eryjus/16bcfs/images/ESP32-pinout.jpg

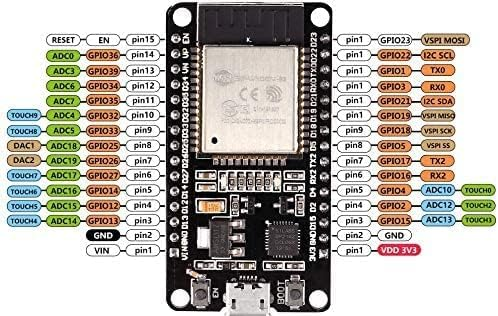
images/ESP32-pinout.jpg
