eryjus/16bcfs/kicad/README.md

# 16-Bit Computer From Scratch KiCad Library

This folder contains the KiCad files used in designing the PCBs.

---

## Videos

I am documenting my 16-Bit Computer build in video form.  You can find the entire playlist [here](https://www.youtube.com/playlist?list=PLUF7WfBe0k3g9wpTtg41QP3jl5y8T1aGV).

---

## License

See [LICENSE.md](../LICENSE.md).

---

## Fitness

Please understand that I do not represent or warranty that these schematics and PCB designs are fit for any purpose including the project for which they were intended.  I would hate for you to invest your own hard-earned money into something that may or may not work for you.  However, you are free to do what you wish with this stuff as stated in the [license](../LICENSE.md).  Just have fun with it.
