eryjus/16bcfs/documents/datasheets/README.md

# 16-Bit Computer From Scratch Documents

This folder contains publicly avilable datasheets for several components used in the build.  By the very nature of these documents being in this folder, the documents contains herein are not current.  If you have interest in any of these components, you are highly encouraged to get the datasheet for the specific manufacturer and component you are going to research.
