eryjus/16bcfs/images/high-level-design.png

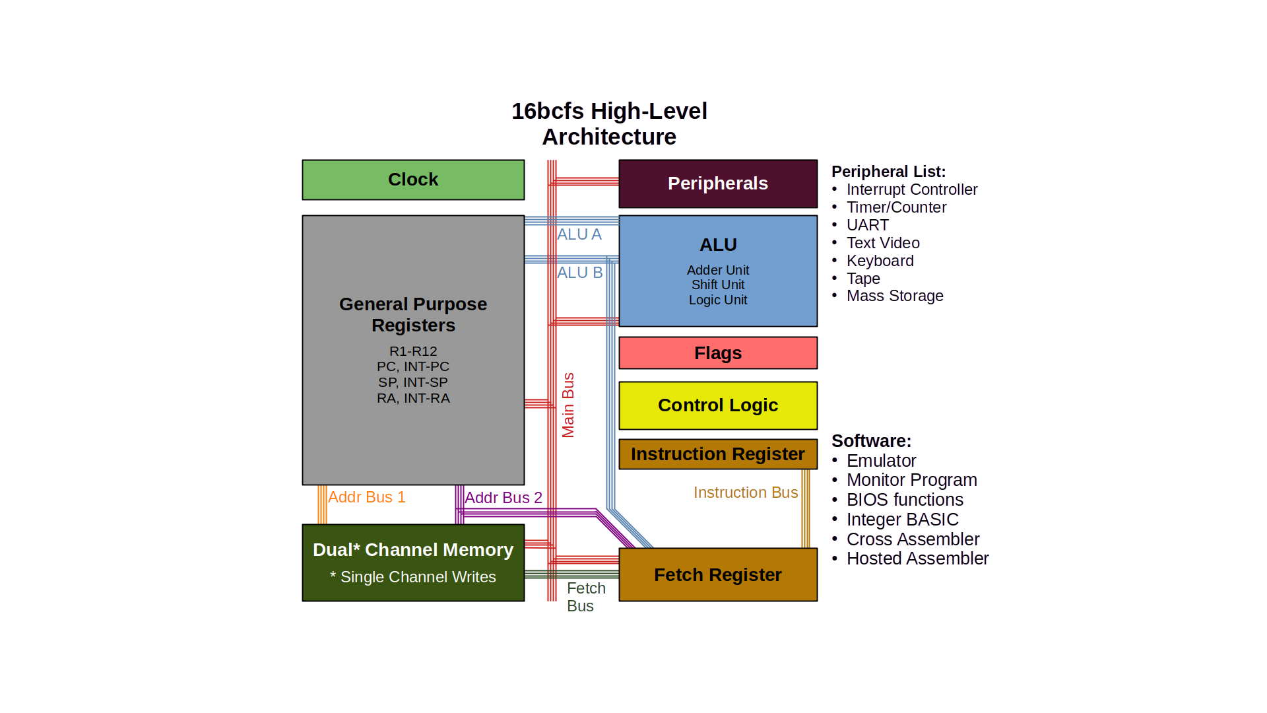
images/high-level-design.png
