eryjus/16bcfs/images/spike-clock-bad.png

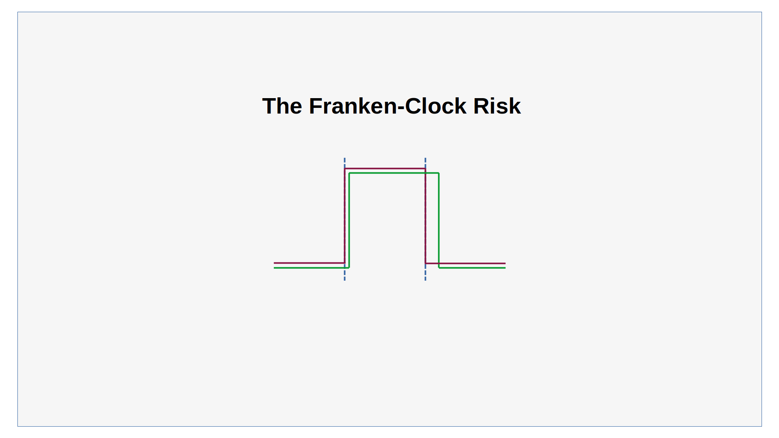
images/spike-clock-bad.png
