eryjus/16bcfs/images/spike-clock-narrow.png

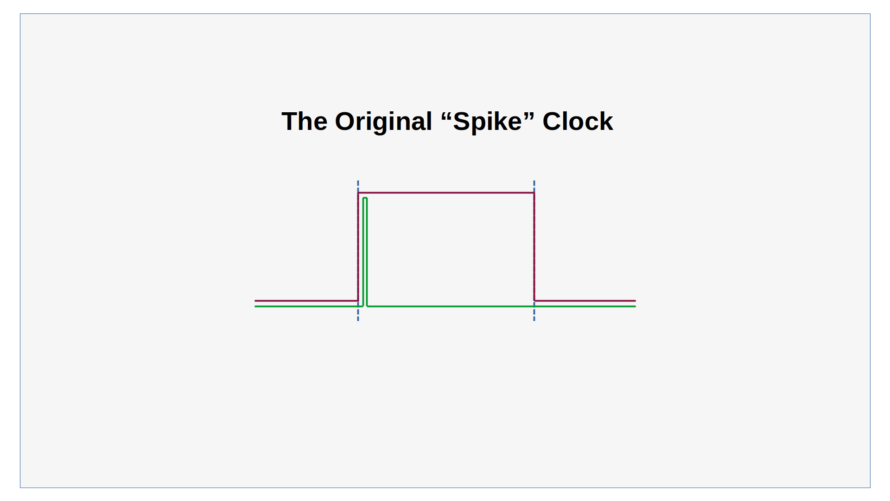
images/spike-clock-narrow.png
