eryjus/16bcfs/documents/16bcfs.ods

Sheet: OpCodes
Instruction | OpCode | None | Imm | Reg | Reg,Reg | Reg,Imm |  | 12-Bit Instruction Count | ALU OP? | Bits Req | Actual Instruction Count | Recovered Instruction Count
 |  | 1 | 1 | 25 | 225 | 25
Add | ADD |  |  |  | X | X |  | 196 | Y
Add with Carry | ADC |  |  |  | X | X |  | 196 | Y
Bitwise And | AND |  |  |  | X | X |  | 506 | Y
Arithmetic Shift Left (into Carry; 0-Fill) | ASL |  |  | X |  |  |  | 22 | Y
Arithmetic Shift Right (Into Carry; Sign-Fill) | ASR |  |  | X |  |  |  | 22 | Y
Break | BRK | X |  |  |  |  |  | 1 |  |  | 1 | 0
Branch to Subroutine | BSR |  | X | X |  |  |  | 14
Clear Carry | CLC | X |  |  |  |  |  | 1 | Y
Clear Overflow | CLV | X |  |  |  |  |  | 1 | Y
Compare using Subtract | CMP |  |  |  | X | X |  | 196 | Y
Decrement | DEC |  |  | X |  |  |  | 22 | Y
Get I/O Device Status | IN |  |  |  | X |  |  | 120
Increment | INC |  |  | X |  |  |  | 22
Software Interrupt | INT | X |  |  |  |  |  | 1
Interrupt Return | IRT | X |  |  |  |  |  | 1
Jump | JMP |  | X | X |  |  |  | 14 |  |  | 1 | 13
Load from Memory | LOD |  |  |  |  |  |  | 12
Logical Shift Left (into Carry; 0-Fill) | LSL |  |  |  |  |  | = ASL | 0 | Y
Logical Shift Right (into Carry; 0-Fill) | LSR |  |  | X |  |  |  | 22 | Y
Move (Reg/Port to Reg/Port) | MOV |  |  |  | X | X |  | 624
Swap & Move (Reg/Port) | MVS |  |  |  |  |  |  | 240
Negate (2's Complement) | NEG |  |  | X |  |  |  | 22 | Y
No Operation | NOP | X |  |  |  |  |  | 1 |  |  | 1 | 0
Bitwise Not | NOT |  |  | X |  |  |  | 22 | Y
Bitwise Or | OR |  |  |  | X | X |  | 506 | Y
Control I/O Device | OUT |  |  |  | X | X |  | 130
Return from Subroutine | RET | X |  |  |  |  |  | 1
Rotate Left (through Carry) | RCL |  |  | X |  |  |  | 22 | Y
Rotate Right (through Carry) | RCR |  |  | X |  |  |  | 22 | Y
Subtract with Borrow | SBB |  |  |  | X | X |  | 196 | Y
Set Carry | STC | X |  |  |  |  |  | 1 | Y
Store Value into Memory | STO |  |  |  |  |  |  | 12
Set Overflow | STV | X |  |  |  |  |  | 1 | Y
Subtract | SUB |  |  |  | X | X |  | 196 | Y
Swap Bytes In Reg | SWP |  |  | X |  |  | = MVS | 0
Test using Bitwise And | TST |  |  | X |  |  |  | 22 | Y
Bitwise Exclusive Or | XOR |  |  |  | X | X |  | 506 | Y
 |  |  |  |  |  |  |  | 3893 |  | 12 | 3 | 13
 |  |  |  |  |  |  | Tracking | 3880
Macros
Push to Stack | PUSH <reg> |  | DEC SP; MOV [SP],<reg>;
Pop from Stack | POP <reg> |  | MOV <reg>,SP; INC SP;
Rotate Left more than 1 bit | ROL <reg>,n |  | ROL <reg>; ROL <reg>; …
Rotate Right more than 1 bit | ROR <reg>,n |  | ROR <reg>; ROR <reg>; …
Shift Left more than 1 bit | SHL <reg>,n |  | SHL <reg>; SHL <reg>; …
Shift Right more than 1 bit | SHR <reg>,n |  | SHR <reg>; SHR <reg>; …

Sheet: Instructions
 | 0 | 1 | 2 | 3 | 4 | 5 | 6 | 7 | 8 | 9 | A | B | C | D | E | F
000 | NOP | BRK | JMP imm
010
020
030
040
050
060
070
080
090
0A0
0B0
0C0
0D0
0E0
0F0
100
110
120
130
140
150
160
170
180
190
1A0
1B0
1C0
1D0
1E0
1F0
200
210
220
230
240
250
260
270
280
290
2A0
2B0
2C0
2D0
2E0
2F0
300
310
320
330
340
350
360
370
380
390
3A0
3B0
3C0
3D0
3E0
3F0
400
410
420
430
440
450
460
470
480
490
4A0
4B0
4C0
4D0
4E0
4F0
500
510
520
530
540
550
560
570
580
590
5A0
5B0
5C0
5D0
5E0
5F0
600
610
620
630
640
650
660
670
680
690
6A0
6B0
6C0
6D0
6E0
6F0
700
710
720
730
740
750
760
770
780
790
7A0
7B0
7C0
7D0
7E0
7F0
800
810
820
830
840
850
860
870
880
890
8A0
8B0
8C0
8D0
8E0
8F0
900
910
920
930
940
950
960
970
980
990
9A0
9B0
9C0
9D0
9E0
9F0
A00
A10
A20
A30
A40
A50
A60
A70
A80
A90
AA0
AB0
AC0
AD0
AE0
AF0
B00
B10
B20
B30
B40
B50
B60
B70
B80
B90
BA0
BB0
BC0
BD0
BE0
BF0
C00
C10
C20
C30
C40
C50
C60
C70
C80
C90
CA0
CB0
CC0
CD0
CE0
CF0
D00
D10
D20
D30
D40
D50
D60
D70
D80
D90
DA0
DB0
DC0
DD0
DE0
DF0
E00
E10
E20
E30
E40
E50
E60
E70
E80
E90
EA0
EB0
EC0
ED0
EE0
EF0
F00
F10
F20
F30
F40
F50
F60
F70
F80
F90
FA0
FB0
FC0
FD0
FE0
FF0

Sheet: 16-Bit Computer From Scratch
 |  |  |  |  | MOV |  | ALU Add |  | ALU Logic |  | ALU Other | IN |  | OUT |  | LOD/STO | BRA/JMP | MVS
 |  |  |  |  | 26 | 24 | 14 | 14 | 22 | 23 | 22 | 10 | 12 | 13 | 10 | 12 | 14 | 12 | 10
Registers: | Reg (PCB) # | Name | Ctl Sel/Idx | Description | SRC | DST | A | B | A | B | A | SRC | DST | SRC | DST | A | A | SRC | DST
 |  | RZ (none) | 0x00 | Zero Register (No Register Selected); asserts 0x0000 | Y |  |  | Y
 | 1 | R1 | 0x01 | R1 General Purpose Register | Y | Y | Y | Y | Y | Y | Y |  | Y | Y |  | Y | Y | Y
 | 2 | R2 | 0x02 | R2 General Purpose Register | Y | Y | Y | Y | Y | Y | Y |  | Y | Y |  | Y | Y | Y
 | 3 | R3 | 0x03 | R3 General Purpose Register | Y | Y | Y | Y | Y | Y | Y |  | Y | Y |  | Y | Y | Y
 | 4 | R4 | 0x04 | R4 General Purpose Register | Y | Y | Y | Y | Y | Y | Y |  | Y | Y |  | Y | Y | Y
 | 5 | R5 | 0x05 | R5 General Purpose Register | Y | Y | Y | Y | Y | Y | Y |  | Y | Y |  | Y | Y | Y
 | 6 | R6 | 0x06 | R6 General Purpose Register | Y | Y | Y | Y | Y | Y | Y |  | Y | Y |  | Y | Y | Y
 | 7 | R7 | 0x07 | R7 General Purpose Register | Y | Y | Y | Y | Y | Y | Y |  | Y | Y |  | Y | Y | Y
 | 8 | R8 | 0x08 | R8 General Purpose Register | Y | Y | Y | Y | Y | Y | Y |  | Y | Y |  | Y | Y | Y
 | 9 | R9 | 0x09 | R9 General Purpose Register | Y | Y | Y | Y | Y | Y | Y |  | Y | Y |  | Y | Y | Y
 | 10 | R10 | 0x0A | R10 General Purpose Register | Y | Y | Y | Y | Y | Y | Y |  | Y | Y |  | Y | Y | Y
 | 11 | R11 | 0x0B | R11 General Purpose Register | Y | Y | Y | Y | Y | Y | Y |  | Y | Y |  | Y | Y | Y
 | 12 | R12 | 0x0C | R12 General Purpose Register | Y | Y | Y | Y | Y | Y | Y |  | Y | Y |  | Y | Y | Y
 | 13 | SP | 0x0D | User Stack Pointer | Y | Y | Y
 | 14 | RA | 0x0E | User Return Address | Y | Y | Y |  |  |  |  |  |  |  |  |  | Y
 | 15 | PC | 0x0F | User Program Counter
 | 16 | INTSP | 0x10 | Interrupt Stack Pointer
 | 17 | INTRA | 0x11 | Interrupt Return Address
 | 18 | INTPC | 0x12 | Interrupt Entry Point (& Program Counter)
 |  | Fetch | 0x13 | Fetch Register | Y |  |  | Y |  | Y |  |  |  | Y |  |  | Y
 |  | Dev1 | 0x14 | I/O Device #1 (Interrupt Controller) | Y | Y |  |  | Y | Y | Y | Y |  |  | Y |  |  |  | Y
 |  | Dev2 | 0x15 | I/O Device #2 (Timer) | Y | Y |  |  | Y | Y | Y | Y |  |  | Y |  |  |  | Y
 |  | Dev3 | 0x16 | I/O Device #3 (Text Video) | Y | Y |  |  | Y | Y | Y | Y |  |  | Y |  |  |  | Y
 |  | Dev4 | 0x17 | I/O Device #4 (Keyboard) | Y | Y |  |  | Y | Y | Y | Y |  |  | Y |  |  |  | Y
 |  | Dev5 | 0x18 | I/O Device #5 (UART) | Y | Y |  |  | Y | Y | Y | Y |  |  | Y |  |  |  | Y
 |  | Dev6 | 0x19 | I/O Device #6 (Tape?) | Y | Y |  |  | Y | Y | Y | Y |  |  | Y |  |  |  | Y
 |  | Dev7 | 0x1A | I/O Device #7 (Floppy?) | Y | Y |  |  | Y | Y | Y | Y |  |  | Y |  |  |  | Y
 |  | Dev8 | 0x1B | I/O Device #8 | Y | Y |  |  | Y | Y | Y | Y |  |  | Y |  |  |  | Y
 |  | Dev9 | 0x1C | I/O Device #9 | Y | Y |  |  | Y | Y | Y | Y |  |  | Y |  |  |  | Y
 |  | Dev10 | 0x1D | I/O Device #10 | Y | Y |  |  | Y | Y | Y | Y |  |  | Y |  |  |  | Y
 |  | Memory | 0x1E | Memory I/O
 |  | N/A | 0x1F
 |  | ALU | 0x20 | ALU Adder Result
 |  | ALU | 0x21 | ALU Logic Unit Result
 |  | ALU | 0x22 | ALU Shifter Result
 |  | N/A | 0x23
 |  | Ctl1 | 0x24 | Control I/O Device #1 (Interrupt Controller)
 |  | Ctl2 | 0x25 | Control I/O Device #2 (Timer)
 |  | Ctl3 | 0x26 | Control I/O Device #3 (Keyboard)
 |  | Ctl4 | 0x27 | Control I/O Device #4 (Video)
 |  | Ctl5 | 0x28 | Control I/O Device #5 (UART)
 |  | Ctl6 | 0x29 | Control I/O Device #6 (Tape?)
 |  | Ctl7 | 0x2A | Control I/O Device #7 (Floppy?)
 |  | Ctl8 | 0x2B | Control I/O Device #8
 |  | Ctl9 | 0x2C | Control I/O Device #9
 |  | Ctl10 | 0x2D | Control I/O Device #10
 |  | N/A | 0x2E
 |  | N/A | 0x2F
 |  | N/A | 0x30
 |  | N/A | 0x31
 |  | N/A | 0x32
 |  | N/A | 0x33
 |  | N/A | 0x34
 |  | N/A | 0x35
 |  | N/A | 0x36
 |  | N/A | 0x37
 |  | N/A | 0x38
 |  | N/A | 0x39
 |  | N/A | 0x3A
 |  | N/A | 0x3B
 |  | N/A | 0x3C
 |  | N/A | 0x3D
 |  | N/A | 0x3E
 |  | N/A | 0x3F
Addressing Modes: | Number | Name | Example | Description
 | 0 | None |  | No addressing mode included in instruction (HLT)
 | 1 | Imm | $1234 | This instruction contains a single argument which is a constant in the instruction stream(JMP $0xe000)
 | 2 | Imm_Ind | [1234] | This is an address Location which contains that value to use (JMP [0xe000])
 | 3 | Reg | R1 | Instuction contains a single register as its target (INC R1)
 | 4 | Reg_Ind | [R1] | R1 contains the value of an address of a memory location on which to operate (INC [R1])
 | 5 | Reg,Reg | R1,R2 | Instruction contains 2 arguments, each are registers (ADD R1,R2)
 | 6 | Reg,Imm | R1,$1234 | Instrution contains 1 target register, and 1 constant in the instruction stream (ADD R1,$255)
 | 7 | Imm_Ind,Reg | [1234],R1 | Instruction contains a memory location and a register (STO [1234],R1)
 | 8 | Reg,Imm_Ind | R1,[1234] | Instruction contains a register memory location (LOD R1,[1234])
 | 9 | Reg_Ind,Reg | [R2],R1 | Instruction contains a Register with the memory Location and a register (STO [R2],R1)
 | 10 | Reg,Reg_Ind | R1,[R2] | Instruction contains a register memory location (LOD R1,[1234])
Register Select Uses | Registers | Use | Ctl Select
Standard Registers | RZ - PC | (Typical) | 0b00
Extended Data | INTSP - Mem | (Data) | 0b01
IO Control | Ctl1 - Ctl10 | (Control) | 0b10
Instruction Suffix | N/A | (Instructions) | 0b11 | Not currently planned; maybe for future expansion
Conditional Execution | Mnemonic | Encoding |  | Condition (Note: L = 1 when N != V)
Always | .AL or None | 0000
Never | .NV | 0001
Equal | .EQ | 0010 |  | Z = 1
Not Equal | .NE | 0011 |  | Z = 0
Carry Set | .CS | 0100 |  | C = 1
Carry Clear | .CC | 0101 |  | C = 0
Minus | .MI | 0110 |  | N = 1
Positive or Zero | .PL | 0111 |  | N = 0
Overflow Set | .VS | 1000 |  | V = 1
Overflow Clear | .VC | 1001 |  | V = 0
Unsigned Higher | .HI | 1010 |  | C = 1 and Z = 0
Lower or Same | .LS | 1011 |  | C = 0 or Z = 1
Signed Greater or Equal | .GE | 1100 |  | L = 0
Signed Less Than | .LT | 1101 |  | L = 1
Signed Greater Than | .GT | 1110 |  | Z = 0 and L = 0
Signed Less Than or Equal | .LE | 1111 |  | Z = 1 or L = 1

Sheet: Build Sequence
Video | Description | OpCodes | Instr Enc | Total Enc
113 | Fetch/Instruction Register Breadboards | NOP | 1 | 1
114 | Program Counter Breadboard & Program ROM | BRK JMP imm | 2 | 3
115 | Fetch/Instruction PCBs |  |  | 3
116 | Clock PCB |  |  | 3
117 | Reset PCB |  |  | 3
118 | C/R/I/F Mid-Plane |  |  | 3
119 | R1, R2 GPRs (Fetch Suppress Cleanup) | MOV reg,imm MOV reg,reg MVS reg,reg JMP reg INC reg DEC reg SWP reg | 18 | 21
120 | GP Register PCB |  |  | 21
121 | Register Mid-Plane PCB (R1-R12, PC) |  | 1038 | 1059
122 | RA GPR | BSR imm BSR reg RET | 6 | 1065
123 | ALU Adder | ADD reg,imm ADD reg,reg | 255 | 1320
124 | Carry Select | ADC reg,imm ADC reg,reg | 255 | 1575
125 | ALU Flags (Pgm) | CLC STC CLV STV | 4 | 1579
126 | Conditional Execution |  |  | 1579
127 | Invert ALUb | CMP reg,imm CMP reg,reg SUB reg,imm SUB reg,reg SBB reg,imm SBB reg,reg NEG reg | 777 | 2356
128 | ALU Logic Unit | AND reg,imm AND reg,reg OR reg,imm OR reg,reg TST reg,imm TST reg,reg XOR reg,imm XOR reg,reg | 672 | 3028
129 | ALU Shift Unit | ASL reg ASR reg LSL reg LSR reg ROL reg ROR reg ASL reg,x ASR reg,x LSL reg,x LSR reg,x ROL reg,x ROR reg,x | 60 | 3088
130 | ALU Adder Unit PCB |  |  | 3088
131 | ALU Logical Unit PCB |  |  | 3088
132 | ALU Shift Unit PCB |  |  | 3088
133 | ALU Flags PCB |  |  | 3088
134 | ALU Mid-Plane (2 Flags Regs) |  |  | 3088
135 | RAM | LOD reg,[imm] LOD reg,[reg] STO [imm],reg STO [reg],reg PUSH reg POP reg | 344 | 3432
136 |  |  |  | 3432
137 |  |  |  | 3432
138 |  |  |  | 3432
 |  |  |  | 3432
