eryjus/16bcfs/16bcfs-tests/README.md

# 16-Bit Computer From Scratch -- Test Code

This is the source code that supports my *16-Bit Computer From Scratch* project.  This project in particular contains all the source code I use to test parts of the computer as it is being built.

---

## Videos

I am documenting my 16-Bit Computer build in video form.  You can find the entire playlist [here](https://www.youtube.com/playlist?list=PLUF7WfBe0k3g9wpTtg41QP3jl5y8T1aGV).

---

## License

See [LICENSE.md](LICENSE.md).

---

## EEPROM Programmer

I do not have a commercial EEPROM programmer.  I use the TommyPROM programmer.  You can find all the relevant information on TommyPROM [here](https://tomnisbet.github.io/TommyPROM/).  In Linux, I use `minicom` as the interface.  Hint: use `sudo minicom -s` to set up the defaults.
