eryjus/16bcfs/(threads)

Thread 2 (2023-11-19):

Combine the UI and Hardware emulator into a single class

eryjus, 2023-11-19:
The current design is a mistake, causing extra work to be completed with each change.

Combining the 2 classes will allow all the `connect`ions to be handled in one place, making the resulting KiCad schematics easier to manage.

Closed 2023-11-19.

Thread 3 (2023-11-19):

Create a new Clock Module schematic

eryjus, 2023-11-19:
This new clock module will properly separate the clock from the reset circuitry.  Reset will now be handled separately.

This new Clock Module schematic will be built based on the hardware components (like the 555 for single step) and based on the emulator for the digital circuits.

eryjus, 2023-11-23:
This is created in Video 82, Part 7 and presented as a complete work in Part 8

Closed 2023-11-25.

Thread 5 (2023-11-19):

Create a proper Clock Module for the emulator, properly defining its interface points

eryjus, 2023-11-19:
The Clock Module is currently just a mess of components spread across several sources.  This really should be consolidated into a single module, which would correspond to the proper kicad schematic and PCB.

eryjus, 2023-11-23:
This is presented in Video 82, Part 6

Closed 2023-11-25.

Thread 8 (2023-11-20):

Add a Control Signal which will place the clock in single step mode

eryjus, 2023-11-20:
This control signal will be used as a `BRK` opcode in the final computer, placing the computer into step mode.  Ultimately, this circuit will be implemented as a Leading Edge Detector (inverted) from the AND8408 document from OnSemi.

It will contain an RC circuit which will not be directly emulated.  The results can be emulated.

eryjus, 2023-11-22:
This coding is now complete and is presented in Video 82, Part 5.

Closed 2023-11-25.

Thread 9 (2023-11-20):

Create a Reset Control Signal for the clock

eryjus, 2023-11-20:
This signal should be an active-low signal to conform to the voltage supervisor.  This signal will place the clock into run mode, overriding any existing mode on the clock.

This reset would be triggered on power-on and by manual input.  Note that a separate signal will be used elsewhere (not by the clock) to hold the cpu in reset until all modules were ready.  This would be an open-drain type circuit with a pull-up resistor.

eryjus, 2023-11-22:
This coding is now complete and is presented in Video 82, Part 5.

Closed 2023-11-25.

Thread 10 (2023-11-23):

Need to separate the Load signal from Inc/Dec on the GP Register

eryjus, 2023-11-23:
The current design of the GP-Register is killing the build.  The fatal flaw is the Load signal was combined with the Inc and Dec signals.  This needs to be corrected.

To accomplish this, the counter will be pulled in parallel with the the outputs on each bus, and bus output will be replaced with 74HC574 Latches instead of 74HC541 Line Drivers.

To get this right, a small internal GP-Register bus local to the one register will be needed, which will be able to take input from the main bus externally, or the counter output internally.

Closed 2023-12-04.

Thread 11 (2023-11-23):

Create a Schematic for the new GP-Register

eryjus, 2023-11-23:
Once the GP-Register is emulating properly, create a KiCad schematic for this.  This will be after the module appears to be working properly but before the in-depth testing is completed.

eryjus, 2023-12-11:
This is the main purpose of Video 84 and is complete.

Closed 2023-12-20.

Thread 19 (2023-11-24):

Create a Reset Hold (#RHLD) signal where a module can hold the cpu in reset if desired

eryjus, 2023-11-24:
This would be implemented as a single-bit bus.

eryjus, 2024-04-04:
This has been done for the Control ROM Control Module.  It was tested with an ESP32.  This is close to being completed at least in principle.

Closed 2024-11-15.

Thread 25 (2023-12-11):

Reset is dependent on the latch in the Register Module

eryjus, 2023-12-11:
This may or may  not be a problem.  Monitor this and determine if a fix is required.

eryjus, 2024-12-02:
This is going to be a non-issue.  The Reset signal for the GP-Register (R̅H̅L̅D̅) will hold the Up/Down counters in clear.  The clock will latch that value.

Closed 2024-12-02.

Thread 31 (2023-12-11):

Create a Reset Module, which will hold the CPU in Reset as long as needed to complete all initialization

eryjus, 2023-12-11:
The emulator needs to be able to be reset.  This will happen on power-on, manually triggering a reset, or when the voltage gets too low (on real hardware only).

Closed 2024-11-15.

Thread 34 (2023-12-12):

Add labels to the assembler

eryjus, 2023-12-12:
The assembler needs to support labels.  Add this ability to the assembler.  Both backward and forward references need to be supported.

Also, intermediate jump points (`.1`) need to be supported as well.

Since I believe that this worked at some point prior, I am calling this a bug and will sort this out as such.

Closed 2024-05-09.

Thread 35 (2023-12-12):

Add the ability to create an opcode header file without intruducing a fake source

eryjus, 2023-12-12:
The current workaround is to have a dummy source which is assembled and then the object file removed.  This is clunky and a better option would be to have command line options to generate this file on demand and without a source.

Closed 2024-06-07.

Thread 49 (2023-12-31):

Commit the EEPROM SPI Programmer to solderful breadboard

eryjus, 2023-12-31:
Rather than keeping the new SPI programmer on breadboard, this really should be committed to a solderful breadboard.  This will make it a little more robust while testing prior to committing it to proper PCB.

Closed 2024-01-31.

Thread 65 (2024-01-14):

the first `asm` directive must start in column 1

eryjus, 2024-01-14:
This is not what is wanted and is preventing some testing from taking place.

To clarify: this is what is designed into the scanner, and should be able to differentiate between architecture directives and assembler directives.  The key difference is that there needs to be something that better differentiates between them.  Once thought is to replace the leading period in the architecture directives with a colon so that they can be easily identified.

So, rather than `.little-endian`, the directive would be `:little-endian` and would remain at the start of the line, whereas the other assembler directives could appear anywhere (`.org`).

eryjus, 2024-01-14:
No longer a blocking issue

eryjus, 2024-05-05:
Currently, `.arch`, `.path` and `.include` all need to appear at the start of a line.  All the architecture definition directives need to be be at the start of a line, but are all preceded with a `'.'` character.

The only other 2 assembler directives are currently `.org` and `.db` and both can appear anywhere.

So, here is what I propose:
1. All architecture directives are replaced with a `':'` character.
2. `.arch`, `.path` and `.include` are replaced with a `'%'` character as they all deal fundamentally with files.
3. `.org` and `.db` remain unchanged.

This change will also trigger updates to the test code and the test automation.

eryjus, 2024-05-05:
These changes have been made and all tests updated.

Closed 2024-05-09.

Thread 77 (2024-01-23):

Create a Control ROM Controller

eryjus, 2024-01-23:
This controller will handle holding the circuit in reset until the copy is complete.  It will handle multiplexing the Control ROM copy address and the Instruction which will be needed while running.  It will handle the serial shift into the SPI EEPROM as all Control ROMs will need the same signals.  It will contain its own clock for the sake of speed (selectable?), but after reset the clock will be handled by the normal system clock.  These are likely to be separate clock signals.

Closed 2024-01-30.

Thread 90 (2024-01-31):

Determine if Power-On Reset needs to be separated from soft reset

eryjus, 2024-01-31:
Power-On Reset would copy the Control ROMs to SRAM.  Soft Reset would not.

However, need to figure out about the monitor program/boot loader ROM.  No need to ignore the Control ROMs if the Program ROMs need to be copied.

Closed 2024-11-15.

Thread 96 (2024-02-05):

Video-0092: Control ROM Modules

eryjus, 2024-02-05:
The goal of this video is to:
* Emulate the control ROMs properly
* Create a schematic for the control ROM
* Build the Control ROM onto breadboard
* Build the Control ROM Control onto breadboard

Therefore, the issues included in this video are:
- [ ] #87
- [x] #78
- [x] #32
- [x] #93
- [ ] #94
- [ ] #95
---
- [ ] #97
- [ ] #99
- [x] #81
- [x] #100

Closed 2024-02-17.

Thread 97 (2024-02-16):

Emulator is not resetting properly

eryjus, 2024-02-16:
Reset is happening as each object is created.  However, there is the creation & wire-up phase which all needs to happen at once and then there will need to be a reset event once everything is connected properly.

The emulator does not do this.

This needs to be corrected immediately.

eryjus, 2024-02-16:
This is partially updated, but not nearly properly taken care of.

Thread 103 (2024-02-17):

Video-0093

eryjus, 2024-02-17:
This is a continuation from Video-0092.  The remaining goals from that video are:

* Create a schematic for the control ROM
* Build the Control ROM onto breadboard
* Build the Control ROM Control onto breadboard

---

The issues included in this video are:
- [x] #104
- [x] #105
- [x] #99
- [x] #87
- [ ] #94
- [ ] #95

Closed 2024-02-27.

Thread 104 (2024-02-17):

74HC03 is really a NAND gate

eryjus, 2024-02-17:
This is configured in the emulator as an AND gate.  This all needs to be corrected.

It currently is only used in the `CtrlRomCtrlModule_t` class in one place, so the cleanup should be easy.

It is also wrong in KiCad, having copied an AND gate rather than a NAND gate.  The symbol library needs to be cleaned up as well.

Closed 2024-02-27.

Thread 109 (2024-02-27):

Clean up the temporary breadboard "bodge" wires

eryjus, 2024-02-27:

Closed 2024-03-12.

Thread 118 (2024-03-12):

Complete Automated Testing for Control ROM Circuits

eryjus, 2024-03-12:
The Control ROM and its circuits need to have a complete test executed.  This test is best automated.

Therefore, create an Arduino (ESP32) sketch to execute the tests on the control circuits and confirm that it is working perfectly.

Closed 2024-03-31.

Thread 134 (2024-04-27):

Video-0098 Plan

eryjus, 2024-04-27:
Video 0098 will focus on multiplexing several bus signals at the control logic.  This multiplexing will be used to prevent multiple items from asserting onto a bus at the same time.

This video is intended to handle the full story of the build:

Concept:
- [x] Bus identification
- [x] Publishers for each bus (instruction review)
- [x] Flavors of multiplexing (3 types?)

Control Logic Build:
- [x] #136

Emulator:
- [x] #135
- [x] #98
- [x] #137
- [x] #139

KiCad:
- [x] Build a 74HC238 IC and Footprint
- [x] Schematic build (3-, 4-, & 7-bit schematics)

Add-Ons:
- [x] #65
- [x] #63
- [x] #144
- [x] #143
- [x] #142
- [x] #61
- [x] #59
- [x] #56
- [x] #36
- [x] #34

There will not be a need to develop PCB designs yet.

Closed 2024-05-09.

Thread 145 (2024-05-08):

Change Assembler to be 16bcfs-specific

eryjus, 2024-05-08:
Remove the ability for the assembler to target multiple architectures.  This will simplify the assembler quite a bit.

- [ ] #35

eryjus, 2024-05-24:
I have started this assembler and it is working (I believe) up to the same point as the published assembler (except for generating the header for the control ROM logic).  It is currently hosted in GitHub as a private repo.

The next steps here will be to copy over all the test code from each episode and make sure they all assemble properly.  Labels are working properly now.  I may even try to take on some additional tasks

Closed 2024-06-07.

Thread 154 (2024-06-10):

Revisit the LED Line Driver for the Control ROM Module in the Emulator

eryjus, 2024-06-10:
There is a concern with the location of the LEDs in the emulator in the Control ROM Module.  When the location of the LEDs is in the correct location, only the quick copy works in the full emulator (as of Video 101).  On the other hand, when the LEDs are on the bus, the pedantic copy works but the quick copy does not update the data properly.

This is most likely a timing or sequencing problem.  But it works properly on breadboard and the Schematic and PCB were built from a working circuit.  It would be nice to have the emulator working 100%.

Closed 2024-08-25.

Thread 162 (2024-06-23):

Emulator Clock tick is too linear

eryjus, 2024-06-23:
Currently in the emulator a clock tick is handled completely linearly from end to end in a single function (slot) call.  As a result, the sequence in which items are constructed and "wired up" matters.  More than it should.

One solution I think needs to be implemented is to split the clock cycle into 2 parts, each with the following tasks to complete.

* Phase 1 would capture the inputs as they currently stand.  No outputs would change with this phase.  These new values would be stored internally to the component.  So signals would be sent.
* Phase 2 would then extend the new values to the outputs.  At this point, the signals would be offered to any subscribing slots, allowing the changes to finally be propagated to downstream inputs.

This would require a change to the Clock Module to issue both signals in turn.

Now, this may create additional issues as a clock signal might be inverted and since an inverter is not going to handle the second clock signal, the significance would be lost.

~So, in Qt6, is it possible to list or iterate of all subscribers?~

Maybe it is not relevant to propagate down each signal and slot relationship....  Could it be good enough that each object contains an optional slot to be called by the Clock Module signal once the clock tick is complete?

---

Normal connections exist; add a new connection of Latch to Clock subscribing to `Complete Clock Transition`.

D -> Latch Input
Clock -> Inv -> Latch Clk

* D is updated, presented on Latch Input.
* Clock is updated HIGH; Inv Updates input and ouput; Latch is presented its new clock State LOW; no changes.
* Clock sends out its `Complete Clock Transition` signal; Latch checks current Clock input & does nothing.
* Clock is updated LOW; Inv Updates input and ouput; Latch is presented its new clock State HIGH; captures new state.
* Clock sends out its `Complete Clock Transition` signal; Latch checks current Clock input & presents new outputs.

Closed 2024-08-30.

Thread 170 (2024-08-25):

Video-0104

eryjus, 2024-08-25:
This video will focus on assembling the Control ROM Control Module PCB and 16 of the Control ROM Modules.  The objective in this video will be to get these modules 100% ready for placement into the Control Logic Mid-Plane -- which is intended to be assembled in the next video.

In alignment with getting these modules ready, the Control ROM Control Module has some changes which need to be updated in the schematic and PCB design.  These will be updated as well.

- [ ]

Closed 2024-09-09.

Thread 171 (2024-08-30):

Control ROM Control Module LED removal

eryjus, 2024-08-30:
The Control ROM Control Module does not need LEDs since the information displayed would be incongruent with the values latched.  So, remove the LEDs (driver and resistors as well) from the schematic and PCB design.  No need to materially change the footprint.

Change the capacitance values from 0.1uF to 100nF.

Closed 2024-12-25.

Thread 172 (2024-08-30):

Control ROM Module silkscreen

eryjus, 2024-08-30:
The Control ROM Module does not have a proper module label on it.  In addition, the reference markings are not close to pin1 and should be corrected.

Closed 2024-12-25.

Thread 173 (2024-09-07):

Control ROM Mid-Plane has a silkscreen error

eryjus, 2024-09-07:
CtrlF is missing.  It was mis-labeled as a second CtrlE.

Can the silkscreen be scraped away as a workaround?

Closed 2024-12-25.

Thread 174 (2024-09-07):

Power Capacitors are too close on the Control Logic Mid-Plane

eryjus, 2024-09-07:
These should be rotated 90 degrees to make the soldering simpler.

Closed 2024-12-25.

Thread 176 (2024-09-09):

Video-0108

eryjus, 2024-09-09:
This video is intended to focus on developing a proper reset circuit.  This circuit will perform the following functions:

* Place the entire circuit into reset (on power up and on demand)
* Hold reset-stepping of the CPU until the all components report in that they are ready for execution
* Hold the registers in clear and suppressing output of the Program ROM/RAM until the reset-stepping is complete to clear the Fetch and the Instruction Registers
* Finally, release the Reset Hold signal so that normal operation can resume

These issues will be completed as part of this design:

- [x] #90
- [x] #31
- [x] #19

Closed 2024-11-15.

Thread 177 (2024-09-14):

Pin alignment for the Control ROM Control Module

eryjus, 2024-09-14:
The pins for the 16-pin wide ROM interconnect appear to be off by 0.05" or 0.1".  This creates an alignment problem when trying to insert the PCB into the mid-plane.

Correct this issue.

Closed 2024-12-25.

Thread 179 (2024-11-03):

Control Logic Control: Rename R̅H̅L̅D̅ to C̅P̅Y̅H̅L̅D̅

eryjus, 2024-11-03:
This signal will now be dedicated to communication with the reset circuit.  The reset circuit will then in turn manage R̅H̅L̅D̅.

At the same time, can the 74HC03 be eliminated in favor of some other unused gate?

While you are at it, the name needs to be cleaned up on the mid-plane as well.

Closed 2024-12-25.

Thread 180 (2024-11-03):

Clean up the bodged signal on the PCB

eryjus, 2024-11-03:
One signal was bodged into a new pin.  This needs to be cleaned up.

Closed 2024-12-25.

Thread 181 (2024-11-03):

The DONE D-Latch might have the signals named backwards

eryjus, 2024-11-03:
I believe this works on PCB, but the names appear to be reversed.  Need to investigate this and clean up the naming if it is wrong.

Closed 2024-12-25.

Thread 182 (2024-11-03):

Video-0109

eryjus, 2024-11-03:
These are the things to do in Video-0109:

- [ ] Update the connections of the 74HC123 in the schematic to use reset
- [ ] Write the 74HC123 into the emulator, using a scheduled trigger (50ms delay)
- [ ] Complete the rename of ~{RHLD} to ~{CPYHLD}
- [ ] Get the emulator working properly with this new reset circuit

Time permitting:
- [ ] #175

Thread 183 (2024-11-03):

Update the connections of the 74HC123 in the schematic to use reset

eryjus, 2024-11-03:

eryjus, 2024-11-15:
This is not needed and will be closed.

Closed 2024-11-15.

Thread 186 (2024-11-03):

Get the emulator working properly with this new reset circuit

eryjus, 2024-11-03:

Closed 2024-11-15.

Thread 187 (2024-11-03):

U7B (74HC74) needs reset/set tied high, not low

eryjus, 2024-11-03:

eryjus, 2024-11-19:
I checked this, and the output is a defined state as it currently is.  No changes required.

Closed 2024-11-19.

Thread 189 (2024-11-04):

Separate out the reset functions to slots

eryjus, 2024-11-04:
Arrange them so that a reset can be performed by signaling a reset, such as pressing the reset button.  This single step should be responsible for putting the emulator into a known good state.

Currently, there are some uninitialized items, like Buses.

Thread 190 (2024-11-05):

The Emulator needs proper circuit reset routines

eryjus, 2024-11-05:
Reset is fubar.  Make it not sucky.

Closed 2024-12-02.

Thread 192 (2024-11-15):

Rewrite the emulator into a V2

eryjus, 2024-11-15:
The emulator needs to be rewritten into a v2 with the following objectives:

- Eliminate code duplication
- Make the code more consistent
- Handle signals/slots better
- Better handle the issue with signal sender identification, which is a problem with the buses

This work is happening in the background and will not see any video time until it is complete.

Here are the issues which are being included herein:

- [ ] #189
- [ ] #190
- [ ] #101

Thread 193 (2024-11-16):

Rename `RESET_CLK` to to `CLK` on the Reset Circuit

eryjus, 2024-11-16:

Closed 2024-12-25.

Thread 196 (2024-12-02):

Reset on Breadboard is not 100% reliable

eryjus, 2024-12-02:
Need to figure out why it is not working properly and address it.

This is a problem, so it needs to be solved prior to ordering PCBs.

Closed 2025-01-24.

Thread 200 (2024-12-24):

Remove the counter circuit from the Clock Module

eryjus, 2024-12-24:
This is handled in the reset circuit and actually causes issues with the Control ROM Midplane.

Closed 2025-01-22.

Thread 215 (2025-02-15):

Video-0114 TODOs

eryjus, 2025-02-15:
The purpose of Video 114 will be to get the Program Counter re-integrated and to get the Program ROM re-integrated.  Both should be relatively easy to accomplish, which is why I am bundling them together.

For this, I have the following items to complete:

### General (off camera)
- [x] _**Deal with power distribution**_
- [x] _**Clean up the Reset & Clock power connections between modules**_
- [x] _**Replace long signal wires with prepared ribbon cable**_

### Break Signal
- [x] Update the Assembler
- [x] Update the Control Logic & Burn new Ctrl Logic EEPROM
- [x] Write a test program for BRK & JMP
- [x] Update the Emulator and Test
- [x] Connect the Break Signal to the Clock Interface
- [x] Unit test manual instruction
- [x] Update Control Logic and Program

### Program Counter
- [x] _**Change the LED resistors to 10K (off Camera)**_
- [x] _**Clean up the issues with the breadboard (check all the signals; off camera)**_
- [x] Unit Test the PCB/Breadboard
- [x] Extend the signals to the breadboard & integrate (16: GND, CLK, GND, VCC, #RHLD, Inc, Dec, Load, GND, 6 X Asserts, GND)
- [x] Integrated Test (should see the PC counting)

### Program ROM
- [x] Change #CE to be hooked up to #RHLD
- [x] Extend #OE to be a control signal hooked up to Fetch Suppress
- [x] Connect Program ROM output to Fetch Register Input
- [x] Unit Test the Program ROM
- [x] Connect Address Bus 1 to Program ROM Address Input
- [x] Burn new Program ROM for BRK & JMP
- [x] Integrated Testing (should be able to change to single step and JMP to loop)

Closed 2025-04-20.
