eryjus/16bcfs/kicad/projects/16bcfs/clock-module/clock-module.pdf

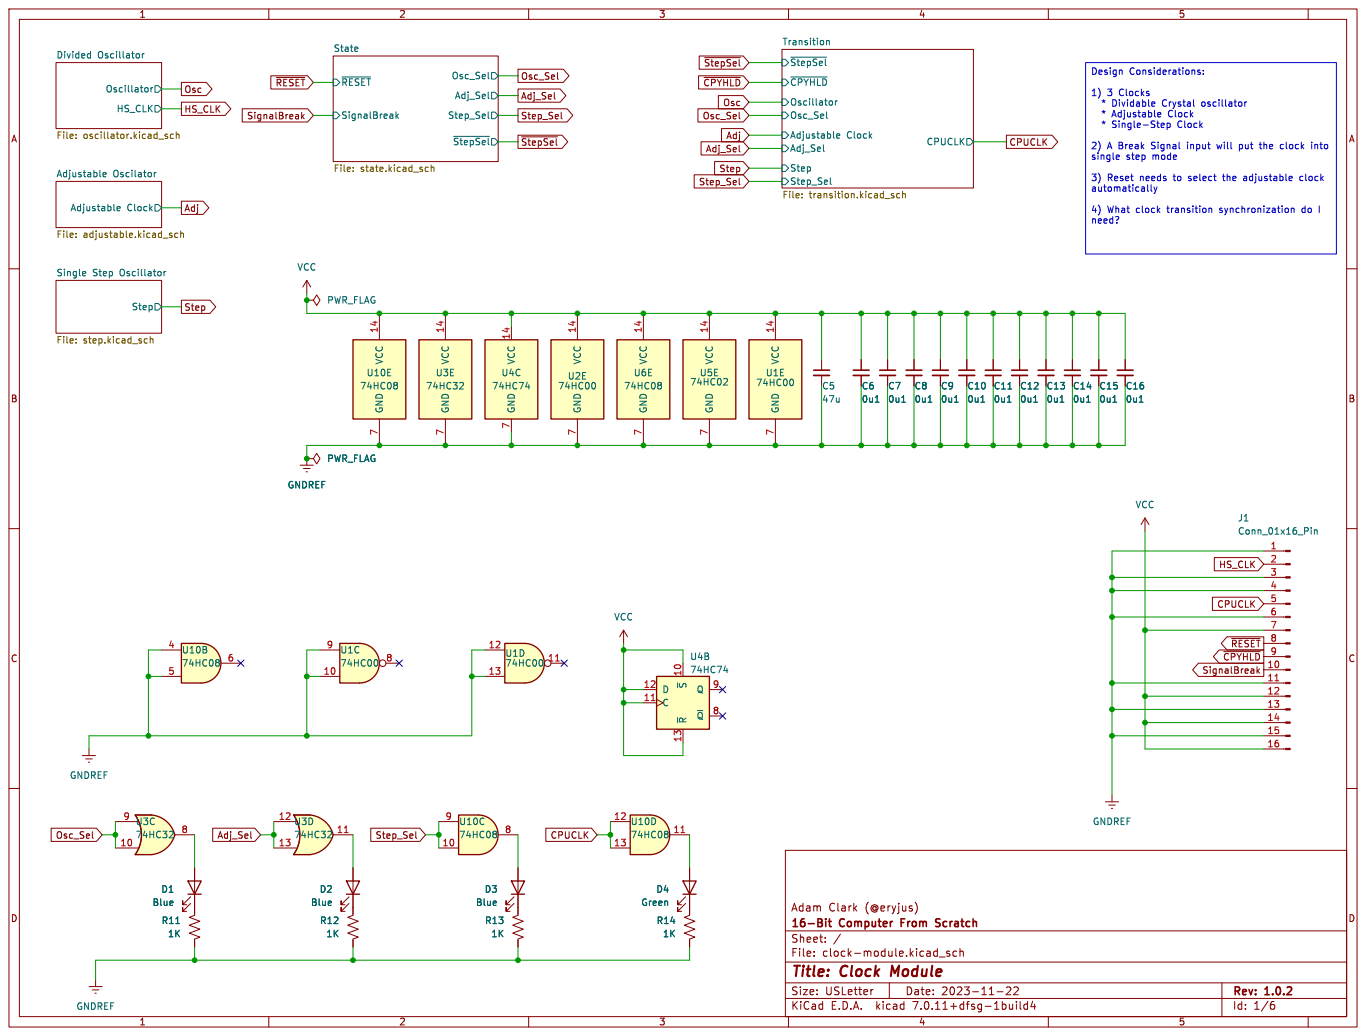
[picture p7: page 1]

~{StepSel} State File: state.kicad_sch VCC 14 GND

~{StepSel} Transition File: transition.kicad_sch Osc_Sel Adj_Sel

Single Step Oscillator File: step.kicad_sch

Id: 1/6 Title: Clock Module

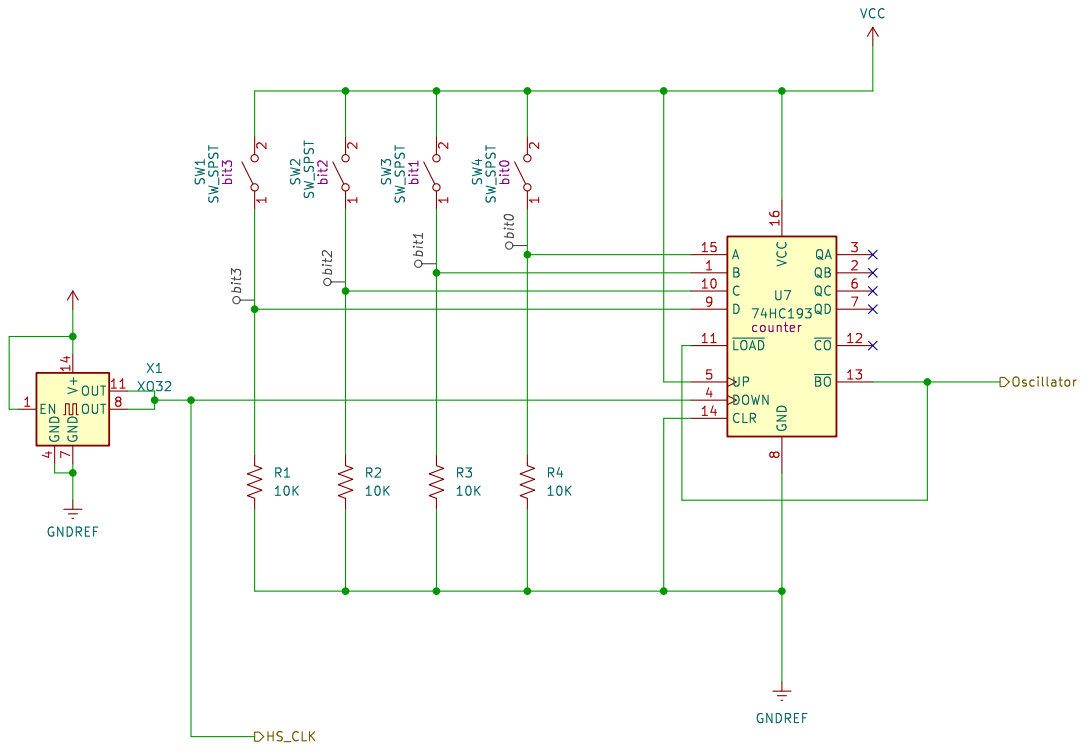
[picture p8: page 2]

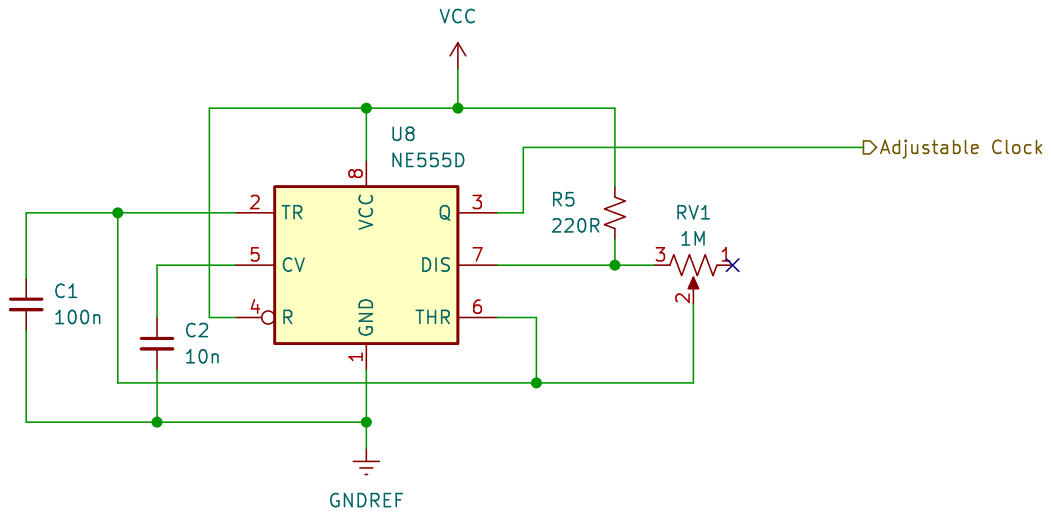
[picture p9: page 3]

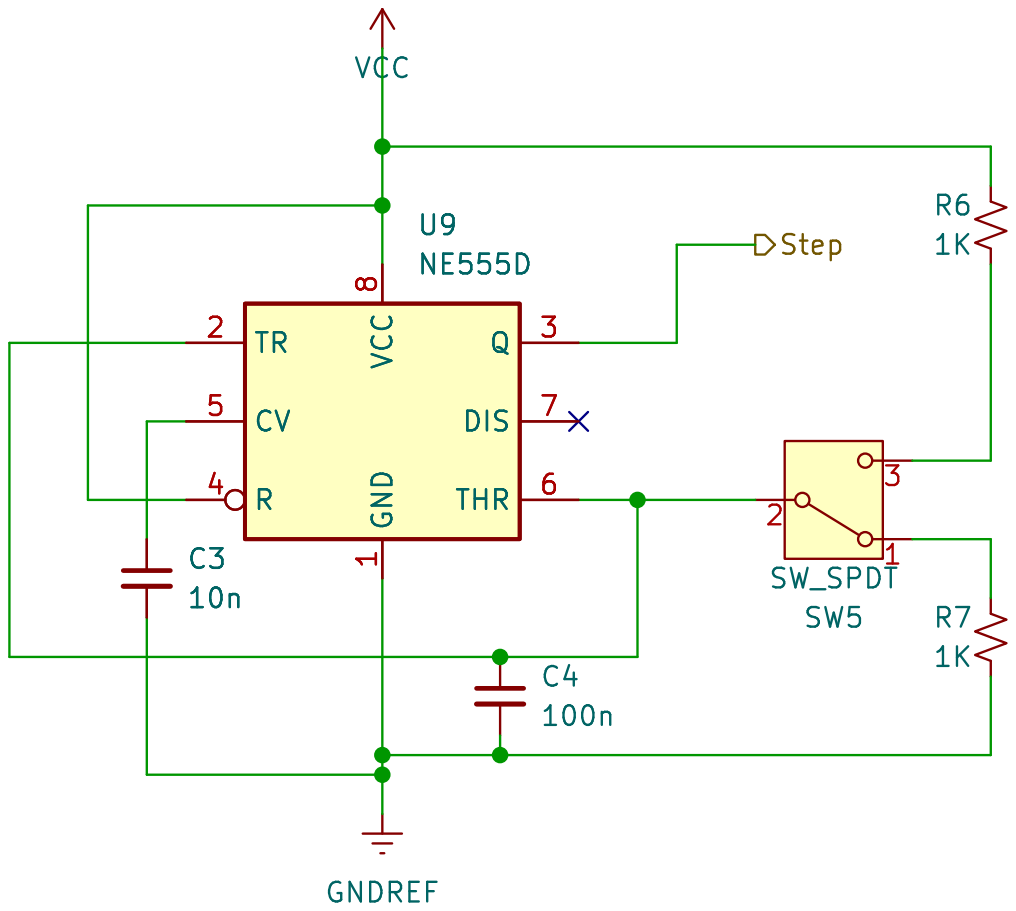
[picture p10: page 4]

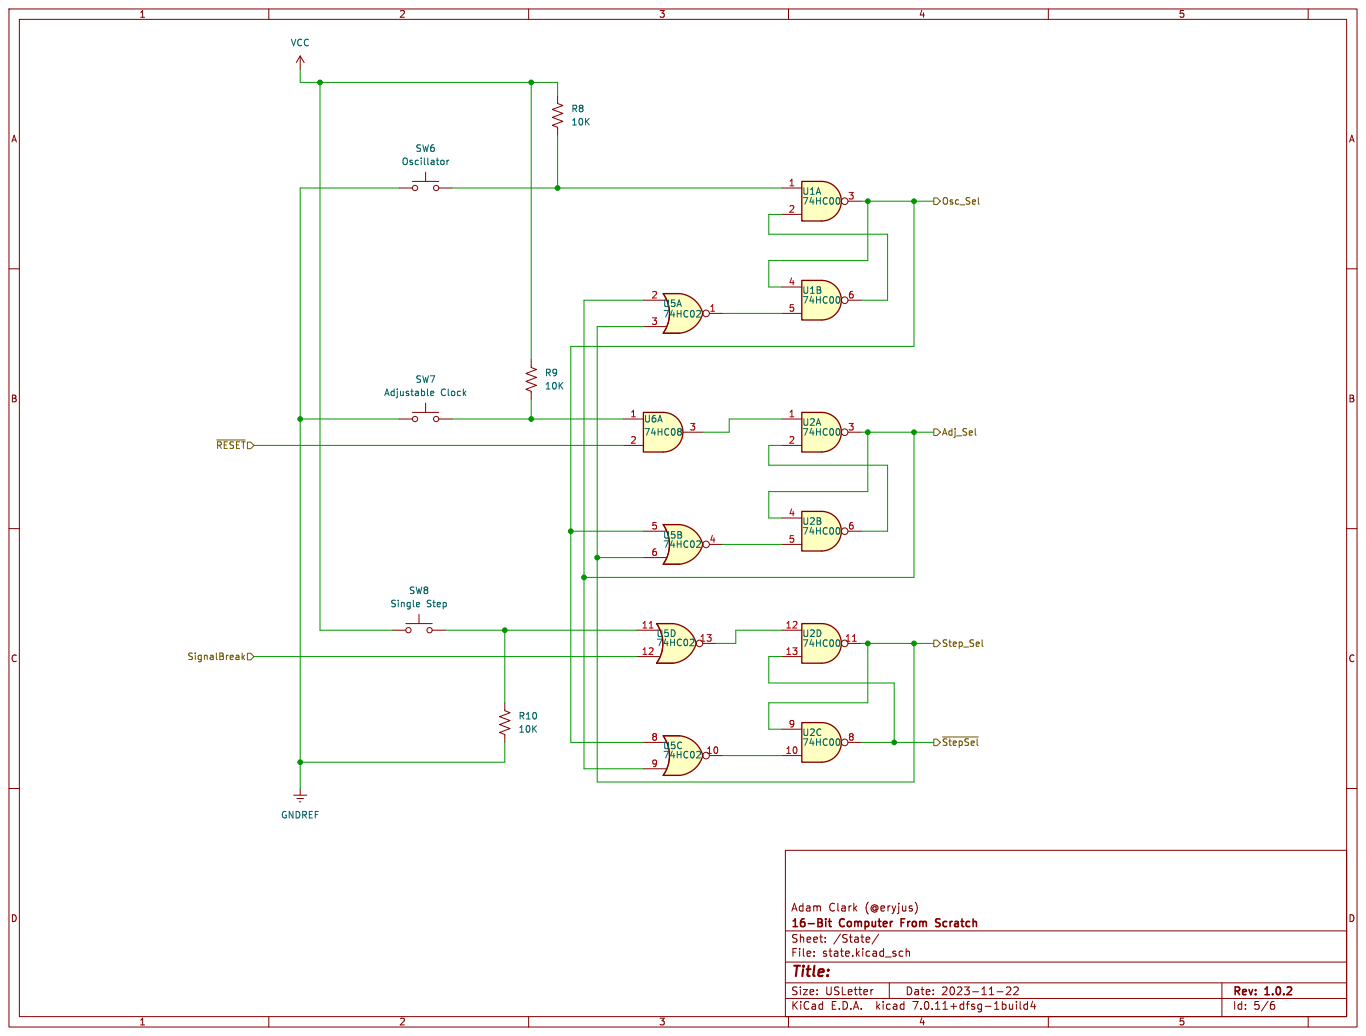
[picture p11: page 5]

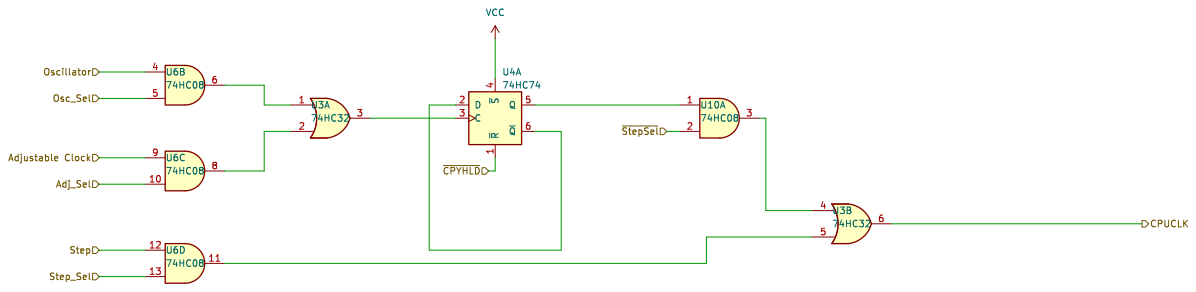
[picture p12: page 6]
