eryjus/16bcfs/kicad/projects/16bcfs/reset/reset.pdf

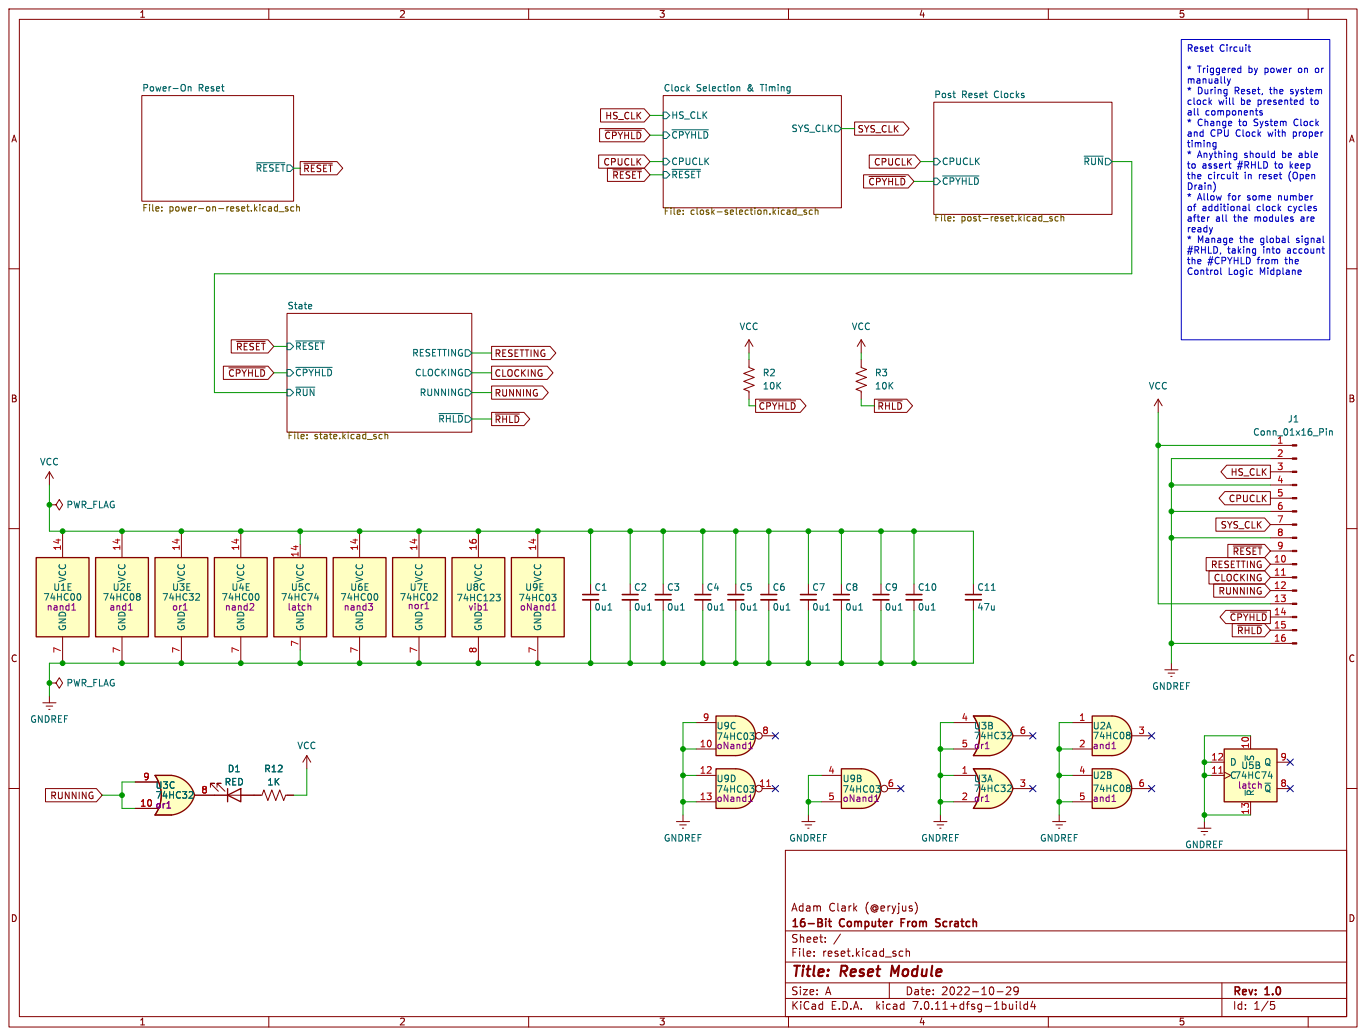
[picture p13: page 1]

Post Reset Clocks File: post-reset.kicad_sch

* During Reset, the system
all components
* Change to System Clock and CPU Clock with proper

timing
* Anything should be able
to assert #RHLD to keep

ready
* Manage the global signal #RHLD, taking into account

the #CPYHLD from the Control Logic Midplane U3C
or1 VCC
PWR_FLAG VCC 14 GND

Id: 1/5 Title: Reset Module

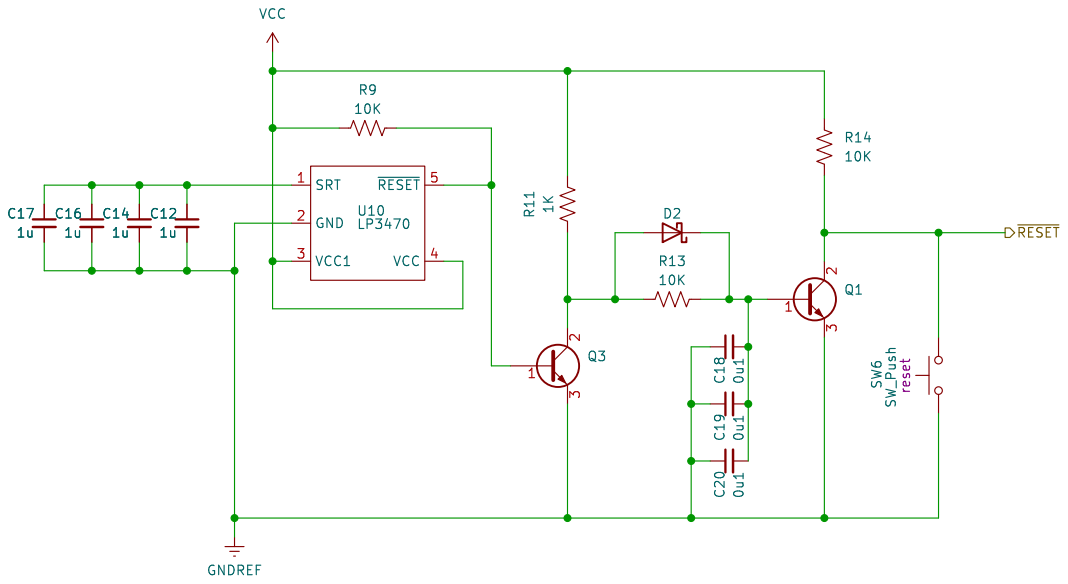
[picture p14: page 2]

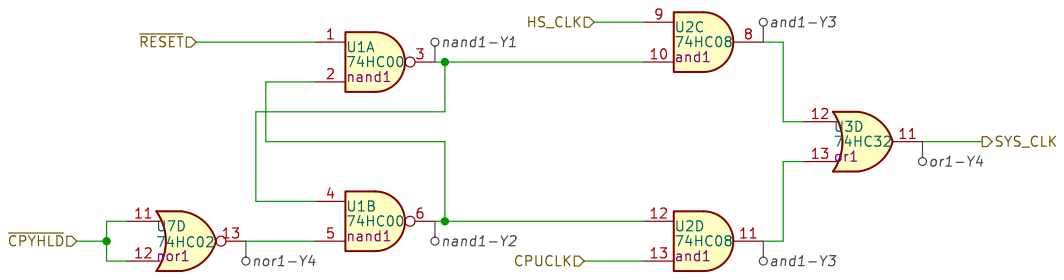
[picture p15: page 3]

Id: 4/5 Title: Reset Module - Clock Selection & Timing

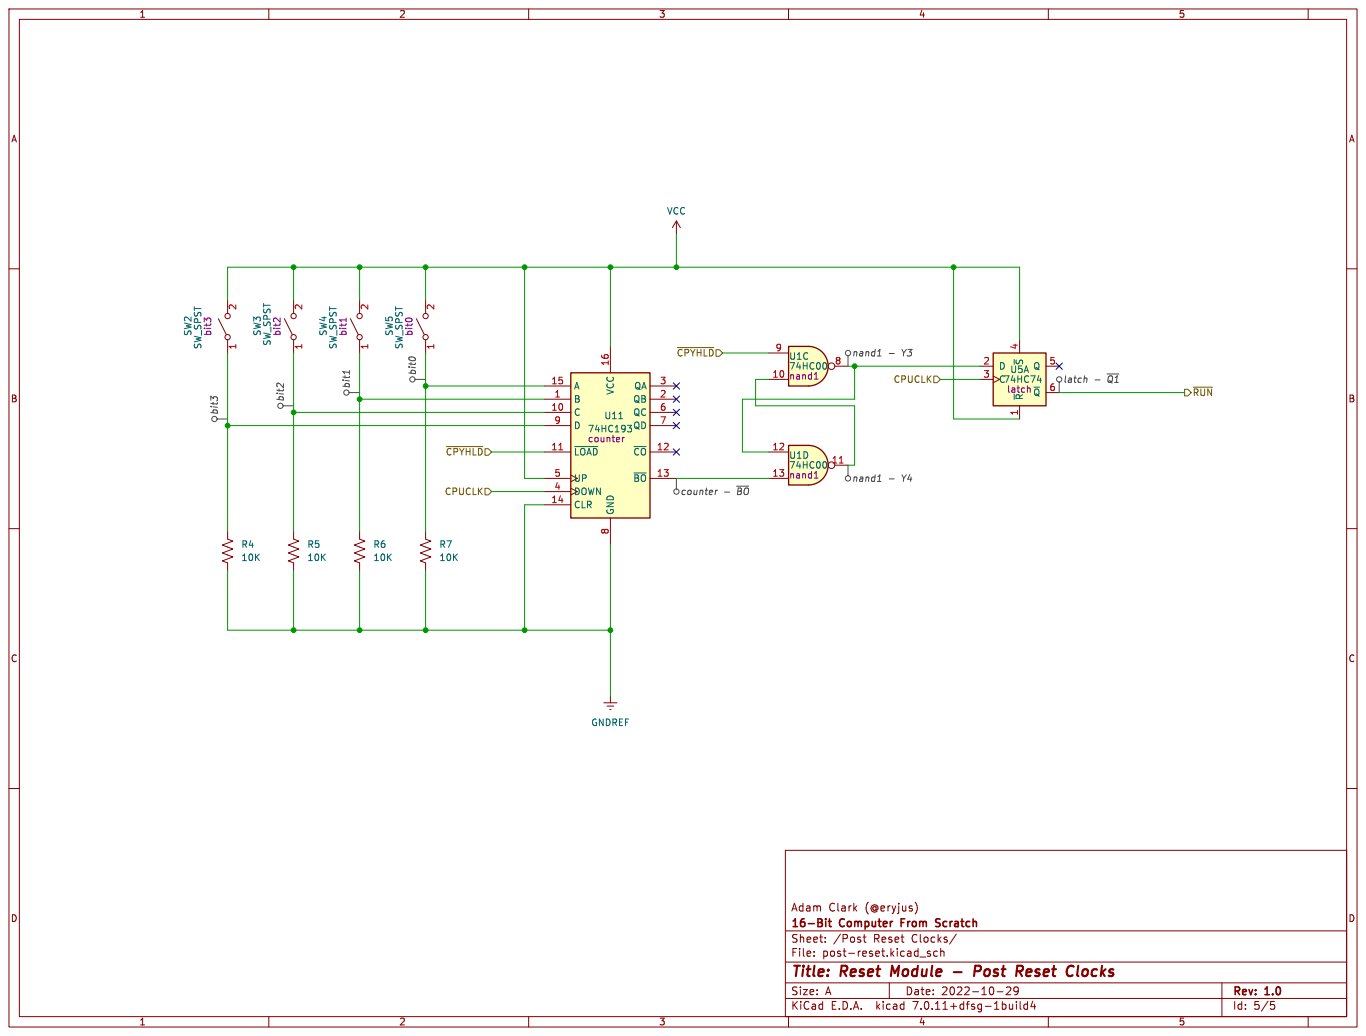
[picture p16: page 4]

Id: 5/5 Title: Reset Module - Post Reset Clocks

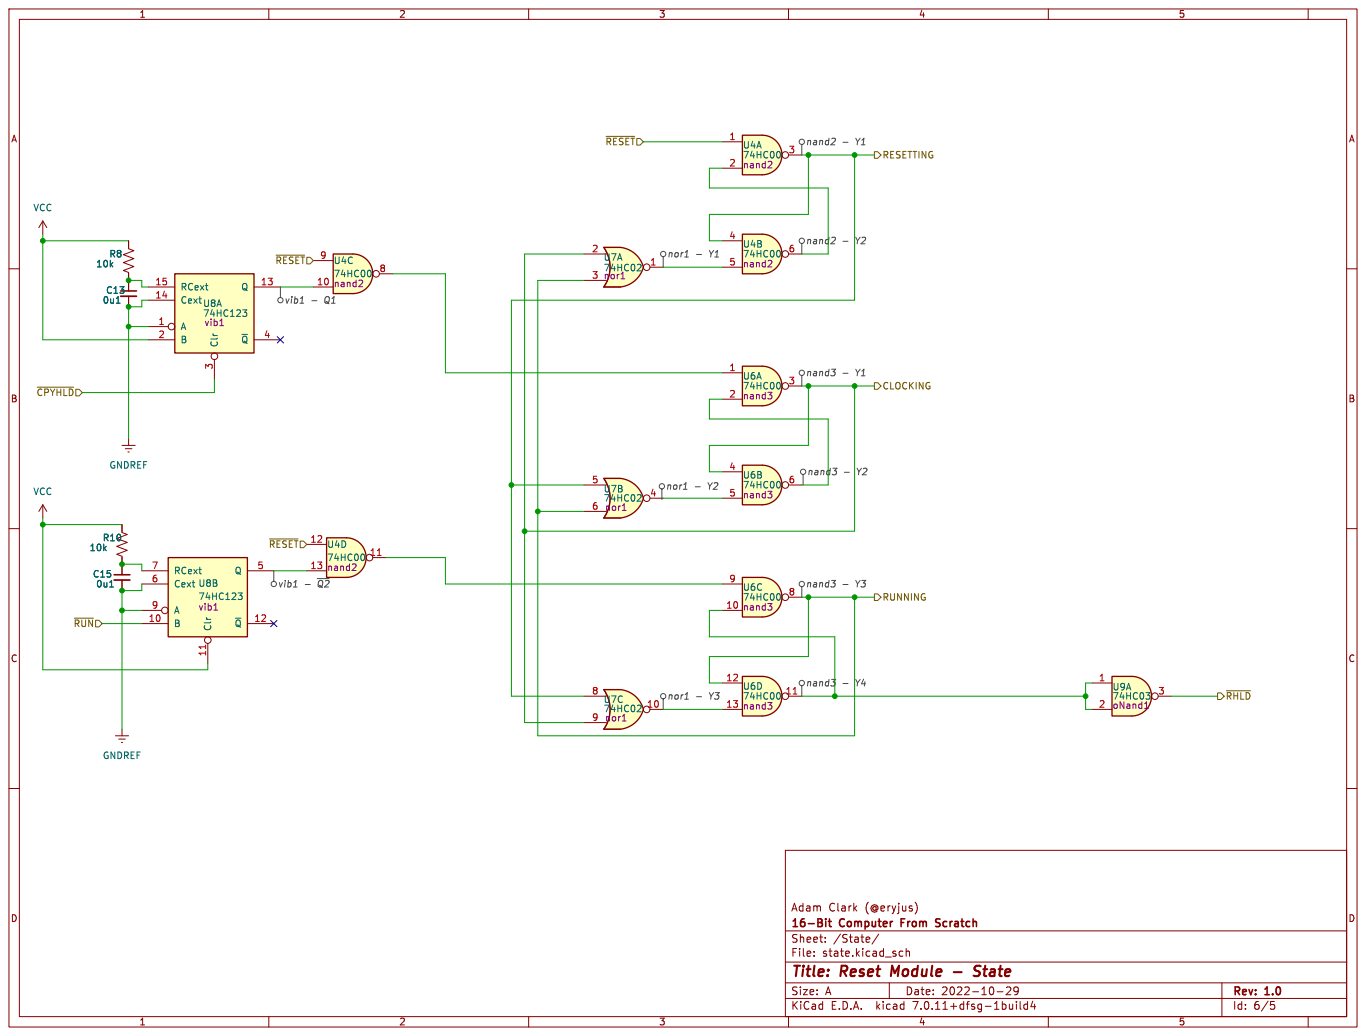
[picture p17: page 5]

Id: 6/5 Title: Reset Module - State
