eryjus/16bcfs/kicad/projects/16bcfs/clock-module/clock-module-schematic.pdf

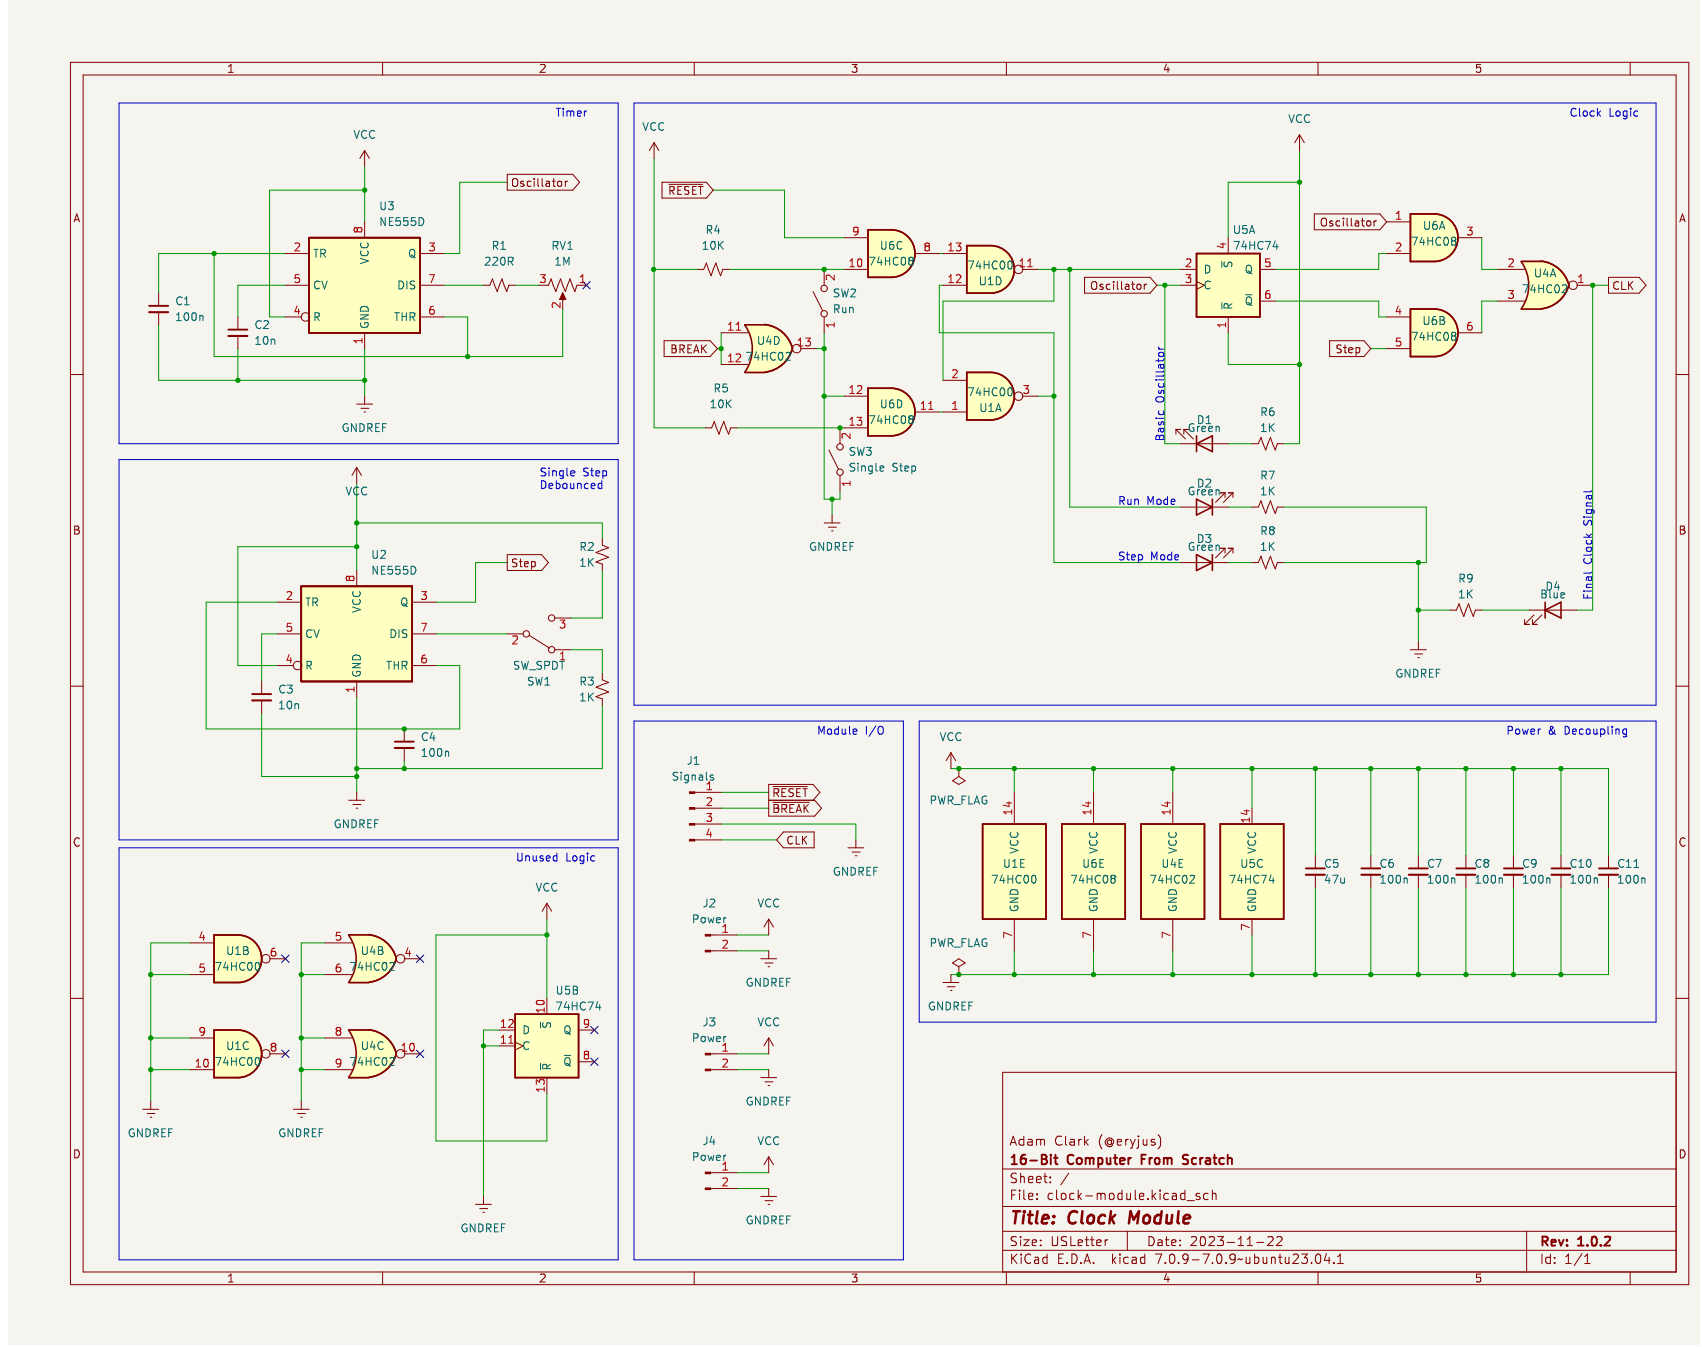
[picture p18: page 1]
