eryjus/16bcfs/kicad/projects/16bcfs/gp-register-module/gp-register-module-schematic.pdf

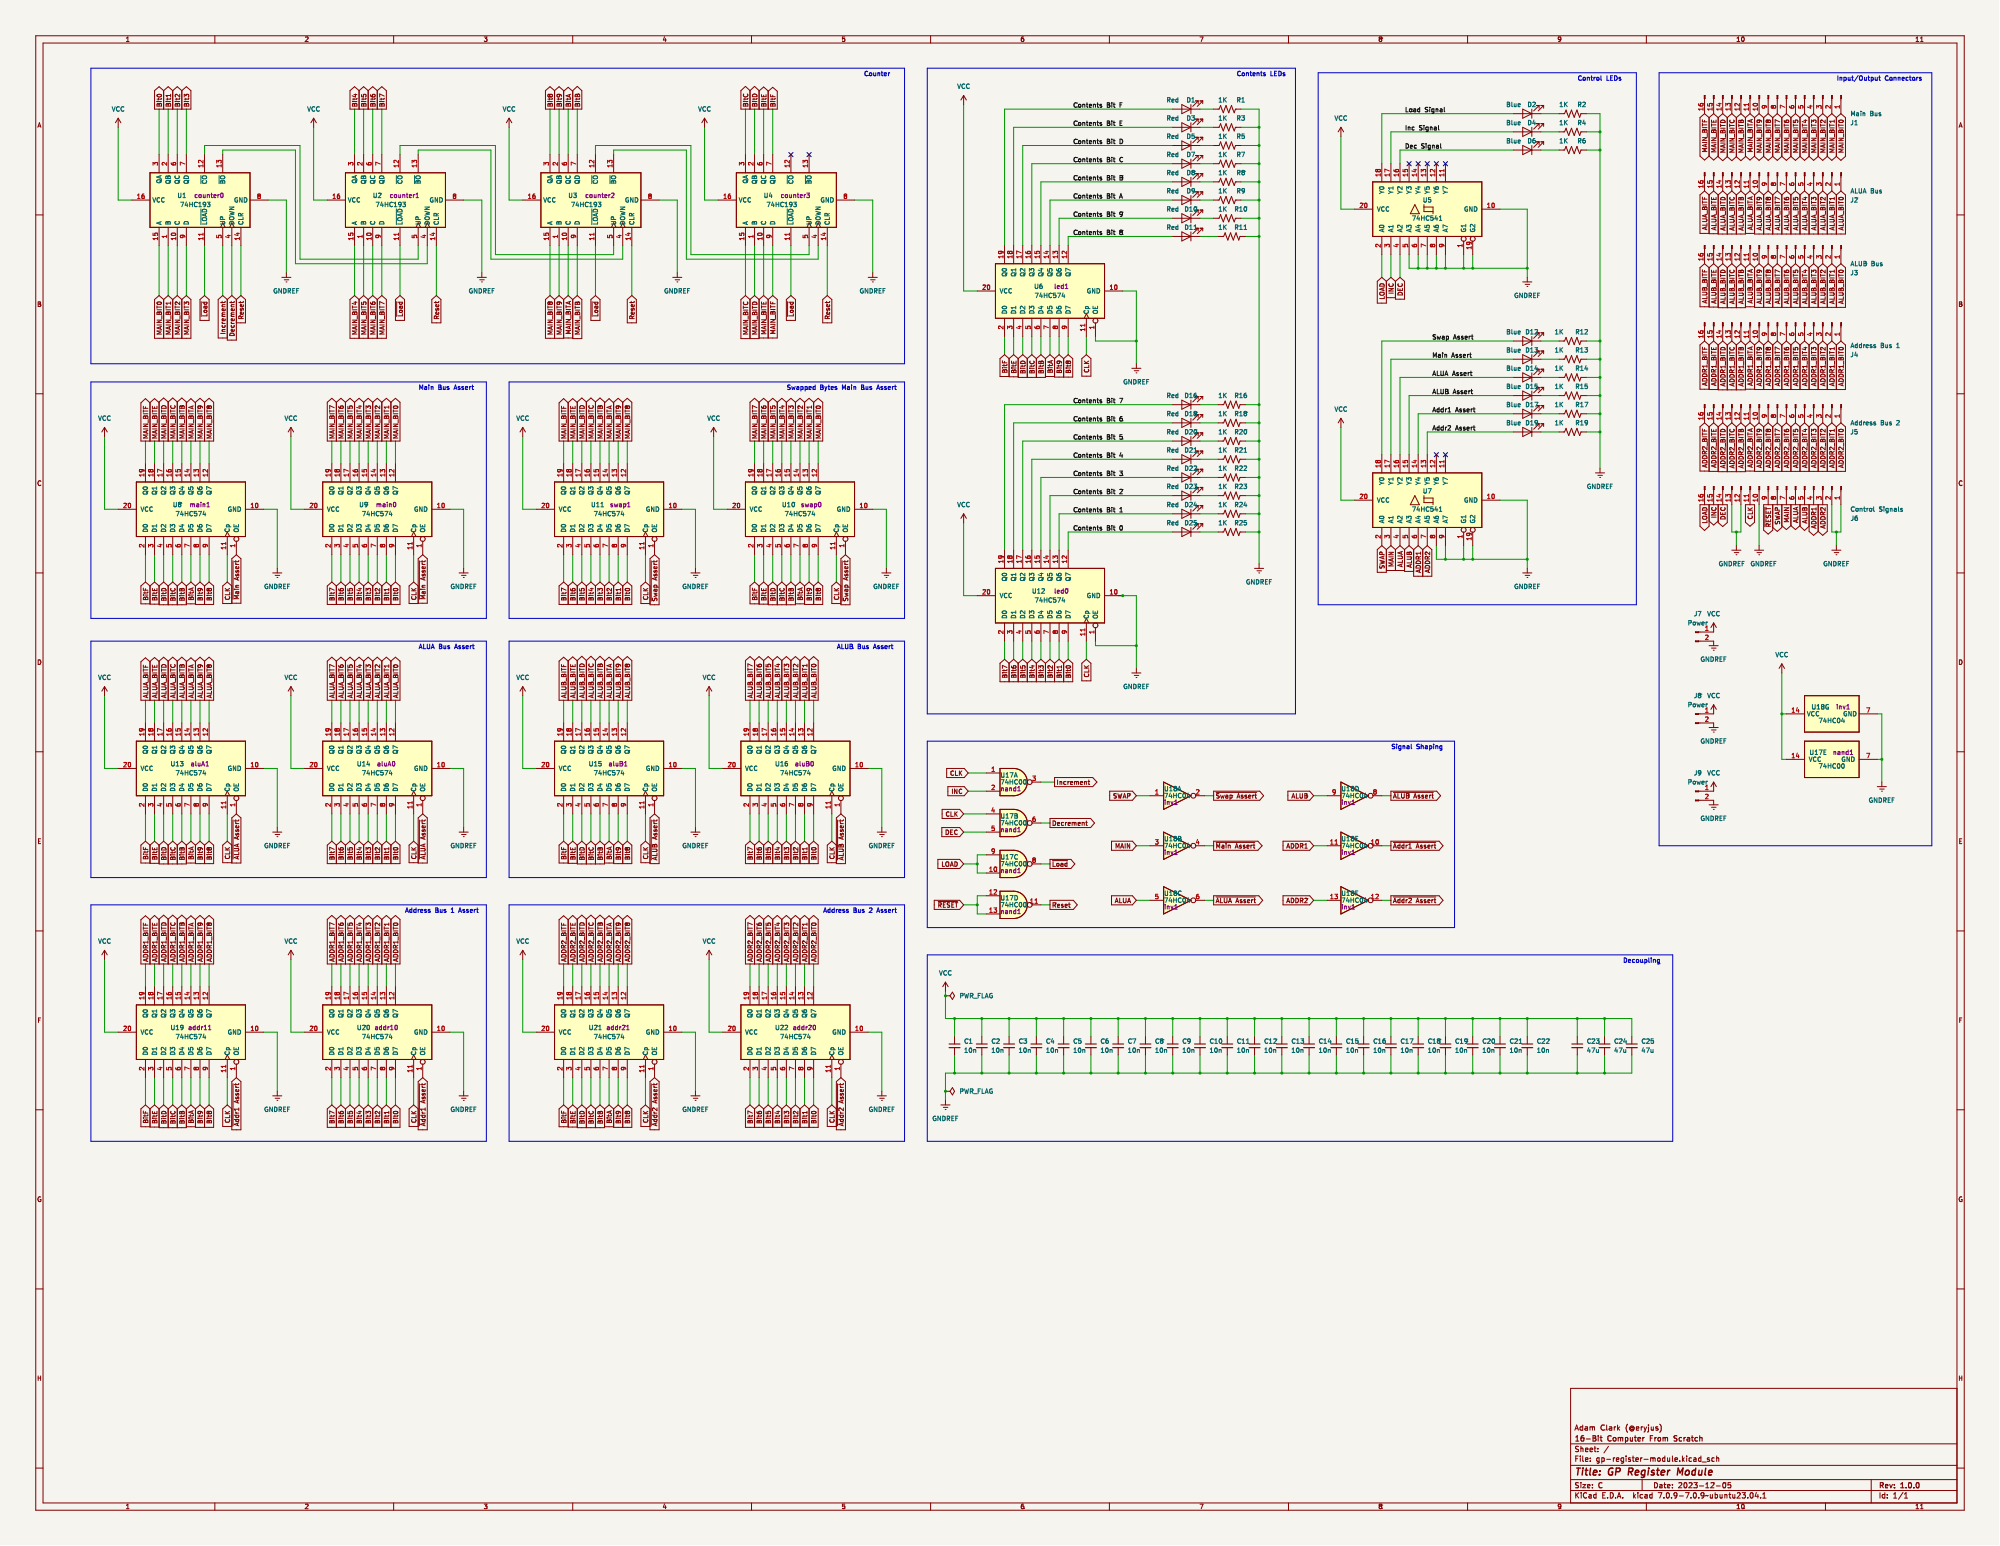
[picture p19: page 1]
