eryjus/16bcfs/kicad/projects/16bcfs/ctrl-rom-ctrl/ctrl-rom-ctrl.pdf

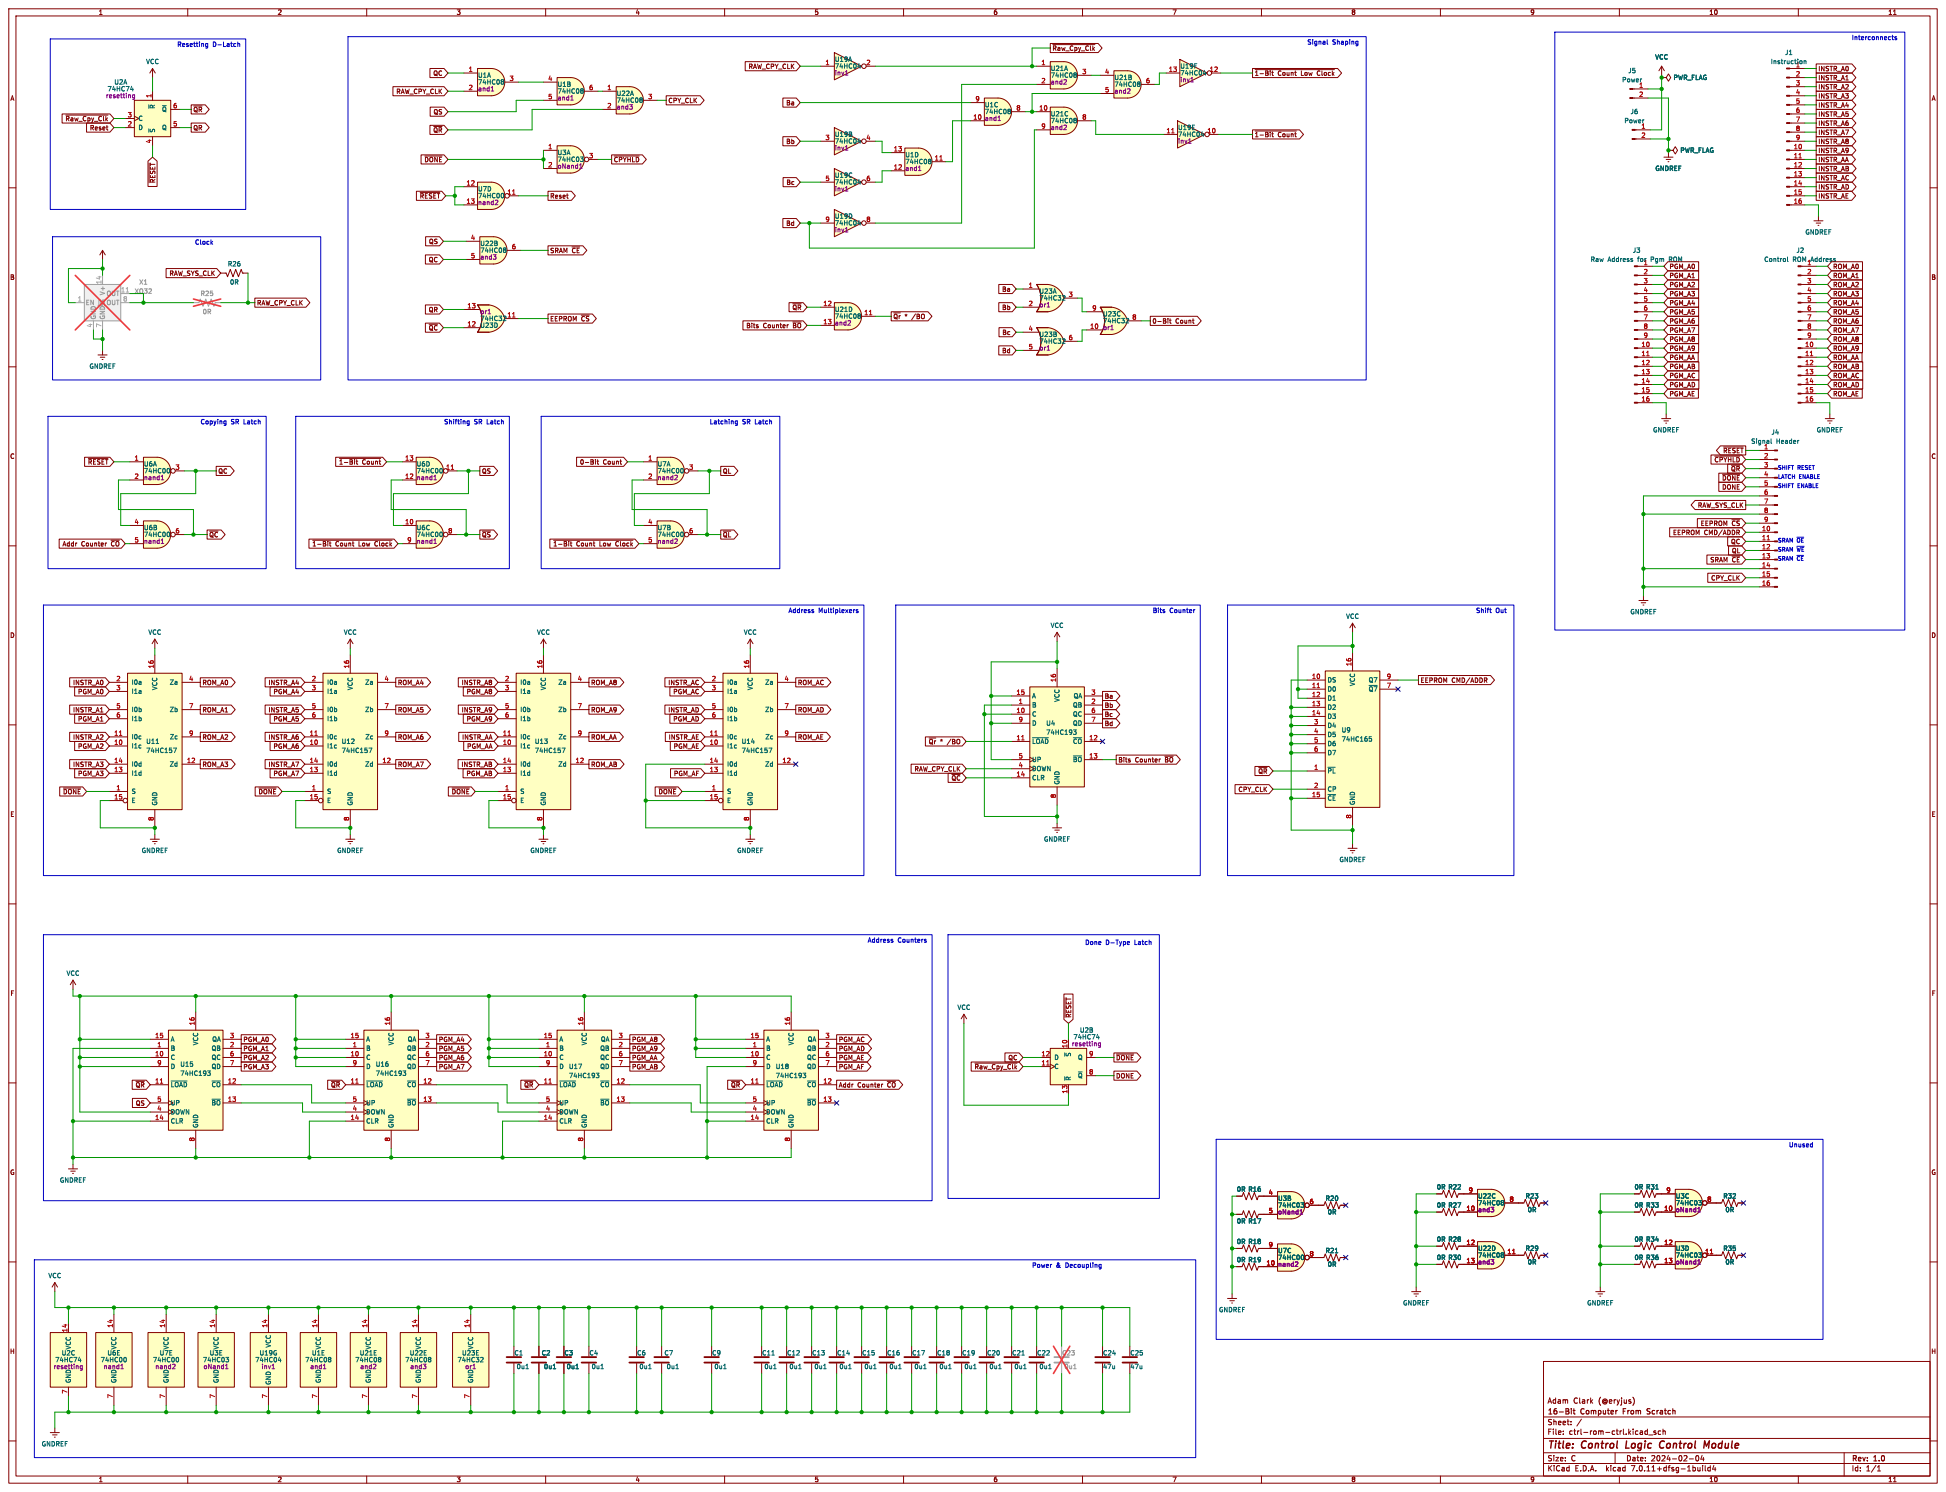
[picture p20: page 1]

Bits Counter ~{BO} QC

J3 Raw Address for Pgm ROM

Bits Counter ~{BO} BaBdBbBc

Id: 1/1 Title: Control Logic Control Module
