eryjus/16bcfs/kicad/projects/16bcfs/ctrl-rom-ctrl/ctrl-rom-ctrl-module.pdf

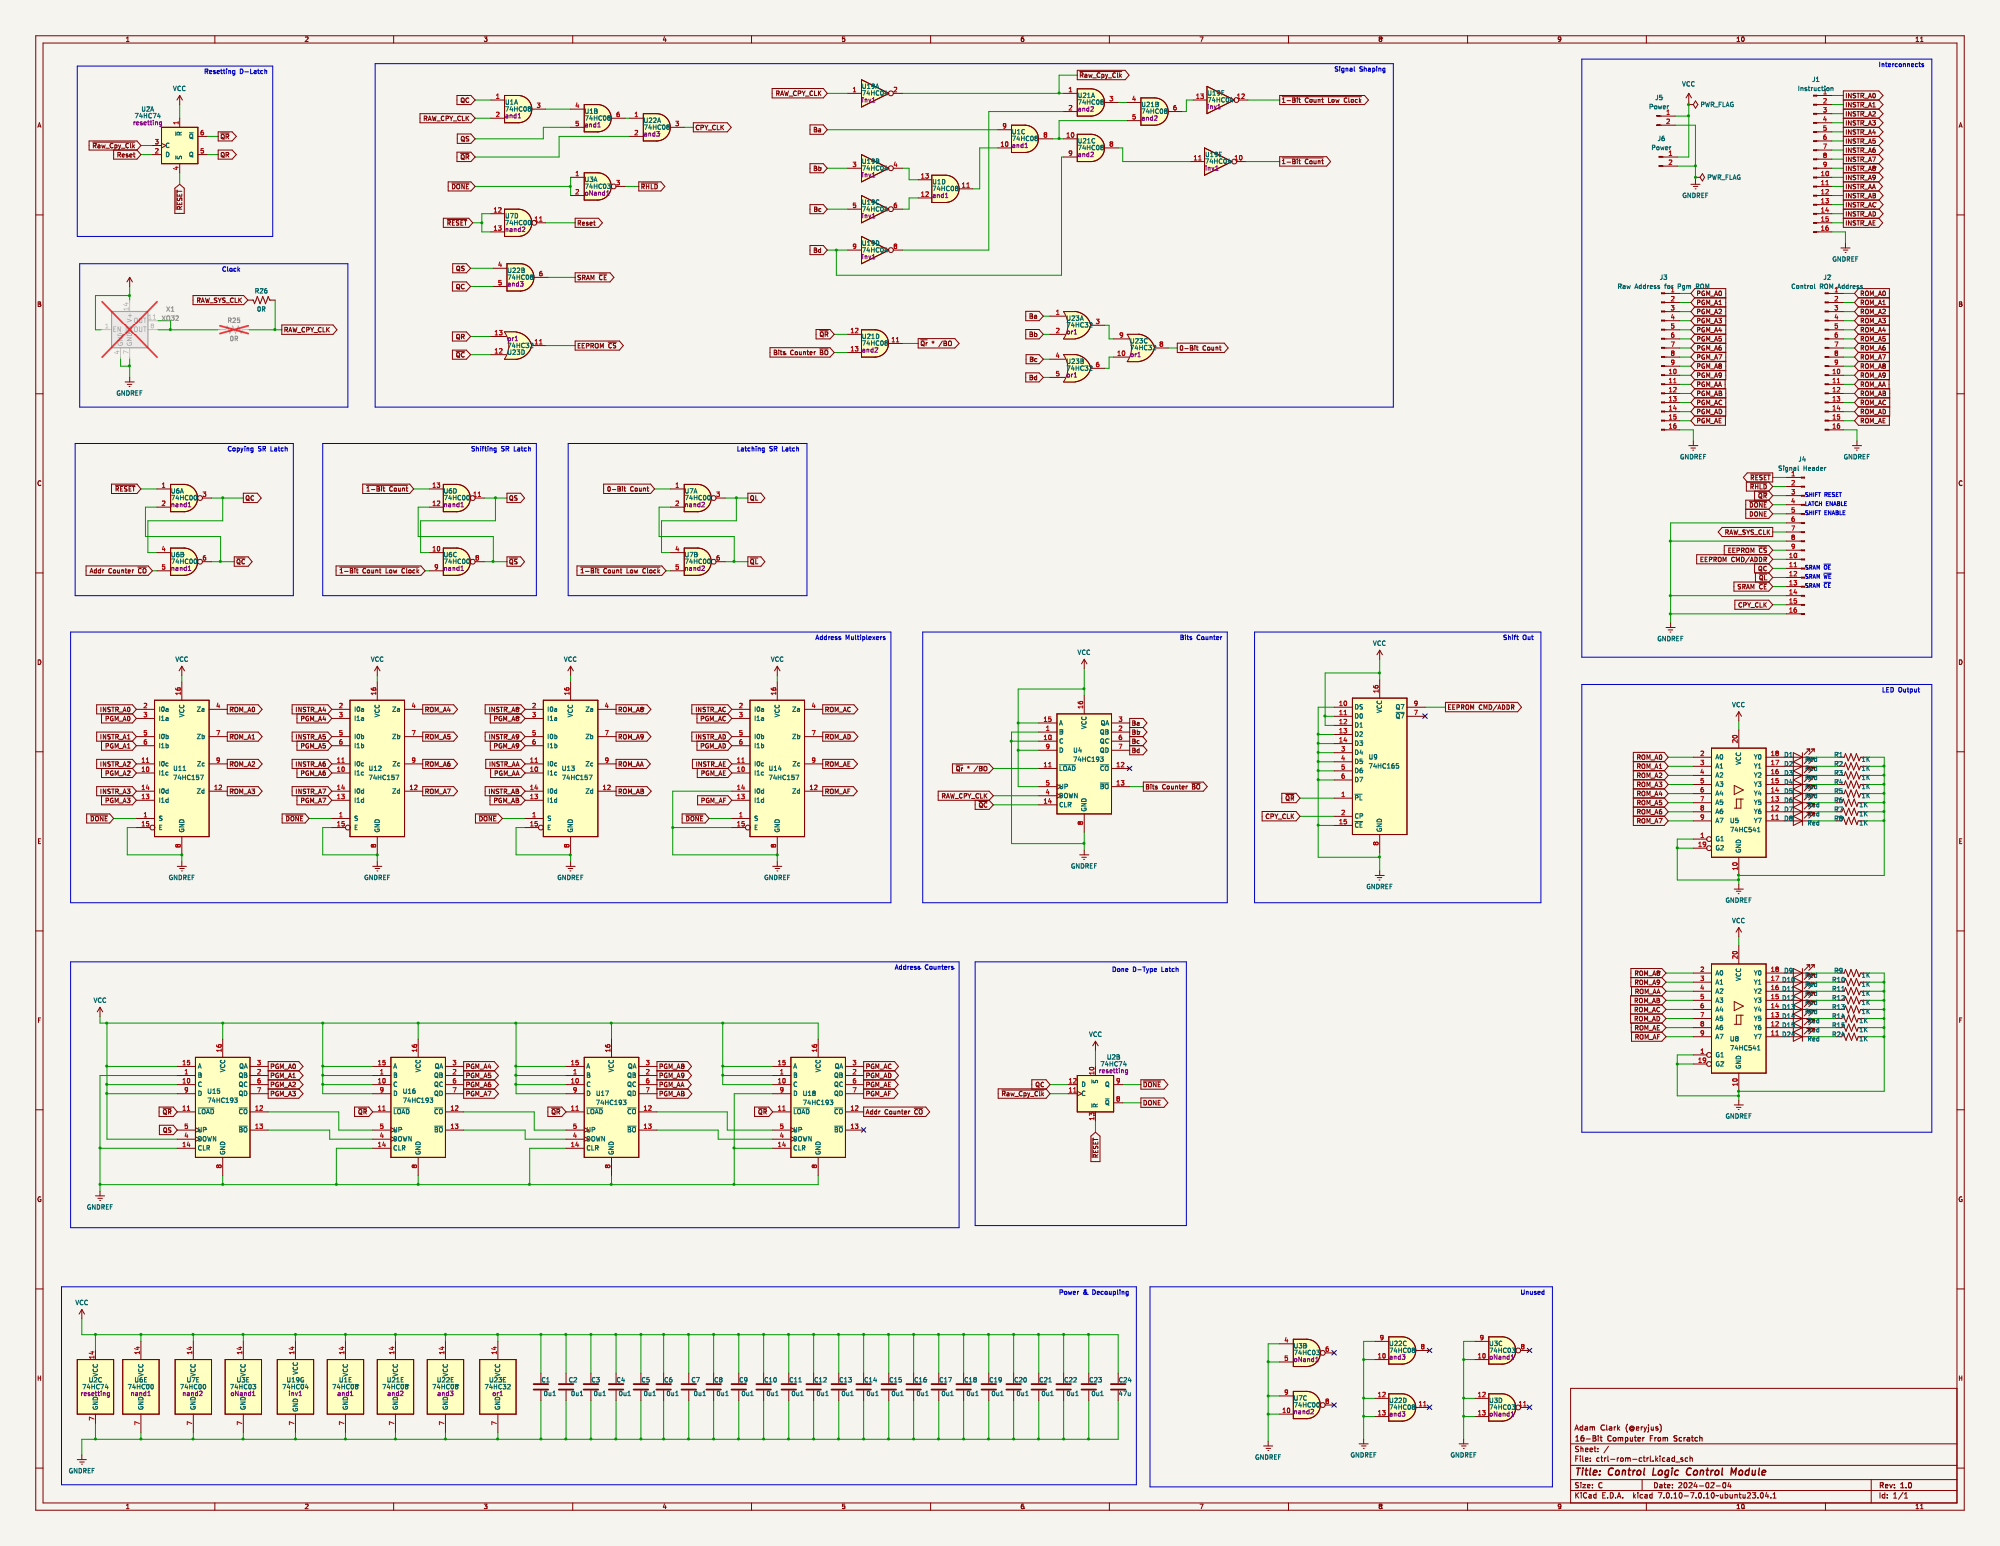
[picture p21: page 1]
