eryjus/16bcfs/kicad/projects/16bcfs/ctrl-rom-module/control-rom-module.pdf

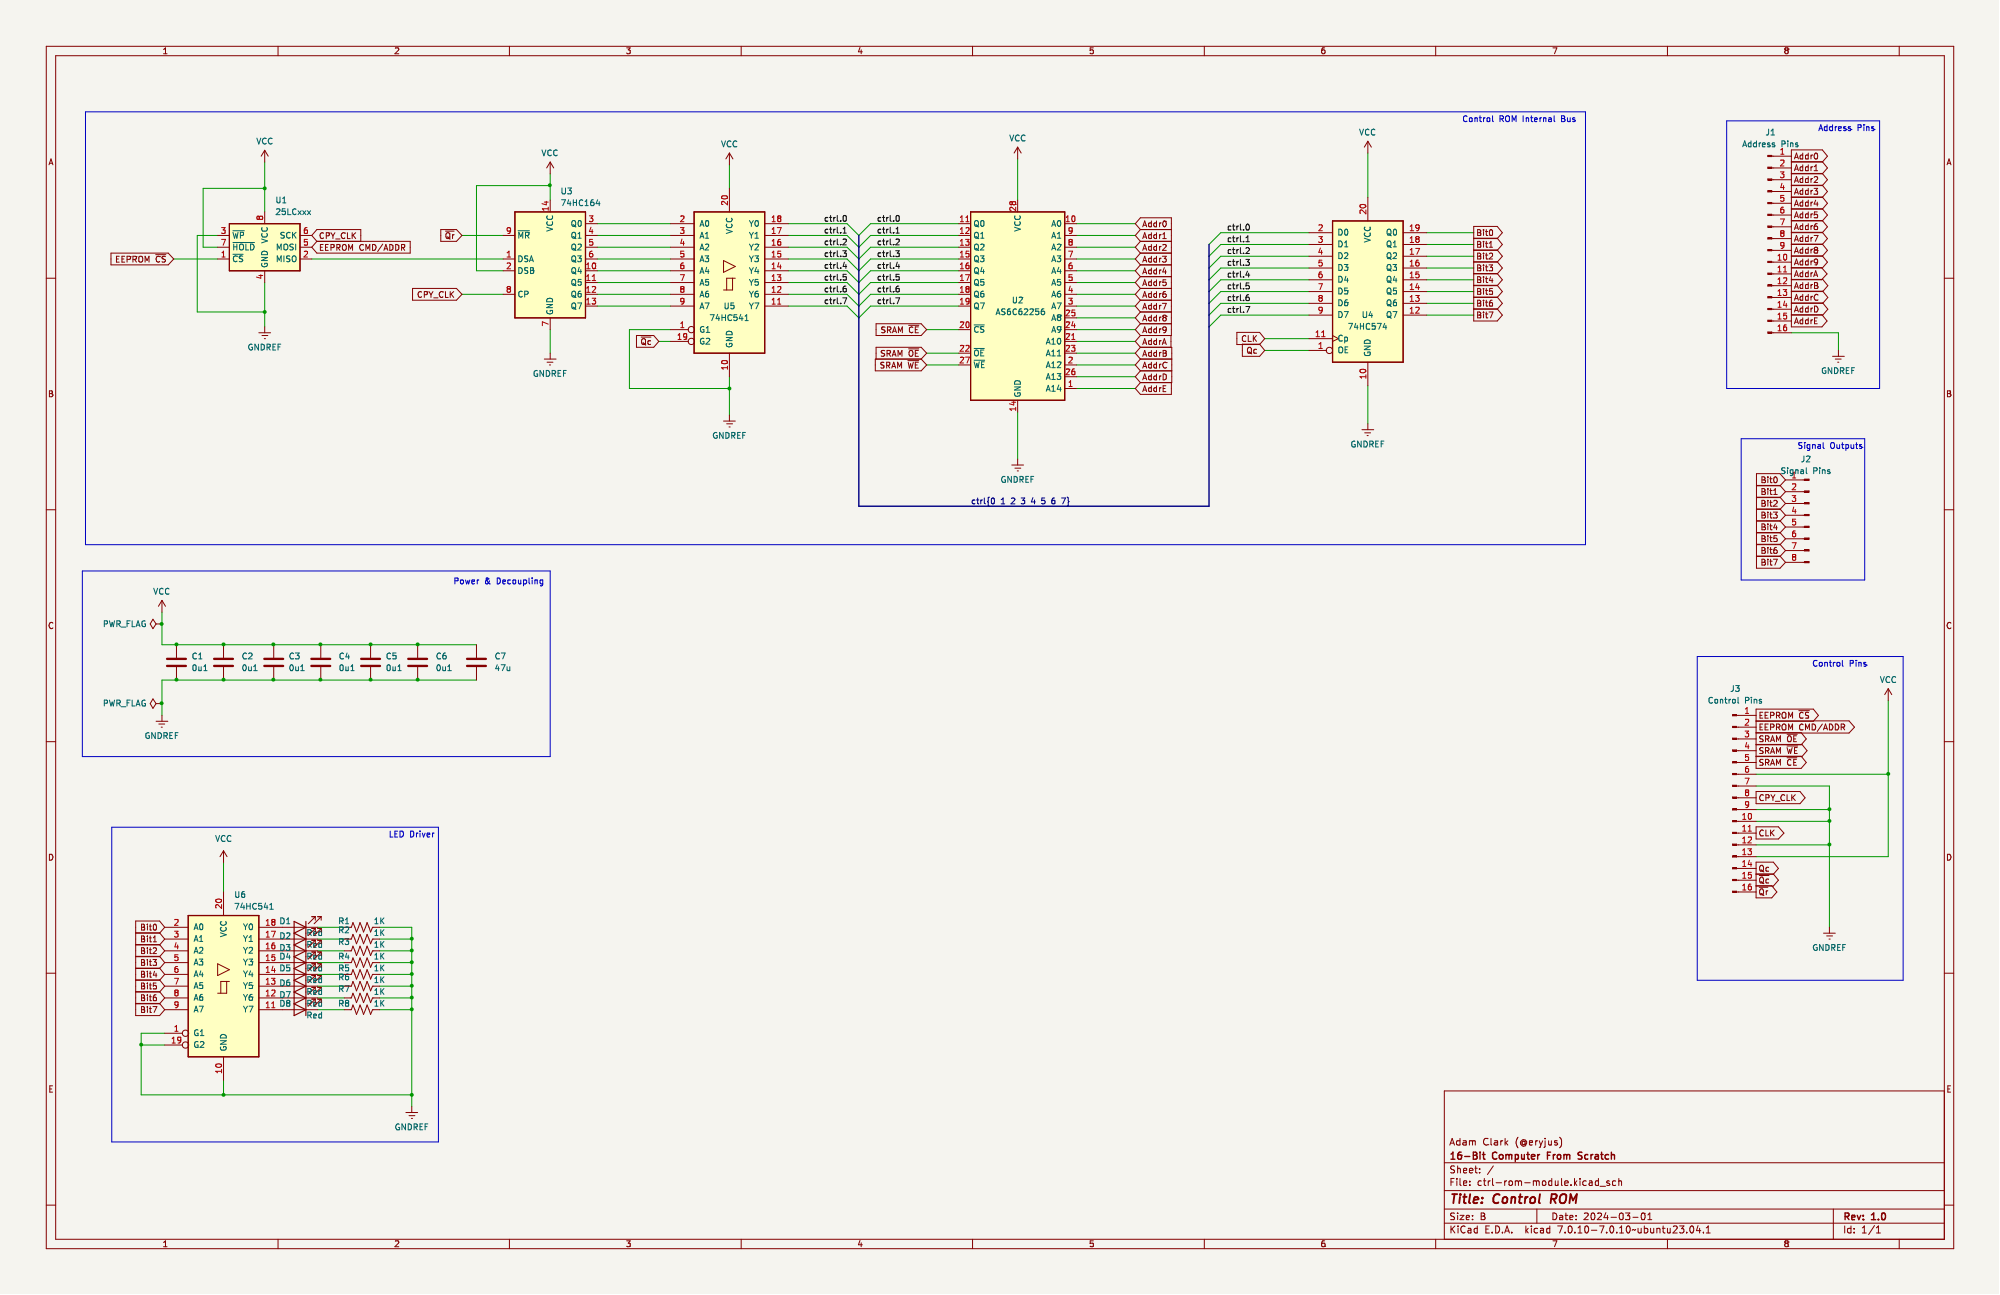
[picture p22: page 1]
