eryjus/16bcfs/kicad/projects/16bcfs/ctrl-rom-ctrl/ctrl-rom-ctrl.kicad_pcb

## KiCad design kicad/projects/16bcfs/ctrl-rom-ctrl/ctrl-rom-ctrl.kicad_pcb (2025-01-24)

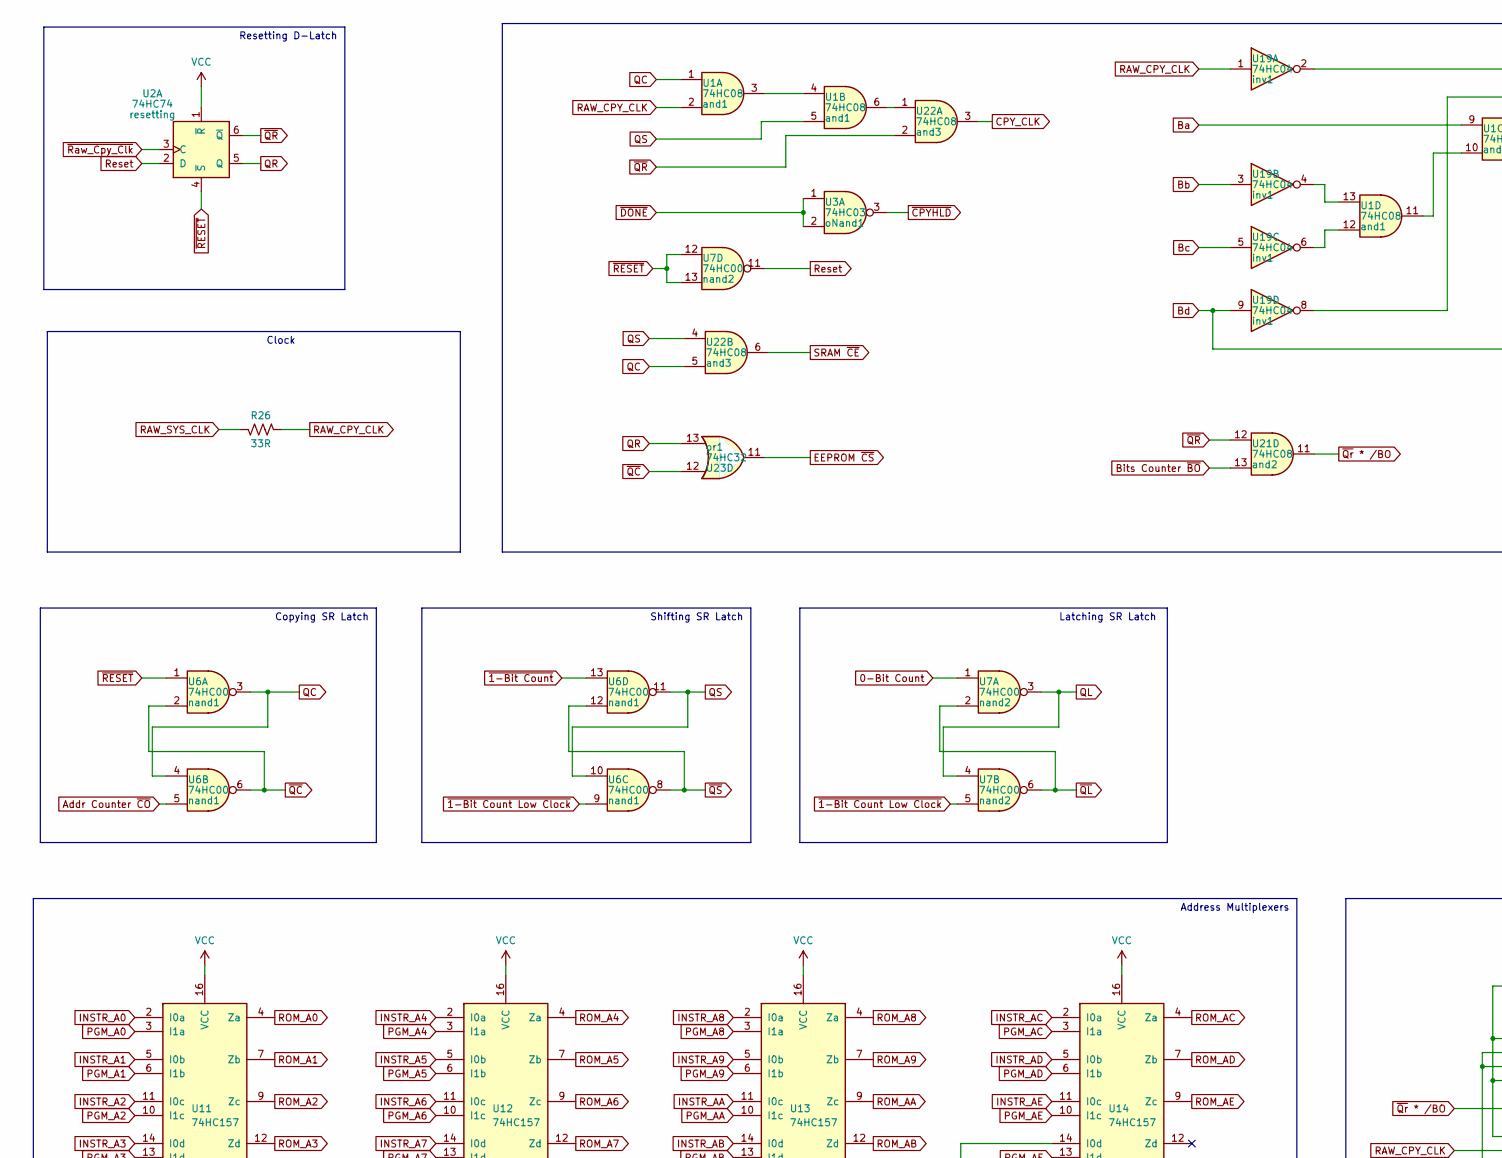
[picture p23: schematic ctrl-rom-ctrl.kicad_sch, Control Logic Control Module, part in row 1, column 1]

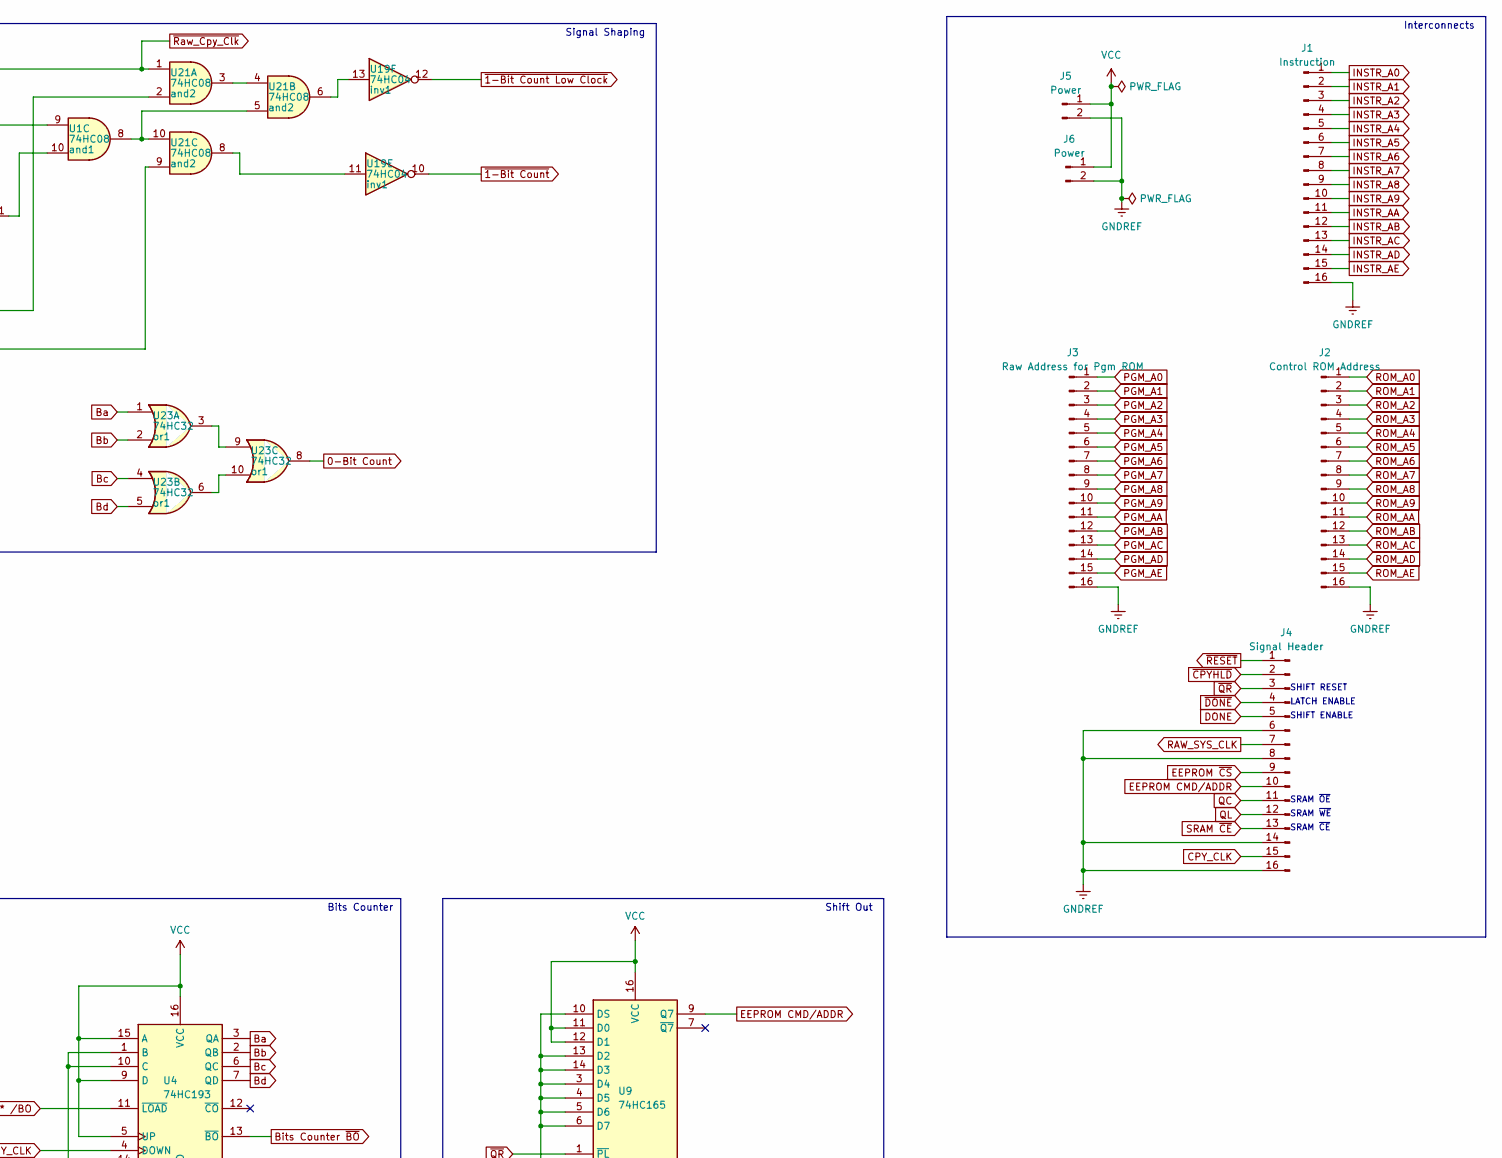
[picture p24: schematic ctrl-rom-ctrl.kicad_sch, Control Logic Control Module, part in row 1, column 2]

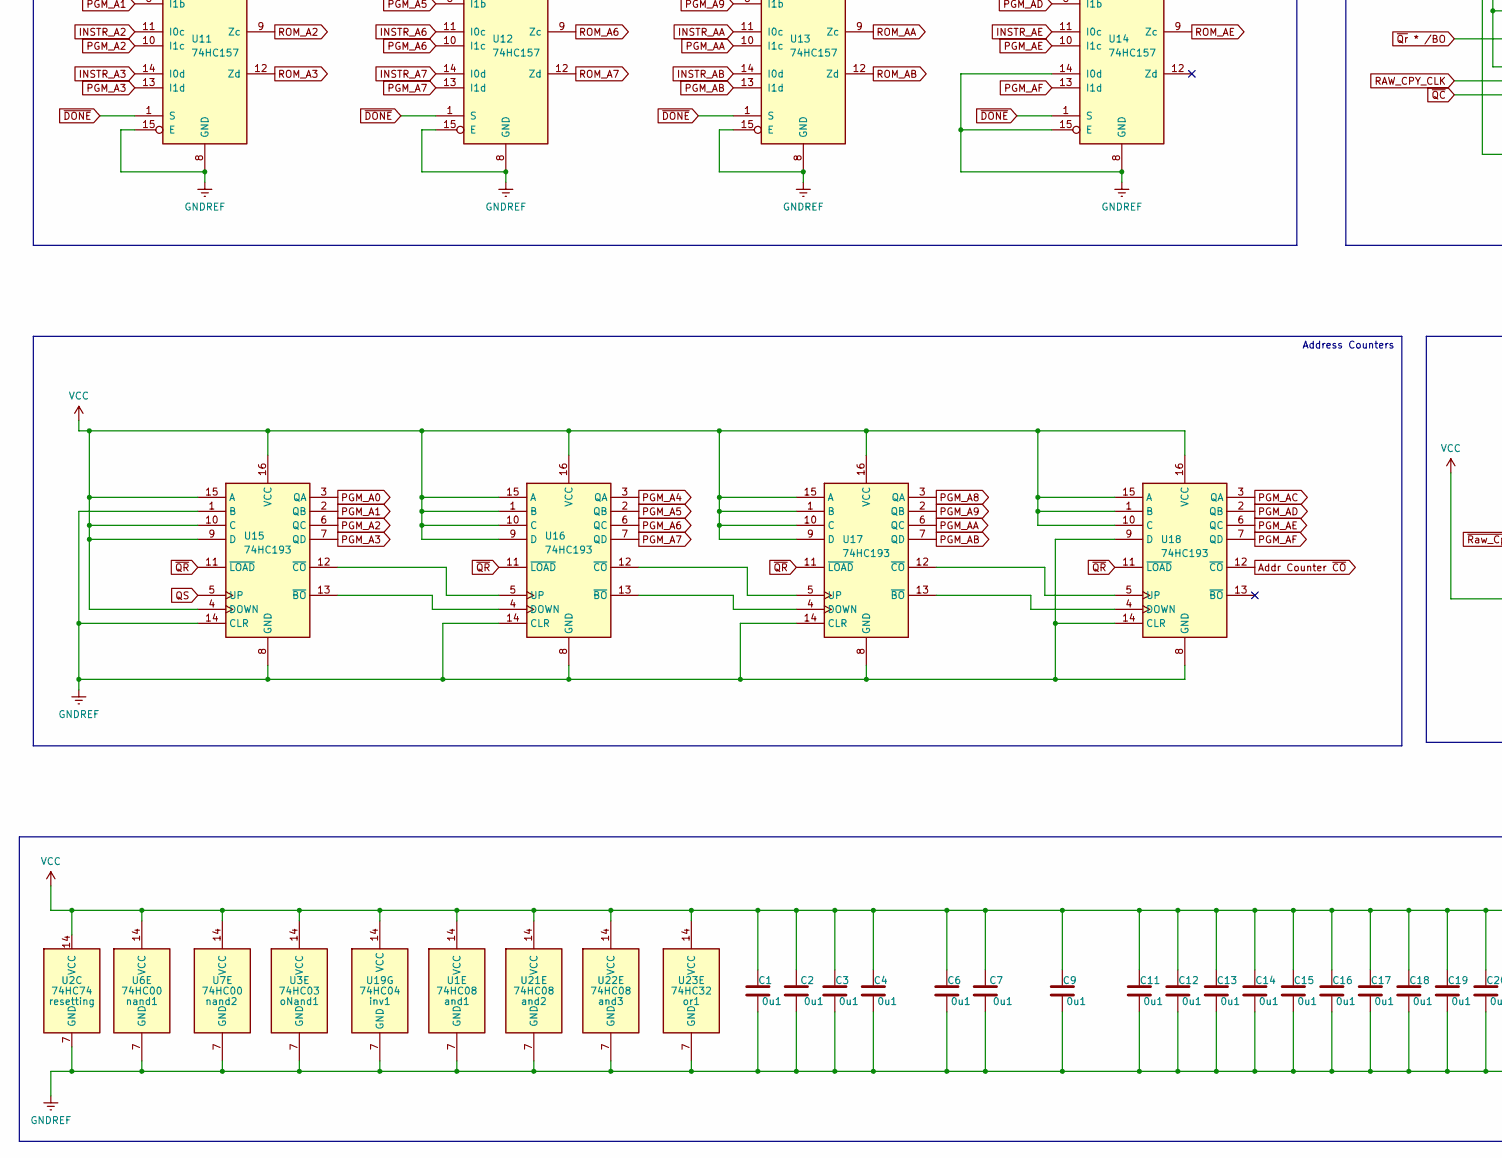
[picture p25: schematic ctrl-rom-ctrl.kicad_sch, Control Logic Control Module, part in row 2, column 1]

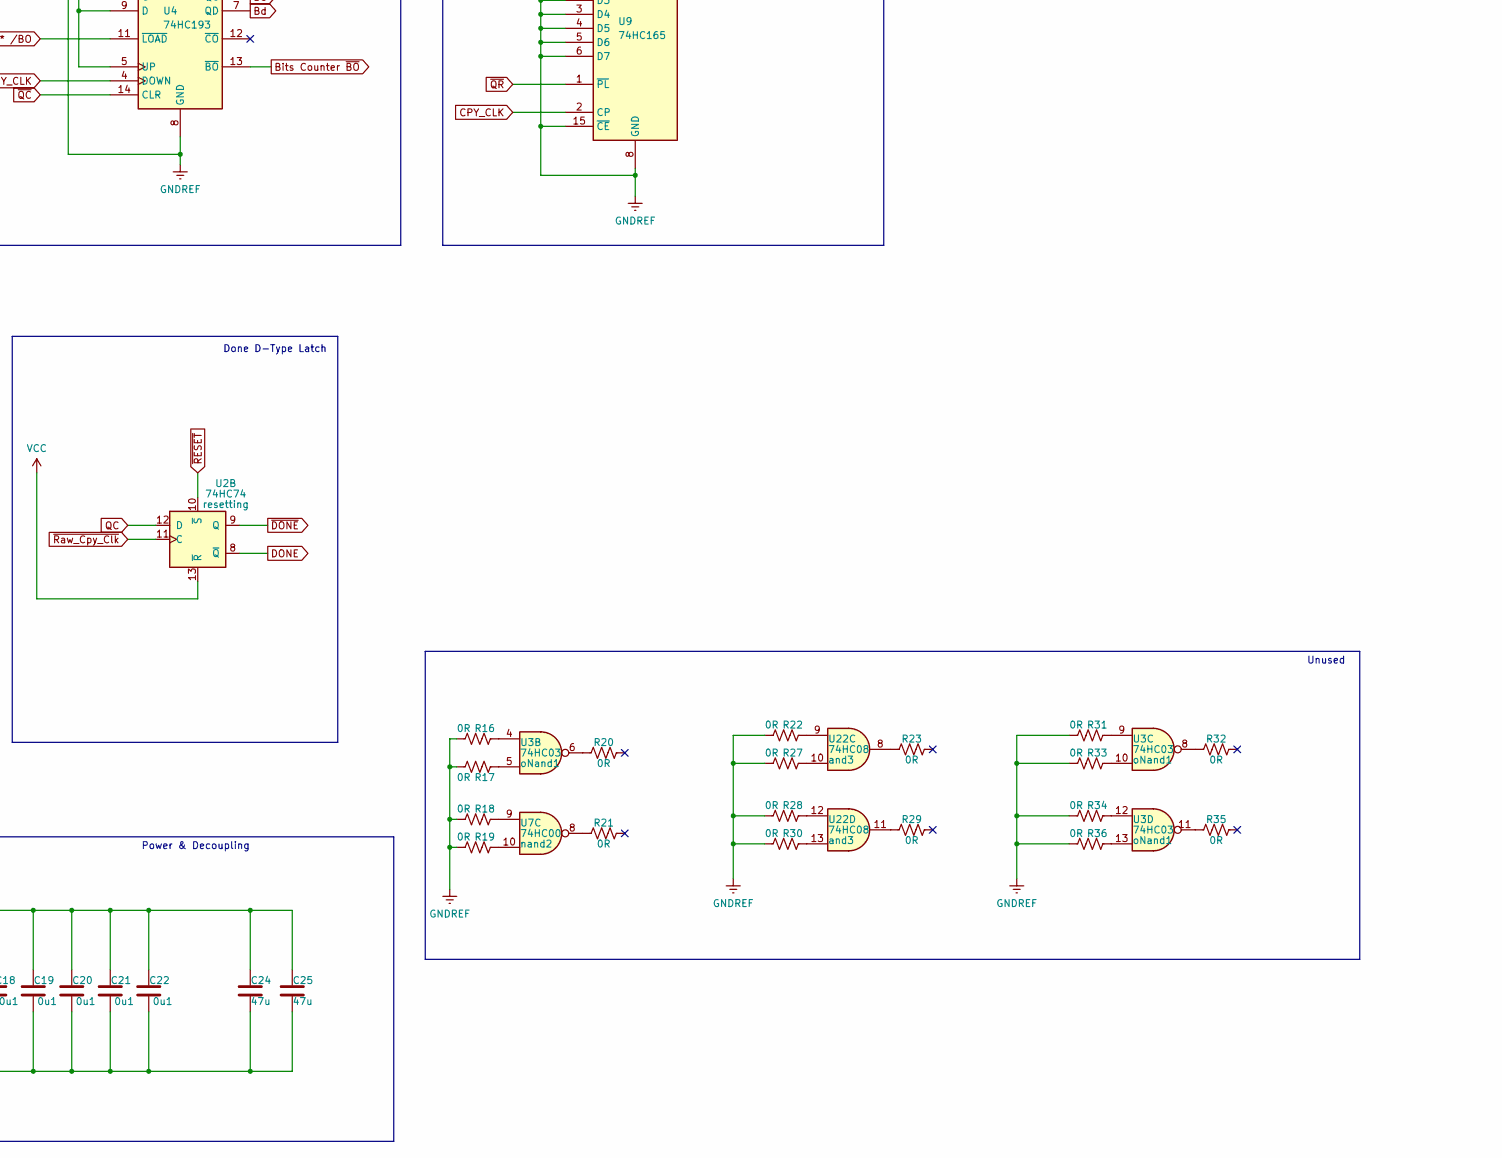
[picture p26: schematic ctrl-rom-ctrl.kicad_sch, Control Logic Control Module, part in row 2, column 2]

Parts:
C1, C2, C3, C4, C6, C7, C9, C11, C12, C13, C14, C15, C16, C17, C18, C19, C20, C21, C22: 0u1; C_1206_3216Metric_Pad1.33x1.80mm_HandSolder
C24, C25: 47u; C_1206_3216Metric_Pad1.33x1.80mm_HandSolder
J1: Instruction; PinHeader_1x16_P2.54mm_Vertical
J2: Control ROM Address; PinHeader_1x16_P2.54mm_Vertical
J3: Raw Address for Pgm ROM; PinHeader_1x16_P2.54mm_Vertical
J4: Signal Header; PinHeader_1x16_P2.54mm_Vertical
J5, J6: Power; PinHeader_1x02_P2.54mm_Vertical
R16, R17, R18, R19, R20, R21, R22, R23, R27, R28, R29, R30, R31, R32, R33, R34, R35, R36: 0R; R_1206_3216Metric_Pad1.30x1.75mm_HandSolder
R26: 33R; R_1206_3216Metric_Pad1.30x1.75mm_HandSolder
U1, U21, U22: 74HC08; SOIC-14_3.9x8.7mm_P1.27mm
U2: 74HC74; SOIC-14_3.9x8.7mm_P1.27mm
U3: 74HC03; SOIC-14_3.9x8.7mm_P1.27mm
U4, U15, U16, U17, U18: 74HC193; SOIC-16_3.9x9.9mm_P1.27mm
U6, U7: 74HC00; SOIC-14_3.9x8.7mm_P1.27mm
U9: 74HC165; SOIC-16_3.9x9.9mm_P1.27mm
U11, U12, U13, U14: 74HC157; SOIC-16_3.9x9.9mm_P1.27mm
U19: 74HC04; SOIC-14_3.9x8.7mm_P1.27mm
U23: 74HC32; SOIC-14_3.9x8.7mm_P1.27mm

Connections:
0-Bit Count: U7.1, U23.8
Addr Counter ~CO: U6.5, U18.12 (~CO)
Ba: U1.9, U4.3 (QA), U23.1
Bb: U4.2 (QB), U19.3, U23.2
Bc: U4.6 (QC), U19.5, U23.4
Bd: U4.7 (QD), U19.9, U21.9, U23.5
Bits Counter ~BO: U4.13 (~BO), U21.13
CPY_CLK: J4.15, U9.2 (CP), U22.3
DONE: J4.5, U2.8 (~Q)
EEPROM CMD/ADDR: J4.10, U9.9 (Q7)
EEPROM ~CS: J4.9, U23.11
GNDREF: C1.2, C2.2, C3.2, C4.2, C6.2, C7.2, C9.2, C11.2, C12.2, C13.2, C14.2, C15.2, C16.2, C17.2, C18.2, C19.2, C20.2, C21.2, C22.2, C24.2, C25.2, J1.16, J2.16, J3.16, J4.6, J4.8, J4.14, J4.16, J5.2, J6.2, R16.1, R17.1, R18.1, R19.1, R22.1, R27.1, R28.1, R30.1, R31.1, R33.1, R34.1, R36.1, U1.7 (GND), U2.7 (GND), U3.7 (GND), U4.1 (B), U4.8 (GND), U4.10 (C), U6.7 (GND), U7.7 (GND), U9.3 (D4), U9.4 (D5), U9.5 (D6), U9.6 (D7), U9.8 (GND), U9.10 (DS), U9.13 (D2), U9.14 (D3), U9.15 (~CE), U11.8 (GND), U11.15 (E), U12.8 (GND), U12.15 (E), U13.8 (GND), U13.15 (E), U14.8 (GND), U14.14 (I0d), U14.15 (E), U15.1 (B), U15.8 (GND), U15.14 (CLR), U16.8 (GND), U16.14 (CLR), U17.8 (GND), U17.14 (CLR), U18.8 (GND), U18.9 (D), U18.14 (CLR), U19.7 (GND), U21.7 (GND), U22.7 (GND), U23.7 (GND)
INSTR_A0: J1.1, U11.2 (I0a)
INSTR_A1: J1.2, U11.5 (I0b)
INSTR_A2: J1.3, U11.11 (I0c)
INSTR_A3: J1.4, U11.14 (I0d)
INSTR_A4: J1.5, U12.2 (I0a)
INSTR_A5: J1.6, U12.5 (I0b)
INSTR_A6: J1.7, U12.11 (I0c)
INSTR_A7: J1.8, U12.14 (I0d)
INSTR_A8: J1.9, U13.2 (I0a)
INSTR_A9: J1.10, U13.5 (I0b)
INSTR_AA: J1.11, U13.11 (I0c)
INSTR_AB: J1.12, U13.14 (I0d)
INSTR_AC: J1.13, U14.2 (I0a)
INSTR_AD: J1.14, U14.5 (I0b)
INSTR_AE: J1.15, U14.11 (I0c)
unnamed: R16.2, U3.4
unnamed: R17.2, U3.5
unnamed: R18.2, U7.9
unnamed: R19.2, U7.10
unnamed: R20.1, U3.6
unnamed: R21.1, U7.8
unnamed: R22.2, U22.9
unnamed: R23.1, U22.8
unnamed: R27.2, U22.10
unnamed: R28.2, U22.12
unnamed: R29.1, U22.11
unnamed: R30.2, U22.13
unnamed: R31.2, U3.9
unnamed: R32.1, U3.8
unnamed: R33.2, U3.10
unnamed: R34.2, U3.12
unnamed: R35.1, U3.11
unnamed: R36.2, U3.13
unnamed: U1.3, U1.4
unnamed: U1.6, U22.1
unnamed: U1.8, U21.5, U21.10
unnamed: U1.10, U1.11
unnamed: U1.12, U19.6
unnamed: U1.13, U19.4
unnamed: U15.13 (~BO), U16.4 (DOWN)
unnamed: U15.12 (~CO), U16.5 (UP)
unnamed: U16.13 (~BO), U17.4 (DOWN)
unnamed: U16.12 (~CO), U17.5 (UP)
unnamed: U17.13 (~BO), U18.4 (DOWN)
unnamed: U17.12 (~CO), U18.5 (UP)
unnamed: U19.8, U21.2
unnamed: U19.11, U21.8
unnamed: U19.13, U21.6
unnamed: U21.3, U21.4
unnamed: U23.3, U23.9
unnamed: U23.6, U23.10
PGM_A0: J3.1, U11.3 (I1a), U15.3 (QA)
PGM_A1: J3.2, U11.6 (I1b), U15.2 (QB)
PGM_A2: J3.3, U11.10 (I1c), U15.6 (QC)
PGM_A3: J3.4, U11.13 (I1d), U15.7 (QD)
PGM_A4: J3.5, U12.3 (I1a), U16.3 (QA)
PGM_A5: J3.6, U12.6 (I1b), U16.2 (QB)
PGM_A6: J3.7, U12.10 (I1c), U16.6 (QC)
PGM_A7: J3.8, U12.13 (I1d), U16.7 (QD)
PGM_A8: J3.9, U13.3 (I1a), U17.3 (QA)
PGM_A9: J3.10, U13.6 (I1b), U17.2 (QB)
PGM_AA: J3.11, U13.10 (I1c), U17.6 (QC)
PGM_AB: J3.12, U13.13 (I1d), U17.7 (QD)
PGM_AC: J3.13, U14.3 (I1a), U18.3 (QA)
PGM_AD: J3.14, U14.6 (I1b), U18.2 (QB)
PGM_AE: J3.15, U14.10 (I1c), U18.6 (QC)
PGM_AF: U14.13 (I1d), U18.7 (QD)
QC: J4.11, U1.1, U2.12 (D), U6.3, U6.4, U22.5
QL: J4.12, U7.3, U7.4
QR: U2.5 (Q), U23.13
QS: U1.5, U6.10, U6.11, U15.5 (UP), U22.4
RAW_CPY_CLK: R26.1, U1.2, U4.4 (DOWN), U19.1
RAW_SYS_CLK: J4.7, R26.2
ROM_A0: J2.1, U11.4 (Za)
ROM_A1: J2.2, U11.7 (Zb)
ROM_A2: J2.3, U11.9 (Zc)
ROM_A3: J2.4, U11.12 (Zd)
ROM_A4: J2.5, U12.4 (Za)
ROM_A5: J2.6, U12.7 (Zb)
ROM_A6: J2.7, U12.9 (Zc)
ROM_A7: J2.8, U12.12 (Zd)
ROM_A8: J2.9, U13.4 (Za)
ROM_A9: J2.10, U13.7 (Zb)
ROM_AA: J2.11, U13.9 (Zc)
ROM_AB: J2.12, U13.12 (Zd)
ROM_AC: J2.13, U14.4 (Za)
ROM_AD: J2.14, U14.7 (Zb)
ROM_AE: J2.15, U14.9 (Zc)
Reset: U2.2 (D), U7.11
SRAM ~CE: J4.13, U22.6
VCC: C1.1, C2.1, C3.1, C4.1, C6.1, C7.1, C9.1, C11.1, C12.1, C13.1, C14.1, C15.1, C16.1, C17.1, C18.1, C19.1, C20.1, C21.1, C22.1, C24.1, C25.1, J5.1, J6.1, U1.14 (VCC), U2.1 (~R), U2.13 (~R), U2.14 (VCC), U3.14 (VCC), U4.5 (UP), U4.9 (D), U4.15 (A), U4.16 (VCC), U6.14 (VCC), U7.14 (VCC), U9.11 (D0), U9.12 (D1), U9.16 (VCC), U11.16 (VCC), U12.16 (VCC), U13.16 (VCC), U14.16 (VCC), U15.4 (DOWN), U15.9 (D), U15.10 (C), U15.15 (A), U15.16 (VCC), U16.1 (B), U16.9 (D), U16.10 (C), U16.15 (A), U16.16 (VCC), U17.1 (B), U17.9 (D), U17.10 (C), U17.15 (A), U17.16 (VCC), U18.1 (B), U18.10 (C), U18.15 (A), U18.16 (VCC), U19.14 (VCC), U21.14 (VCC), U22.14 (VCC), U23.14 (VCC)
~1-Bit Count Low Clock: U6.9, U7.5, U19.12
~1-Bit Count: U6.13, U19.10
~CPYHLD: J4.2, U3.3
~DONE: J4.4, U2.9 (Q), U3.1, U3.2, U11.1 (S), U12.1 (S), U13.1 (S), U14.1 (S)
~QC: U4.14 (CLR), U6.2, U6.6, U23.12
~QL: U7.2, U7.6
~QR: J4.3, U2.6 (~Q), U9.1 (~PL), U15.11 (~LOAD), U16.11 (~LOAD), U17.11 (~LOAD), U18.11 (~LOAD), U21.12, U22.2
~QS: U6.8, U6.12
~Qr * /BO: U4.11 (~LOAD), U21.11
~RESET: J4.1, U2.4 (~S), U2.10 (~S), U6.1, U7.12, U7.13
~Raw_Cpy_Clk: U2.3 (C), U2.11 (C), U19.2, U21.1

Notes on the sheet:
SHIFT RESET
Shift Out
Shifting SR Latch
Resetting D-Latch
LATCH ENABLE
Clock
SRAM ~{CE}
SRAM ~{WE}
Bits Counter
Unused
Power & Decoupling
Copying SR Latch
SRAM ~{OE}
Address Multiplexers
Done D-Type Latch
SHIFT ENABLE
Address Counters
Signal Shaping
Interconnects
Latching SR Latch

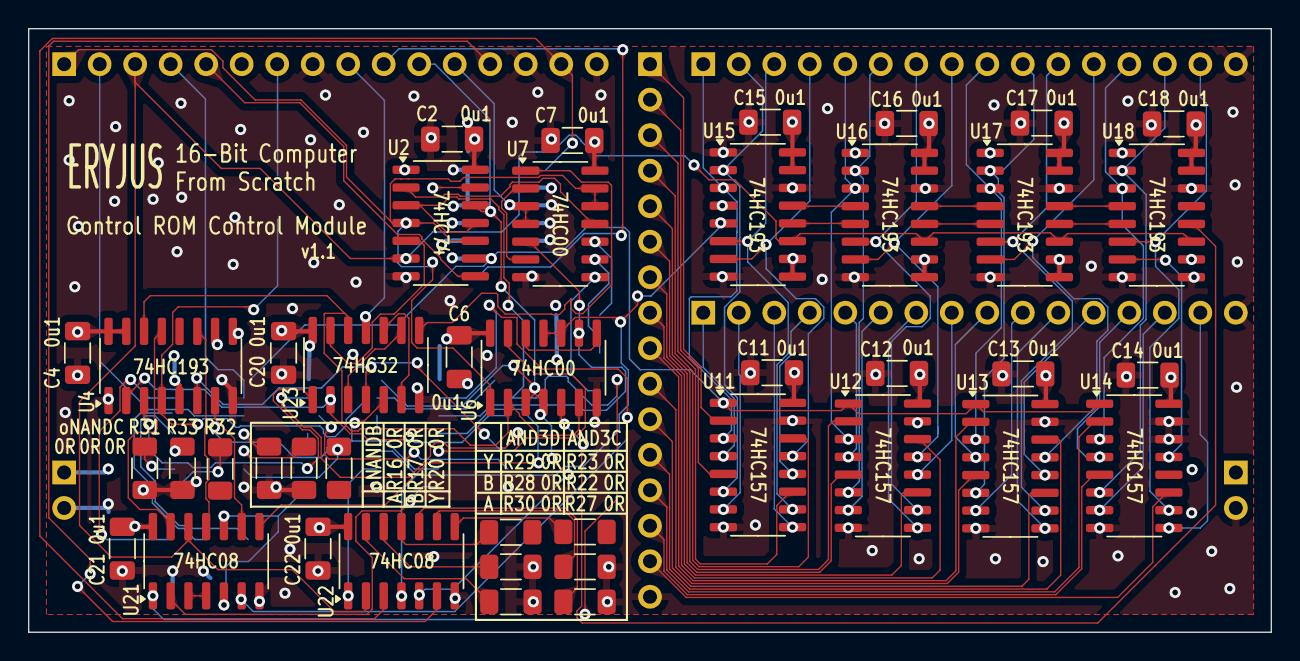
[picture p27: board ctrl-rom-ctrl.kicad_pcb from above]

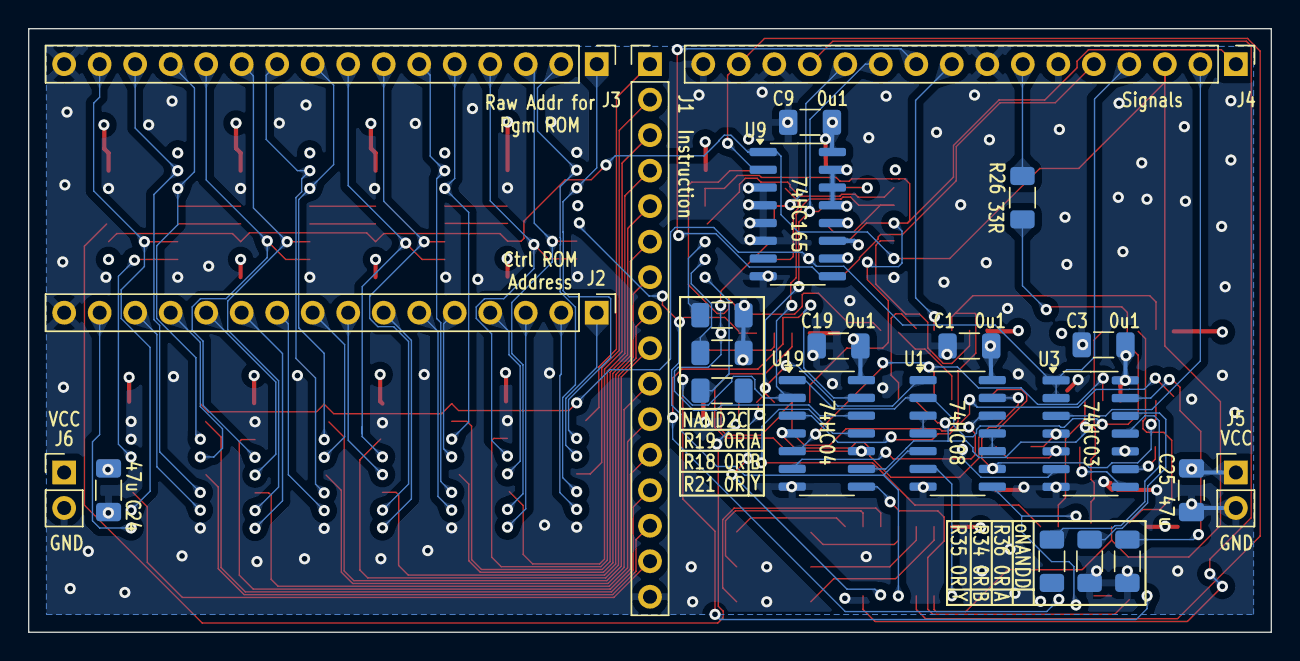
[picture p28: board ctrl-rom-ctrl.kicad_pcb from below]

Board: 4 copper layers, 88.9 x 43.2 mm, 65 parts (23 on the bottom side), 114 nets.
