eryjus/16bcfs/kicad/projects/16bcfs/ctrl-rom-module/ctrl-rom-module.kicad_pcb

## KiCad design kicad/projects/16bcfs/ctrl-rom-module/ctrl-rom-module.kicad_pcb (2024-12-25)

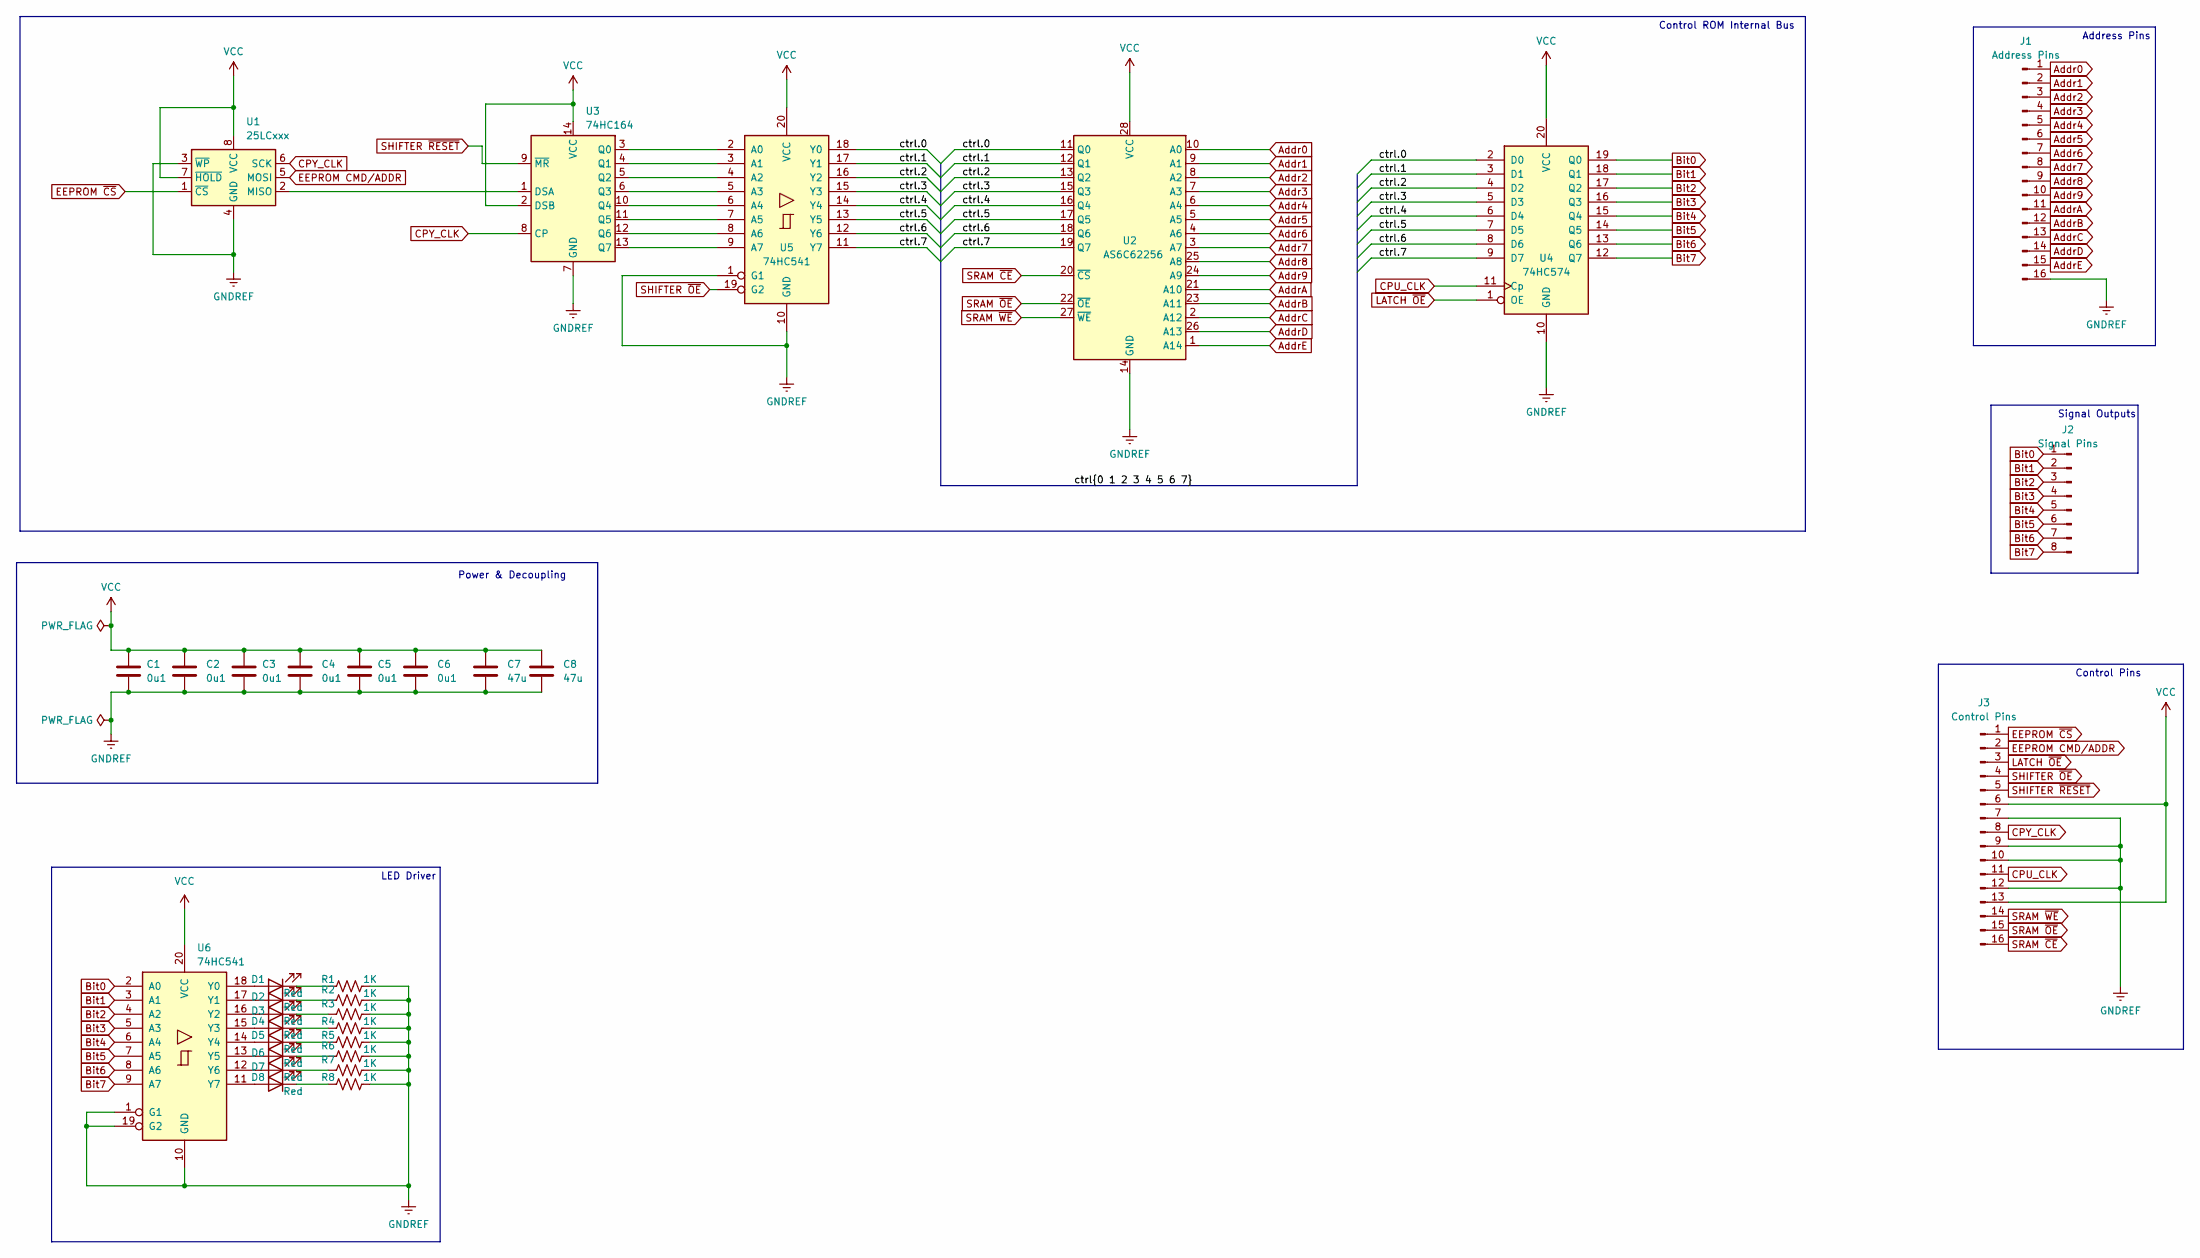
[picture p29: schematic ctrl-rom-module.kicad_sch, Control ROM]

Parts:
C1, C2, C3, C4, C5, C6: 0u1; C_1206_3216Metric_Pad1.33x1.80mm_HandSolder
C7, C8: 47u; C_1206_3216Metric_Pad1.33x1.80mm_HandSolder
D1, D2, D3, D4, D5, D6, D7, D8: Red; LED_1206_3216Metric_Pad1.42x1.75mm_HandSolder
J1: Address Pins; PinHeader_1x16_P2.54mm_Vertical
J2: Signal Pins; PinHeader_1x08_P2.54mm_Vertical
J3: Control Pins; PinHeader_1x16_P2.54mm_Vertical
R1, R2, R3, R4, R5, R6, R7, R8: 1K; R_1206_3216Metric_Pad1.30x1.75mm_HandSolder
U1: 25LCxxx; DIP-8_W7.62mm_Socket
U2: AS6C62256; SOP-28_MIL330_ALL
U3: 74HC164; SOIC-14_3.9x8.7mm_P1.27mm
U4: 74HC574; SOIC-20W_7.5x12.8mm_P1.27mm
U5, U6: 74HC541; SOIC-20W_7.5x12.8mm_P1.27mm

Connections:
/ctrl.0: U2.11 (Q0), U4.2 (D0), U5.18 (Y0)
/ctrl.1: U2.12 (Q1), U4.3 (D1), U5.17 (Y1)
/ctrl.2: U2.13 (Q2), U4.4 (D2), U5.16 (Y2)
/ctrl.3: U2.15 (Q3), U4.5 (D3), U5.15 (Y3)
/ctrl.4: U2.16 (Q4), U4.6 (D4), U5.14 (Y4)
/ctrl.5: U2.17 (Q5), U4.7 (D5), U5.13 (Y5)
/ctrl.6: U2.18 (Q6), U4.8 (D6), U5.12 (Y6)
/ctrl.7: U2.19 (Q7), U4.9 (D7), U5.11 (Y7)
Addr0: J1.1, U2.10 (A0)
Addr1: J1.2, U2.9 (A1)
Addr2: J1.3, U2.8 (A2)
Addr3: J1.4, U2.7 (A3)
Addr4: J1.5, U2.6 (A4)
Addr5: J1.6, U2.5 (A5)
Addr6: J1.7, U2.4 (A6)
Addr7: J1.8, U2.3 (A7)
Addr8: J1.9, U2.25 (A8)
Addr9: J1.10, U2.24 (A9)
AddrA: J1.11, U2.21 (A10)
AddrB: J1.12, U2.23 (A11)
AddrC: J1.13, U2.2 (A12)
AddrD: J1.14, U2.26 (A13)
AddrE: J1.15, U2.1 (A14)
Bit0: J2.1, U4.19 (Q0), U6.2 (A0)
Bit1: J2.2, U4.18 (Q1), U6.3 (A1)
Bit2: J2.3, U4.17 (Q2), U6.4 (A2)
Bit3: J2.4, U4.16 (Q3), U6.5 (A3)
Bit4: J2.5, U4.15 (Q4), U6.6 (A4)
Bit5: J2.6, U4.14 (Q5), U6.7 (A5)
Bit6: J2.7, U4.13 (Q6), U6.8 (A6)
Bit7: J2.8, U4.12 (Q7), U6.9 (A7)
CPU_CLK: J3.11, U4.11 (Cp)
CPY_CLK: J3.8, U1.6 (SCK), U3.8 (CP)
EEPROM CMD/ADDR: J3.2, U1.5 (MOSI)
EEPROM ~CS: J3.1, U1.1 (~CS)
GNDREF: C1.2, C2.2, C3.2, C4.2, C5.2, C6.2, C7.2, C8.2, J1.16, J3.7, J3.9, J3.10, J3.12, R1.2, R2.2, R3.2, R4.2, R5.2, R6.2, R7.2, R8.2, U1.3 (~WP), U1.4 (GND), U2.14 (GND), U3.7 (GND), U4.10 (GND), U5.1 (G1), U5.10 (GND), U6.1 (G1), U6.10 (GND), U6.19 (G2)
LATCH ~OE: J3.3, U4.1 (OE)
unnamed: D1.2 (A), U6.18 (Y0)
unnamed: D1.1 (K), R1.1
unnamed: D2.2 (A), U6.17 (Y1)
unnamed: D2.1 (K), R2.1
unnamed: D3.2 (A), U6.16 (Y2)
unnamed: D3.1 (K), R3.1
unnamed: D4.2 (A), U6.15 (Y3)
unnamed: D4.1 (K), R4.1
unnamed: D5.2 (A), U6.14 (Y4)
unnamed: D5.1 (K), R5.1
unnamed: D6.2 (A), U6.13 (Y5)
unnamed: D6.1 (K), R6.1
unnamed: D7.2 (A), U6.12 (Y6)
unnamed: D7.1 (K), R7.1
unnamed: D8.2 (A), U6.11 (Y7)
unnamed: D8.1 (K), R8.1
unnamed: U1.2 (MISO), U3.1 (DSA)
unnamed: U3.3 (Q0), U5.2 (A0)
unnamed: U3.4 (Q1), U5.3 (A1)
unnamed: U3.5 (Q2), U5.4 (A2)
unnamed: U3.6 (Q3), U5.5 (A3)
unnamed: U3.10 (Q4), U5.6 (A4)
unnamed: U3.11 (Q5), U5.7 (A5)
unnamed: U3.12 (Q6), U5.8 (A6)
unnamed: U3.13 (Q7), U5.9 (A7)
SHIFTER ~OE: J3.4, U5.19 (G2)
SHIFTER ~RESET: J3.5, U3.9 (~MR)
SRAM ~CE: J3.16, U2.20 (~CS)
SRAM ~OE: J3.15, U2.22 (~OE)
SRAM ~WE: J3.14, U2.27 (~WE)
VCC: C1.1, C2.1, C3.1, C4.1, C5.1, C6.1, C7.1, C8.1, J3.6, J3.13, U1.7 (~HOLD), U1.8 (VCC), U2.28 (VCC), U3.2 (DSB), U3.14 (VCC), U4.20 (VCC), U5.20 (VCC), U6.20 (VCC)

Notes on the sheet:
Control ROM Internal Bus
Address Pins
Signal Outputs
Power & Decoupling
Control Pins
LED Driver

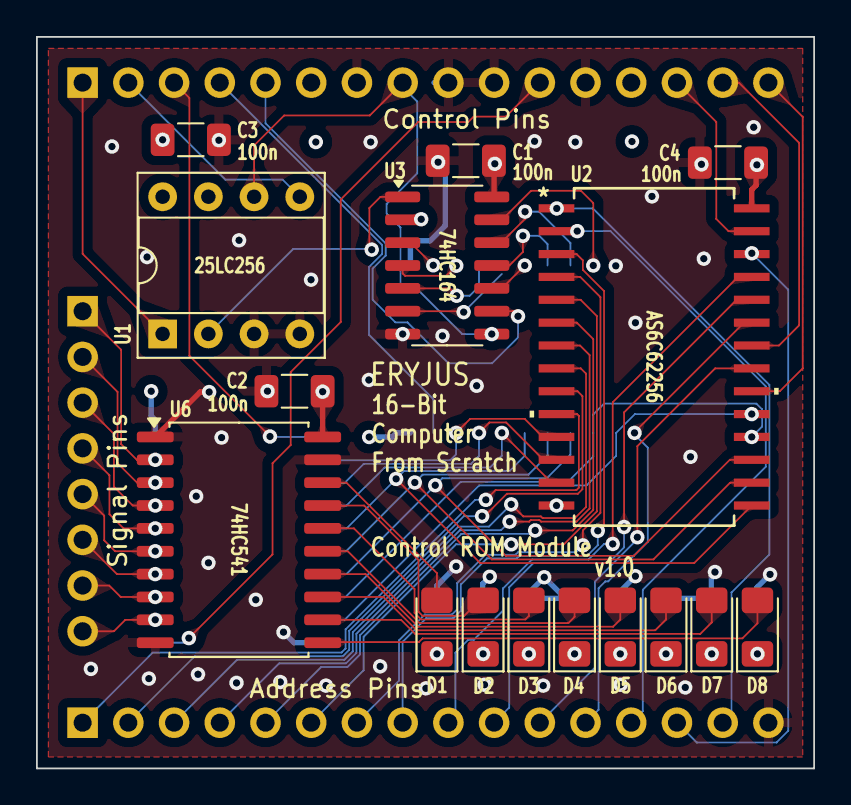
[picture p30: board ctrl-rom-module.kicad_pcb from above]

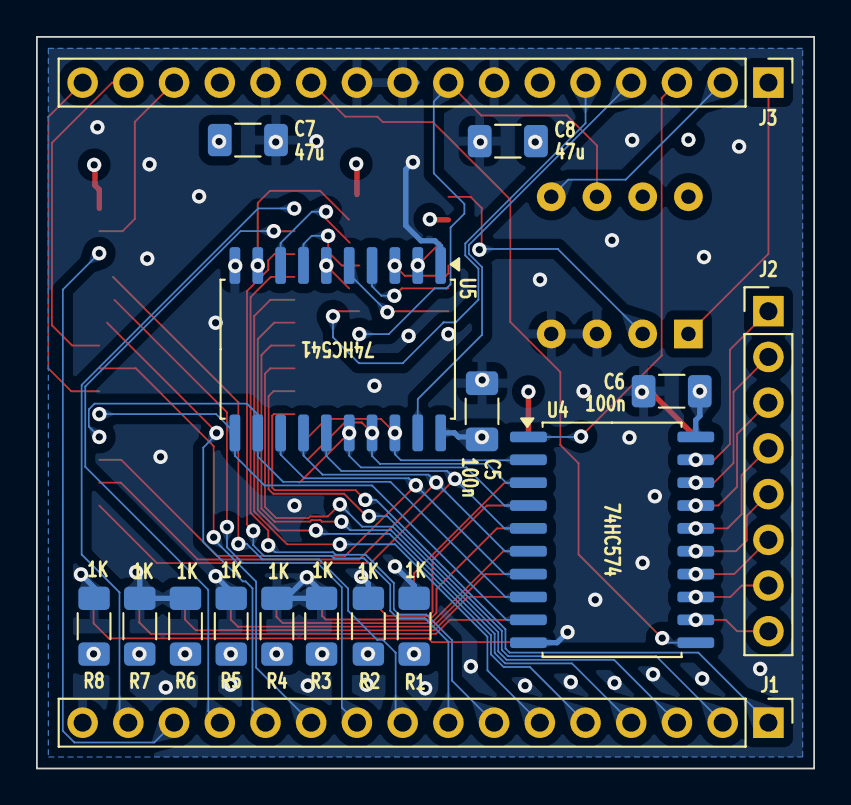
[picture p31: board ctrl-rom-module.kicad_pcb from below]

Board: 4 copper layers, 43.2 x 40.6 mm, 33 parts (17 on the bottom side), 68 nets.
