eryjus/16bcfs/kicad/projects/16bcfs/instr-register-module/instr-register-module.kicad_pcb

## KiCad design kicad/projects/16bcfs/instr-register-module/instr-register-module.kicad_pcb (2024-06-23)

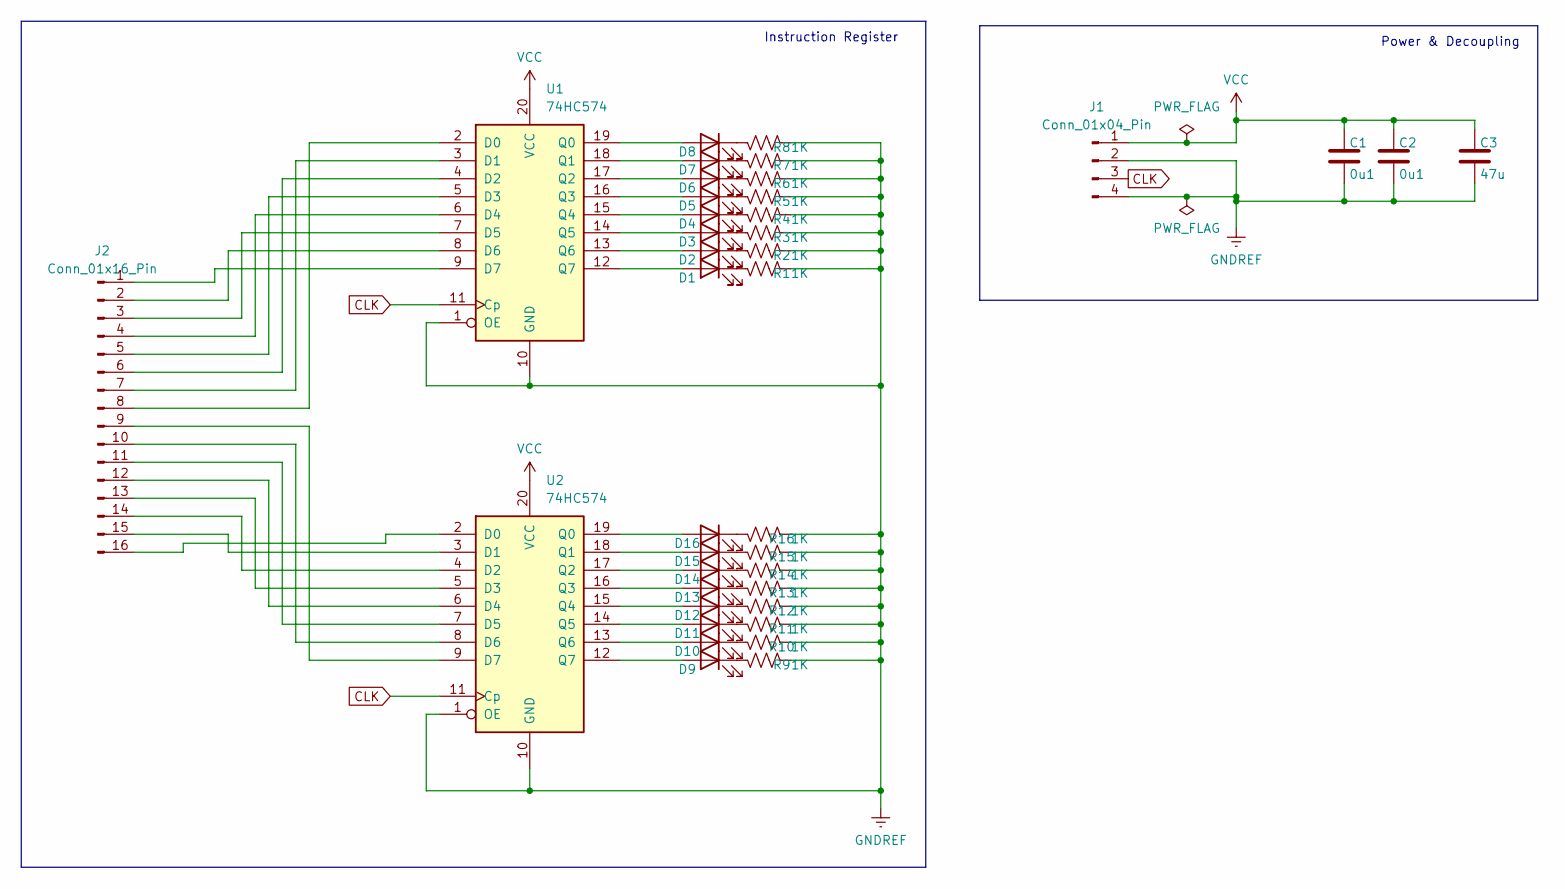
[picture p32: schematic instr-register-module.kicad_sch, Instruction Register]

Parts:
C1, C2: 0u1; C_1206_3216Metric_Pad1.33x1.80mm_HandSolder
C3: 47u; C_1206_3216Metric_Pad1.33x1.80mm_HandSolder
D1, D2, D3, D4, D5, D6, D7, D8, D9, D10, D11, D12, D13, D14, D15, D16: LED; LED_1206_3216Metric_Pad1.42x1.75mm_HandSolder
J1: Conn_01x04_Pin; PinHeader_1x04_P2.54mm_Vertical
J2: Conn_01x16_Pin; PinHeader_1x16_P2.54mm_Vertical
R1, R2, R3, R4, R5, R6, R7, R8, R9, R10, R11, R12, R13, R14, R15, R16: 1K; R_1206_3216Metric_Pad1.30x1.75mm_HandSolder
U1, U2: 74HC574; SOIC-20W_7.5x12.8mm_P1.27mm

Connections:
CLK: J1.3, U1.11 (Cp), U2.11 (Cp)
GNDREF: C1.2, C2.2, C3.2, J1.2, J1.4, R1.2, R2.2, R3.2, R4.2, R5.2, R6.2, R7.2, R8.2, R9.2, R10.2, R11.2, R12.2, R13.2, R14.2, R15.2, R16.2, U1.1 (OE), U1.10 (GND), U2.1 (OE), U2.10 (GND)
unnamed: D1.2 (A), U1.12 (Q7)
unnamed: D1.1 (K), R1.1
unnamed: D2.2 (A), U1.13 (Q6)
unnamed: D2.1 (K), R2.1
unnamed: D3.2 (A), U1.14 (Q5)
unnamed: D3.1 (K), R3.1
unnamed: D4.2 (A), U1.15 (Q4)
unnamed: D4.1 (K), R4.1
unnamed: D5.2 (A), U1.16 (Q3)
unnamed: D5.1 (K), R5.1
unnamed: D6.2 (A), U1.17 (Q2)
unnamed: D6.1 (K), R6.1
unnamed: D7.2 (A), U1.18 (Q1)
unnamed: D7.1 (K), R7.1
unnamed: D8.2 (A), U1.19 (Q0)
unnamed: D8.1 (K), R8.1
unnamed: D9.2 (A), U2.12 (Q7)
unnamed: D9.1 (K), R9.1
unnamed: D10.2 (A), U2.13 (Q6)
unnamed: D10.1 (K), R10.1
unnamed: D11.2 (A), U2.14 (Q5)
unnamed: D11.1 (K), R11.1
unnamed: D12.2 (A), U2.15 (Q4)
unnamed: D12.1 (K), R12.1
unnamed: D13.2 (A), U2.16 (Q3)
unnamed: D13.1 (K), R13.1
unnamed: D14.2 (A), U2.17 (Q2)
unnamed: D14.1 (K), R14.1
unnamed: D15.2 (A), U2.18 (Q1)
unnamed: D15.1 (K), R15.1
unnamed: D16.2 (A), U2.19 (Q0)
unnamed: D16.1 (K), R16.1
unnamed: J2.1, U1.9 (D7)
unnamed: J2.2, U1.8 (D6)
unnamed: J2.3, U1.7 (D5)
unnamed: J2.4, U1.6 (D4)
unnamed: J2.5, U1.5 (D3)
unnamed: J2.6, U1.4 (D2)
unnamed: J2.7, U1.3 (D1)
unnamed: J2.8, U1.2 (D0)
unnamed: J2.9, U2.9 (D7)
unnamed: J2.10, U2.8 (D6)
unnamed: J2.11, U2.7 (D5)
unnamed: J2.12, U2.6 (D4)
unnamed: J2.13, U2.5 (D3)
unnamed: J2.14, U2.4 (D2)
unnamed: J2.15, U2.3 (D1)
unnamed: J2.16, U2.2 (D0)
VCC: C1.1, C2.1, C3.1, J1.1, U1.20 (VCC), U2.20 (VCC)

Notes on the sheet:
Power & Decoupling
Instruction Register

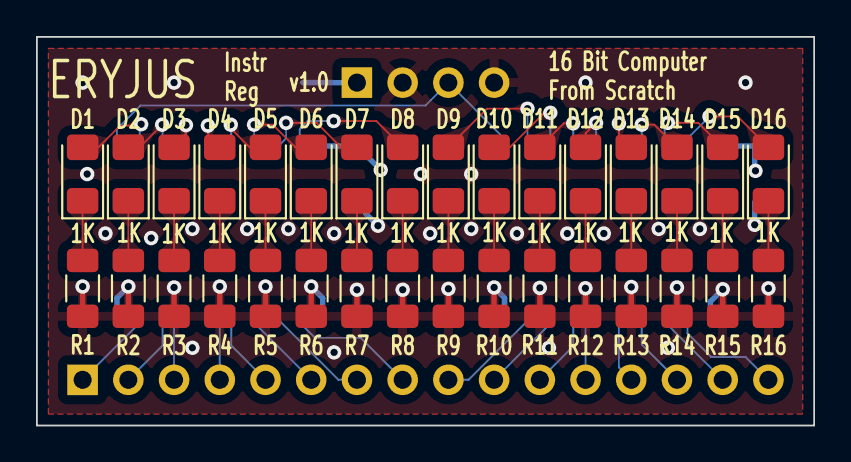
[picture p33: board instr-register-module.kicad_pcb from above]

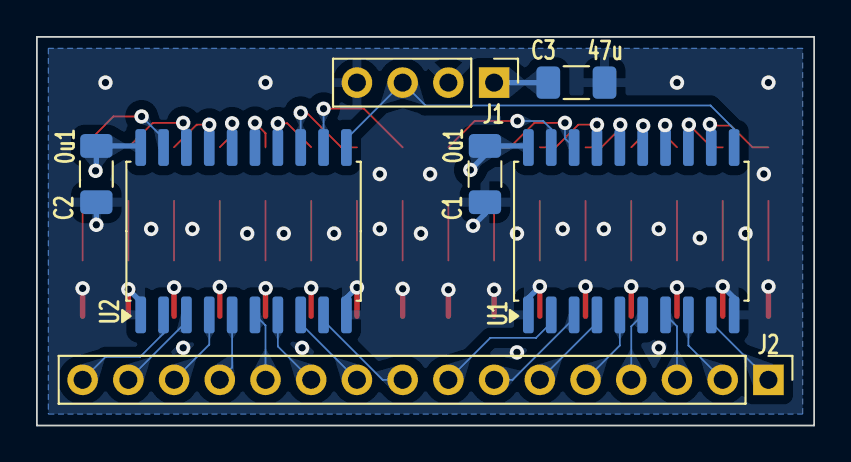
[picture p34: board instr-register-module.kicad_pcb from below]

Board: 4 copper layers, 43.2 x 21.6 mm, 39 parts (7 on the bottom side), 51 nets.
