eryjus/16bcfs/kicad/projects/16bcfs/fetch-register/fetch-register.kicad_pcb

## KiCad design kicad/projects/16bcfs/fetch-register/fetch-register.kicad_pcb (2024-06-15)

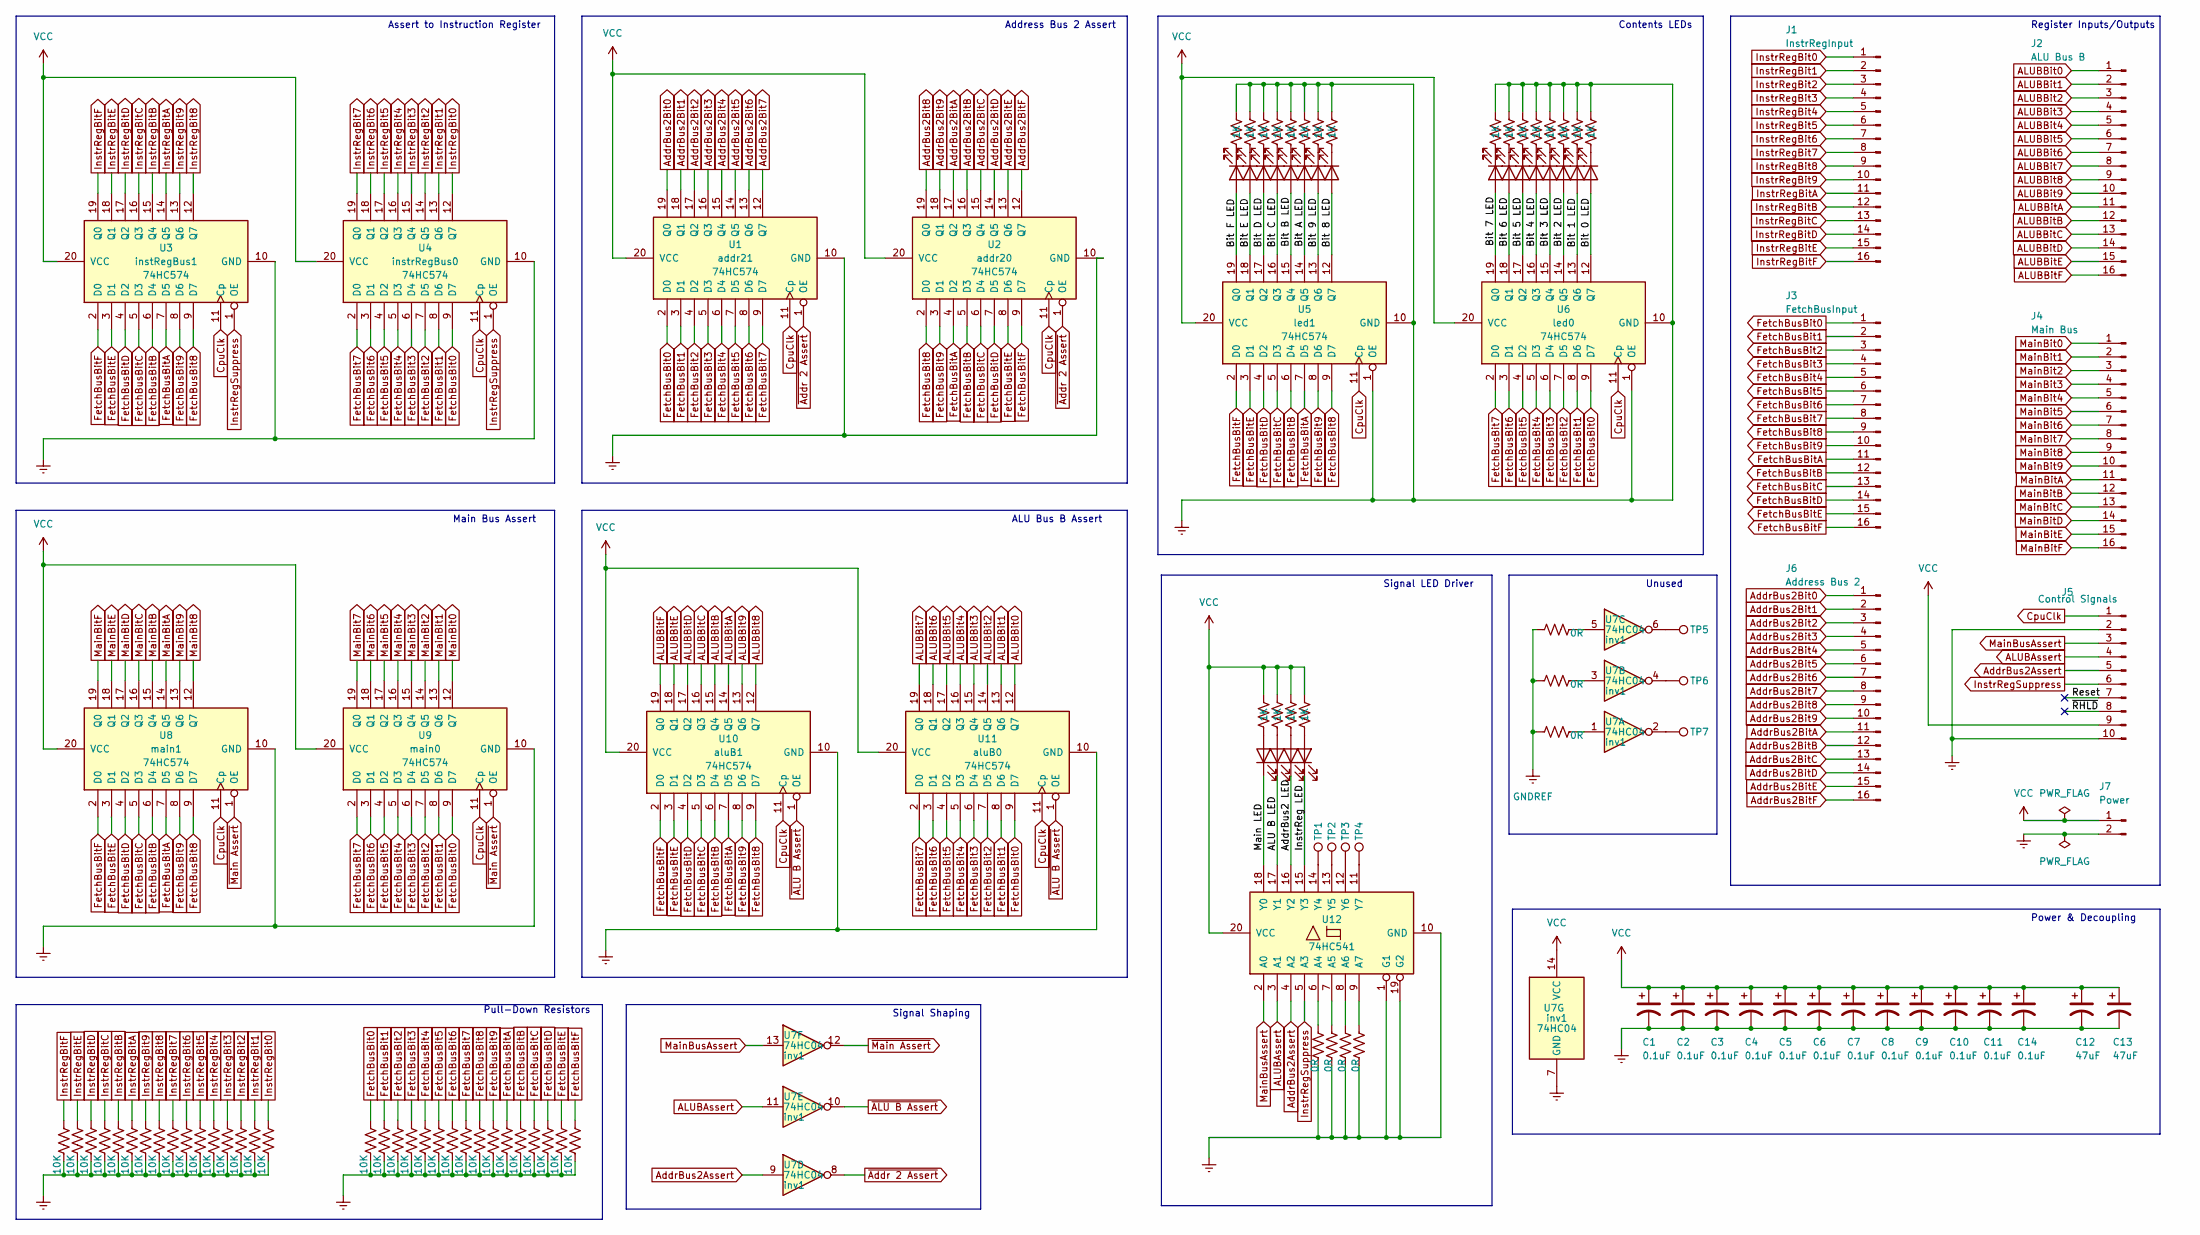
[picture p35: schematic fetch-register.kicad_sch, 16-Bit Register]

Parts:
C1, C2, C3, C4, C5, C6, C7, C8, C9, C10, C11, C14: 0.1uF; C_1206_3216Metric_Pad1.33x1.80mm_HandSolder
C12, C13: 47uF; C_1206_3216Metric_Pad1.33x1.80mm_HandSolder
D1, D2, D3, D4, D5, D6, D7, D8, D9, D10, D11, D12, D13, D14, D15, D16: Green; LED_1206_3216Metric_Pad1.42x1.75mm_HandSolder
D17, D18, D19, D20: Red; LED_1206_3216Metric_Pad1.42x1.75mm_HandSolder
J1: InstrRegInput; PinHeader_1x16_P2.54mm_Vertical
J2: ALU Bus B; PinHeader_1x16_P2.54mm_Vertical
J3: FetchBusInput; PinHeader_1x16_P2.54mm_Vertical
J4: Main Bus; PinHeader_1x16_P2.54mm_Vertical
J5: Control Signals; PinHeader_1x10_P2.54mm_Vertical
J6: Address Bus 2; PinHeader_1x16_P2.54mm_Vertical
J7: Power; PinHeader_1x02_P2.54mm_Vertical
R1, R2, R3, R4, R5, R6, R7, R8, R9, R10, R11, R12, R13, R14, R15, R16, R17, R18, R19, R20: 1K; R_1206_3216Metric_Pad1.30x1.75mm_HandSolder
R21, R22, R23, R24, R25, R26, R27, R28, R29, R30, R31, R32, R33, R34, R35, R36, R37, R38, R39, R40, R41, R42, R43, R44, R45, R46, R47, R48, R49, R50, R51, R52: 10K; R_1206_3216Metric_Pad1.30x1.75mm_HandSolder
R53, R54, R55, R56, R57, R58, R59: 0R; R_1206_3216Metric_Pad1.30x1.75mm_HandSolder
TP1, TP2, TP3, TP4, TP5, TP6, TP7: TestPoint; TestPoint_SMD_D0.8mm
U1, U2, U3, U4, U5, U6, U8, U9, U10, U11: 74HC574; SOIC-20W_7.5x12.8mm_P1.27mm
U7: 74HC04; SOIC-14_3.9x8.7mm_P1.27mm
U12: 74HC541; SOIC-20W_7.5x12.8mm_P1.27mm

Connections:
/ALU B LED: D18.1 (K), U12.17 (Y1)
/AddrBus2 LED: D19.1 (K), U12.16 (Y2)
/Bit 0 LED: D16.2 (A), U6.12 (Q7)
/Bit 1 LED: D15.2 (A), U6.13 (Q6)
/Bit 2 LED: D14.2 (A), U6.14 (Q5)
/Bit 3 LED: D13.2 (A), U6.15 (Q4)
/Bit 4 LED: D12.2 (A), U6.16 (Q3)
/Bit 5 LED: D11.2 (A), U6.17 (Q2)
/Bit 6 LED: D10.2 (A), U6.18 (Q1)
/Bit 7 LED: D9.2 (A), U6.19 (Q0)
/Bit 8 LED: D8.2 (A), U5.12 (Q7)
/Bit 9 LED: D7.2 (A), U5.13 (Q6)
/Bit A LED: D6.2 (A), U5.14 (Q5)
/Bit B LED: D5.2 (A), U5.15 (Q4)
/Bit C LED: D4.2 (A), U5.16 (Q3)
/Bit D LED: D3.2 (A), U5.17 (Q2)
/Bit E LED: D2.2 (A), U5.18 (Q1)
/Bit F LED: D1.2 (A), U5.19 (Q0)
/InstrReg LED: D20.1 (K), U12.15 (Y3)
/Main LED: D17.1 (K), U12.18 (Y0)
/Reset: J5.7
/~RHLD: J5.8
ALUBAssert: J5.4, U7.11, U12.3 (A1)
ALUBBit0: J2.1, U11.12 (Q7)
ALUBBit1: J2.2, U11.13 (Q6)
ALUBBit2: J2.3, U11.14 (Q5)
ALUBBit3: J2.4, U11.15 (Q4)
ALUBBit4: J2.5, U11.16 (Q3)
ALUBBit5: J2.6, U11.17 (Q2)
ALUBBit6: J2.7, U11.18 (Q1)
ALUBBit7: J2.8, U11.19 (Q0)
ALUBBit8: J2.9, U10.12 (Q7)
ALUBBit9: J2.10, U10.13 (Q6)
ALUBBitA: J2.11, U10.14 (Q5)
ALUBBitB: J2.12, U10.15 (Q4)
ALUBBitC: J2.13, U10.16 (Q3)
ALUBBitD: J2.14, U10.17 (Q2)
ALUBBitE: J2.15, U10.18 (Q1)
ALUBBitF: J2.16, U10.19 (Q0)
AddrBus2Assert: J5.5, U7.9, U12.4 (A2)
AddrBus2Bit0: J6.1, U1.19 (Q0)
AddrBus2Bit1: J6.2, U1.18 (Q1)
AddrBus2Bit2: J6.3, U1.17 (Q2)
AddrBus2Bit3: J6.4, U1.16 (Q3)
AddrBus2Bit4: J6.5, U1.15 (Q4)
AddrBus2Bit5: J6.6, U1.14 (Q5)
AddrBus2Bit6: J6.7, U1.13 (Q6)
AddrBus2Bit7: J6.8, U1.12 (Q7)
AddrBus2Bit8: J6.9, U2.19 (Q0)
AddrBus2Bit9: J6.10, U2.18 (Q1)
AddrBus2BitA: J6.11, U2.17 (Q2)
AddrBus2BitB: J6.12, U2.16 (Q3)
AddrBus2BitC: J6.13, U2.15 (Q4)
AddrBus2BitD: J6.14, U2.14 (Q5)
AddrBus2BitE: J6.15, U2.13 (Q6)
AddrBus2BitF: J6.16, U2.12 (Q7)
CpuClk: J5.1, U1.11 (Cp), U2.11 (Cp), U3.11 (Cp), U4.11 (Cp), U5.11 (Cp), U6.11 (Cp), U8.11 (Cp), U9.11 (Cp), U10.11 (Cp), U11.11 (Cp)
FetchBusBit0: J3.1, R37.1, U1.2 (D0), U4.9 (D7), U6.9 (D7), U9.9 (D7), U11.9 (D7)
FetchBusBit1: J3.2, R38.1, U1.3 (D1), U4.8 (D6), U6.8 (D6), U9.8 (D6), U11.8 (D6)
FetchBusBit2: J3.3, R39.1, U1.4 (D2), U4.7 (D5), U6.7 (D5), U9.7 (D5), U11.7 (D5)
FetchBusBit3: J3.4, R40.1, U1.5 (D3), U4.6 (D4), U6.6 (D4), U9.6 (D4), U11.6 (D4)
FetchBusBit4: J3.5, R41.1, U1.6 (D4), U4.5 (D3), U6.5 (D3), U9.5 (D3), U11.5 (D3)
FetchBusBit5: J3.6, R42.1, U1.7 (D5), U4.4 (D2), U6.4 (D2), U9.4 (D2), U11.4 (D2)
FetchBusBit6: J3.7, R43.1, U1.8 (D6), U4.3 (D1), U6.3 (D1), U9.3 (D1), U11.3 (D1)
FetchBusBit7: J3.8, R44.1, U1.9 (D7), U4.2 (D0), U6.2 (D0), U9.2 (D0), U11.2 (D0)
FetchBusBit8: J3.9, R45.1, U2.2 (D0), U3.9 (D7), U5.9 (D7), U8.9 (D7), U10.9 (D7)
FetchBusBit9: J3.10, R46.1, U2.3 (D1), U3.8 (D6), U5.8 (D6), U8.8 (D6), U10.8 (D6)
FetchBusBitA: J3.11, R47.1, U2.4 (D2), U3.7 (D5), U5.7 (D5), U8.7 (D5), U10.7 (D5)
FetchBusBitB: J3.12, R48.1, U2.5 (D3), U3.6 (D4), U5.6 (D4), U8.6 (D4), U10.6 (D4)
FetchBusBitC: J3.13, R49.1, U2.6 (D4), U3.5 (D3), U5.5 (D3), U8.5 (D3), U10.5 (D3)
FetchBusBitD: J3.14, R50.1, U2.7 (D5), U3.4 (D2), U5.4 (D2), U8.4 (D2), U10.4 (D2)
FetchBusBitE: J3.15, R51.1, U2.8 (D6), U3.3 (D1), U5.3 (D1), U8.3 (D1), U10.3 (D1)
FetchBusBitF: J3.16, R52.1, U2.9 (D7), U3.2 (D0), U5.2 (D0), U8.2 (D0), U10.2 (D0)
GNDREF: C1.2, C2.2, C3.2, C4.2, C5.2, C6.2, C7.2, C8.2, C9.2, C10.2, C11.2, C12.2, C13.2, C14.2, J5.2, J5.10, J7.2, R1.1, R2.1, R3.1, R4.1, R5.1, R6.1, R7.1, R8.1, R9.1, R10.1, R11.1, R12.1, R13.1, R14.1, R15.1, R16.1, R21.2, R22.2, R23.2, R24.2, R25.2, R26.2, R27.2, R28.2, R29.2, R30.2, R31.2, R32.2, R33.2, R34.2, R35.2, R36.2, R37.2, R38.2, R39.2, R40.2, R41.2, R42.2, R43.2, R44.2, R45.2, R46.2, R47.2, R48.2, R49.2, R50.2, R51.2, R52.2, R53.2, R54.2, R55.2, R56.2, R57.1, R58.1, R59.1, U1.10 (GND), U2.10 (GND), U3.10 (GND), U4.10 (GND), U5.1 (OE), U5.10 (GND), U6.1 (OE), U6.10 (GND), U7.7 (GND), U8.10 (GND), U9.10 (GND), U10.10 (GND), U11.10 (GND), U12.1 (G1), U12.10 (GND), U12.19 (G2)
InstrRegBit0: J1.1, R36.1, U4.12 (Q7)
InstrRegBit1: J1.2, R35.1, U4.13 (Q6)
InstrRegBit2: J1.3, R34.1, U4.14 (Q5)
InstrRegBit3: J1.4, R33.1, U4.15 (Q4)
InstrRegBit4: J1.5, R32.1, U4.16 (Q3)
InstrRegBit5: J1.6, R31.1, U4.17 (Q2)
InstrRegBit6: J1.7, R30.1, U4.18 (Q1)
InstrRegBit7: J1.8, R29.1, U4.19 (Q0)
InstrRegBit8: J1.9, R28.1, U3.12 (Q7)
InstrRegBit9: J1.10, R27.1, U3.13 (Q6)
InstrRegBitA: J1.11, R26.1, U3.14 (Q5)
InstrRegBitB: J1.12, R25.1, U3.15 (Q4)
InstrRegBitC: J1.13, R24.1, U3.16 (Q3)
InstrRegBitD: J1.14, R23.1, U3.17 (Q2)
InstrRegBitE: J1.15, R22.1, U3.18 (Q1)
InstrRegBitF: J1.16, R21.1, U3.19 (Q0)
InstrRegSuppress: J5.6, U3.1 (OE), U4.1 (OE), U12.5 (A3)
MainBit0: J4.1, U9.12 (Q7)
MainBit1: J4.2, U9.13 (Q6)
MainBit2: J4.3, U9.14 (Q5)
MainBit3: J4.4, U9.15 (Q4)
MainBit4: J4.5, U9.16 (Q3)
MainBit5: J4.6, U9.17 (Q2)
MainBit6: J4.7, U9.18 (Q1)
MainBit7: J4.8, U9.19 (Q0)
MainBit8: J4.9, U8.12 (Q7)
MainBit9: J4.10, U8.13 (Q6)
MainBitA: J4.11, U8.14 (Q5)
MainBitB: J4.12, U8.15 (Q4)
MainBitC: J4.13, U8.16 (Q3)
MainBitD: J4.14, U8.17 (Q2)
MainBitE: J4.15, U8.18 (Q1)
MainBitF: J4.16, U8.19 (Q0)
MainBusAssert: J5.3, U7.13, U12.2 (A0)
unnamed: D1.1 (K), R1.2
unnamed: D2.1 (K), R2.2
unnamed: D3.1 (K), R3.2
unnamed: D4.1 (K), R4.2
unnamed: D5.1 (K), R5.2
unnamed: D6.1 (K), R6.2
unnamed: D7.1 (K), R7.2
unnamed: D8.1 (K), R8.2
unnamed: D9.1 (K), R9.2
unnamed: D10.1 (K), R10.2
unnamed: D11.1 (K), R11.2
unnamed: D12.1 (K), R12.2
unnamed: D13.1 (K), R13.2
unnamed: D14.1 (K), R14.2
unnamed: D15.1 (K), R15.2
unnamed: D16.1 (K), R16.2
unnamed: D17.2 (A), R17.2
unnamed: D18.2 (A), R18.2
unnamed: D19.2 (A), R19.2
unnamed: D20.2 (A), R20.2
unnamed: R57.2, U7.1
unnamed: R58.2, U7.3
unnamed: R59.2, U7.5
unnamed: TP5.1, U7.6
unnamed: TP6.1, U7.4
unnamed: TP7.1, U7.2
unnamed: R53.1, U12.6 (A4)
unnamed: R54.1, U12.7 (A5)
unnamed: R55.1, U12.8 (A6)
unnamed: R56.1, U12.9 (A7)
unnamed: TP1.1, U12.14 (Y4)
unnamed: TP2.1, U12.13 (Y5)
unnamed: TP3.1, U12.12 (Y6)
unnamed: TP4.1, U12.11 (Y7)
VCC: C1.1, C2.1, C3.1, C4.1, C5.1, C6.1, C7.1, C8.1, C9.1, C10.1, C11.1, C12.1, C13.1, C14.1, J5.9, J7.1, R17.1, R18.1, R19.1, R20.1, U1.20 (VCC), U2.20 (VCC), U3.20 (VCC), U4.20 (VCC), U5.20 (VCC), U6.20 (VCC), U7.14 (VCC), U8.20 (VCC), U9.20 (VCC), U10.20 (VCC), U11.20 (VCC), U12.20 (VCC)
~ALU B Assert: U7.10, U10.1 (OE), U11.1 (OE)
~Addr 2 Assert: U1.1 (OE), U2.1 (OE), U7.8
~Main Assert: U7.12, U8.1 (OE), U9.1 (OE)

Notes on the sheet:
Contents LEDs
ALU Bus B Assert
Pull-Down Resistors
Signal Shaping
Address Bus 2 Assert
Unused
Signal LED Driver
Power & Decoupling
Main Bus Assert
Register Inputs/Outputs
Assert to Instruction Register

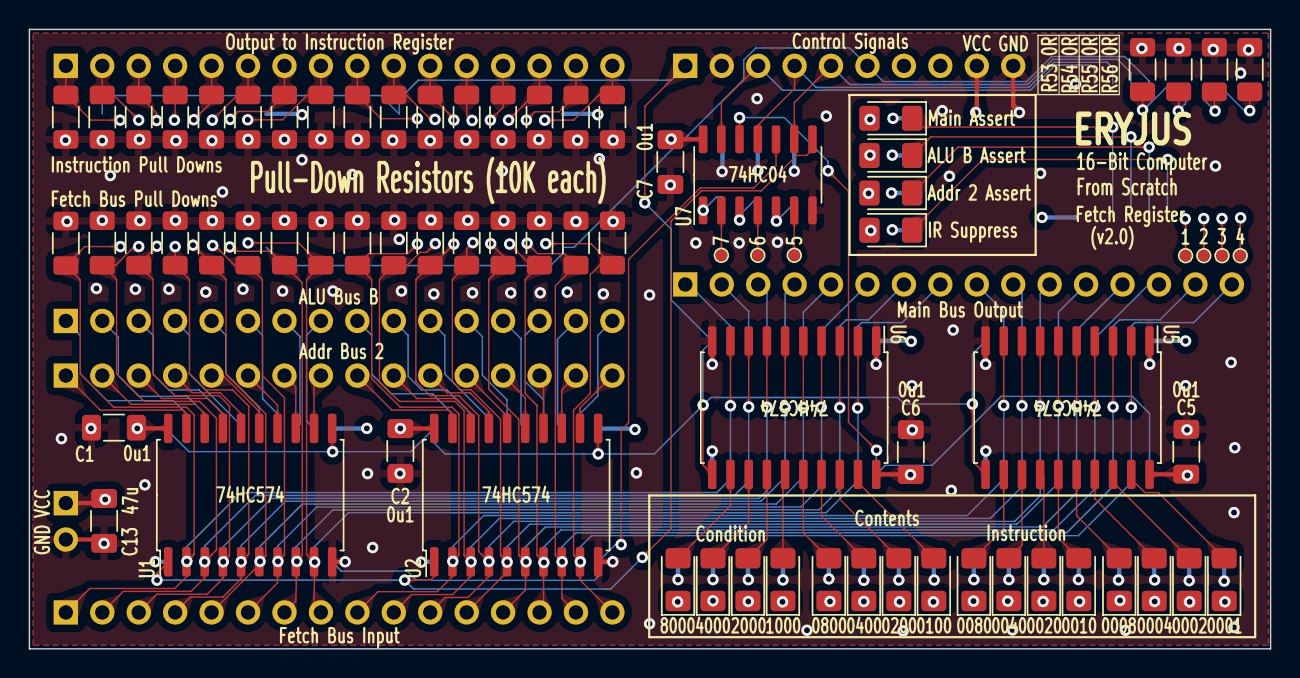
[picture p36: board fetch-register.kicad_pcb from above]

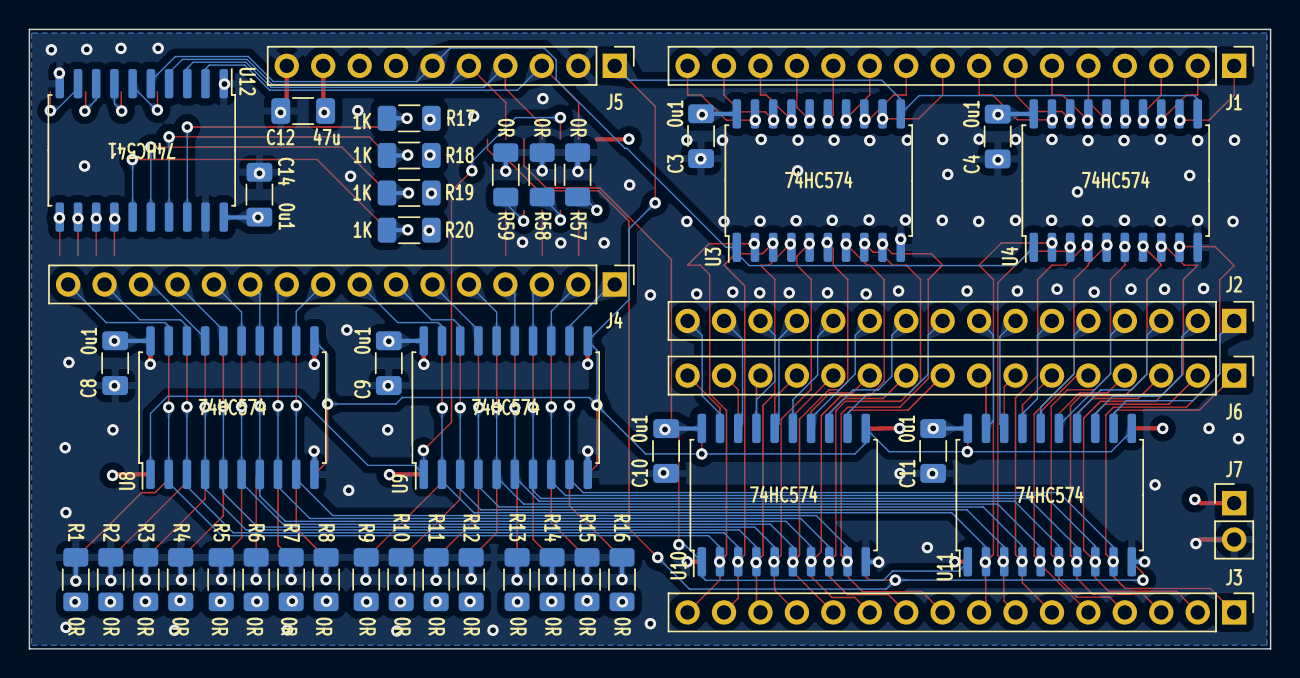
[picture p37: board fetch-register.kicad_pcb from below]

Board: 4 copper layers, 86.5 x 43.2 mm, 119 parts (45 on the bottom side), 144 nets.
