eryjus/16bcfs/kicad/projects/utility/led-array-16/led-array-16.kicad_pcb

## KiCad design kicad/projects/utility/led-array-16/led-array-16.kicad_pcb (2023-11-05)

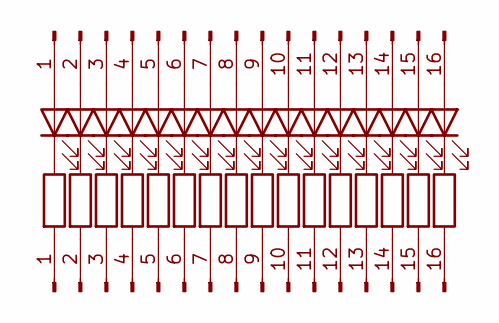
[picture p38: schematic led-array-16.kicad_sch, <pcb-module>]

Parts:
D1, D2, D3, D4, D5, D6, D7, D8, D9, D10, D11, D12, D13, D14, D15, D16: LED; LED_1206_3216Metric_Pad1.42x1.75mm_HandSolder
J1, J2: Conn_01x16_Pin; PinHeader_1x16_P2.54mm_Vertical
R1, R2, R3, R4, R5, R6, R7, R8, R9, R10, R11, R12, R13, R14, R15, R16: R; R_1206_3216Metric_Pad1.30x1.75mm_HandSolder

Connections:
unnamed: D1.2 (A), J1.1
unnamed: D1.1 (K), R1.1
unnamed: D2.2 (A), J1.2
unnamed: D2.1 (K), R2.1
unnamed: D3.2 (A), J1.3
unnamed: D3.1 (K), R3.1
unnamed: D4.2 (A), J1.4
unnamed: D4.1 (K), R4.1
unnamed: D5.2 (A), J1.5
unnamed: D5.1 (K), R5.1
unnamed: D6.2 (A), J1.6
unnamed: D6.1 (K), R6.1
unnamed: D7.2 (A), J1.7
unnamed: D7.1 (K), R7.1
unnamed: D8.2 (A), J1.8
unnamed: D8.1 (K), R8.1
unnamed: D9.2 (A), J1.9
unnamed: D9.1 (K), R9.1
unnamed: D10.2 (A), J1.10
unnamed: D10.1 (K), R10.1
unnamed: D11.2 (A), J1.11
unnamed: D11.1 (K), R11.1
unnamed: D12.2 (A), J1.12
unnamed: D12.1 (K), R12.1
unnamed: D13.2 (A), J1.13
unnamed: D13.1 (K), R13.1
unnamed: D14.2 (A), J1.14
unnamed: D14.1 (K), R14.1
unnamed: D15.2 (A), J1.15
unnamed: D15.1 (K), R15.1
unnamed: D16.2 (A), J1.16
unnamed: D16.1 (K), R16.1
unnamed: J2.1, R1.2
unnamed: J2.2, R2.2
unnamed: J2.3, R3.2
unnamed: J2.4, R4.2
unnamed: J2.5, R5.2
unnamed: J2.6, R6.2
unnamed: J2.7, R7.2
unnamed: J2.8, R8.2
unnamed: J2.9, R9.2
unnamed: J2.10, R10.2
unnamed: J2.11, R11.2
unnamed: J2.12, R12.2
unnamed: J2.13, R13.2
unnamed: J2.14, R14.2
unnamed: J2.15, R15.2
unnamed: J2.16, R16.2

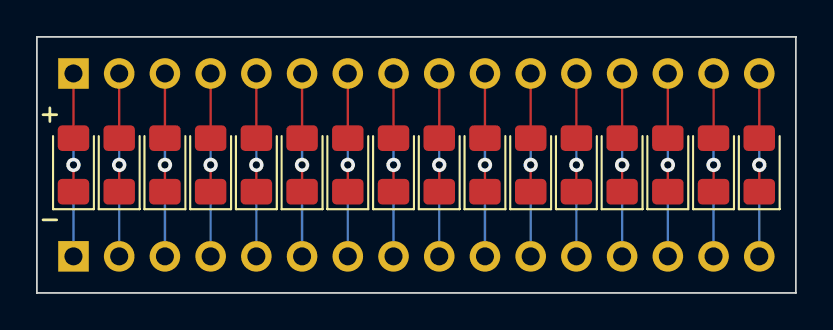
[picture p39: board led-array-16.kicad_pcb from above]

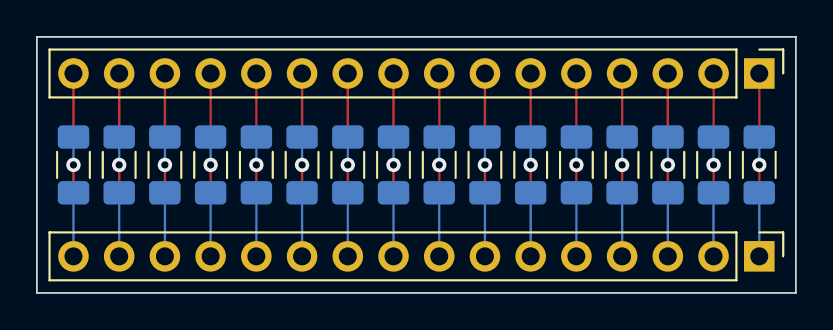
[picture p40: board led-array-16.kicad_pcb from below]

Board: 2 copper layers, 42.2 x 14.2 mm, 34 parts (18 on the bottom side), 48 nets.
