eryjus/16bcfs/kicad/projects/utility/power-interconnect/power-interconnect.kicad_pcb

## KiCad design kicad/projects/utility/power-interconnect/power-interconnect.kicad_pcb (2023-11-05)

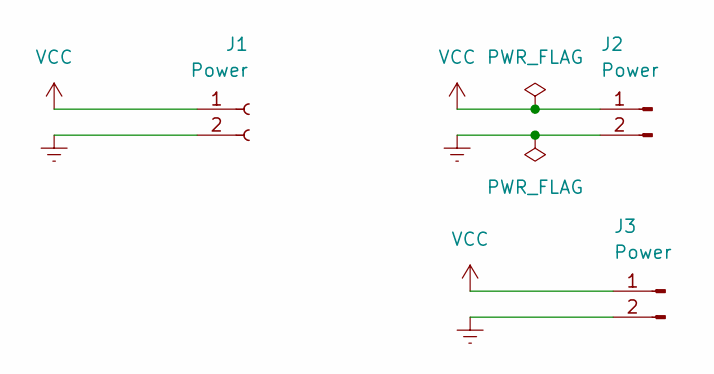
[picture p41: schematic power-interconnect.kicad_sch, <pcb-module>]

Parts:
J1: Power; PinSocket_1x02_P2.54mm_Vertical
J2, J3: Power; PinHeader_1x02_P2.54mm_Vertical

Connections:
GNDREF: J1.2, J2.2, J3.2
VCC: J1.1, J2.1, J3.1

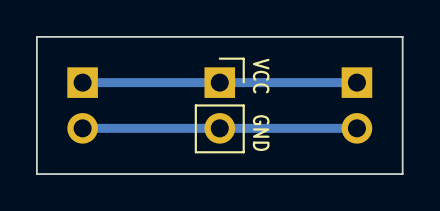
[picture p42: board power-interconnect.kicad_pcb from above]

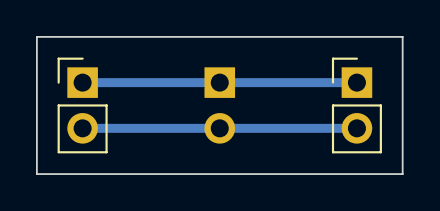
[picture p43: board power-interconnect.kicad_pcb from below]

Board: 2 copper layers, 20.3 x 7.6 mm, 3 parts (2 on the bottom side), 2 nets.
