eryjus/16bcfs/kicad/projects/utility/bus-interconnect/bus-interconnect.kicad_pcb

## KiCad design kicad/projects/utility/bus-interconnect/bus-interconnect.kicad_pcb (2023-11-05)

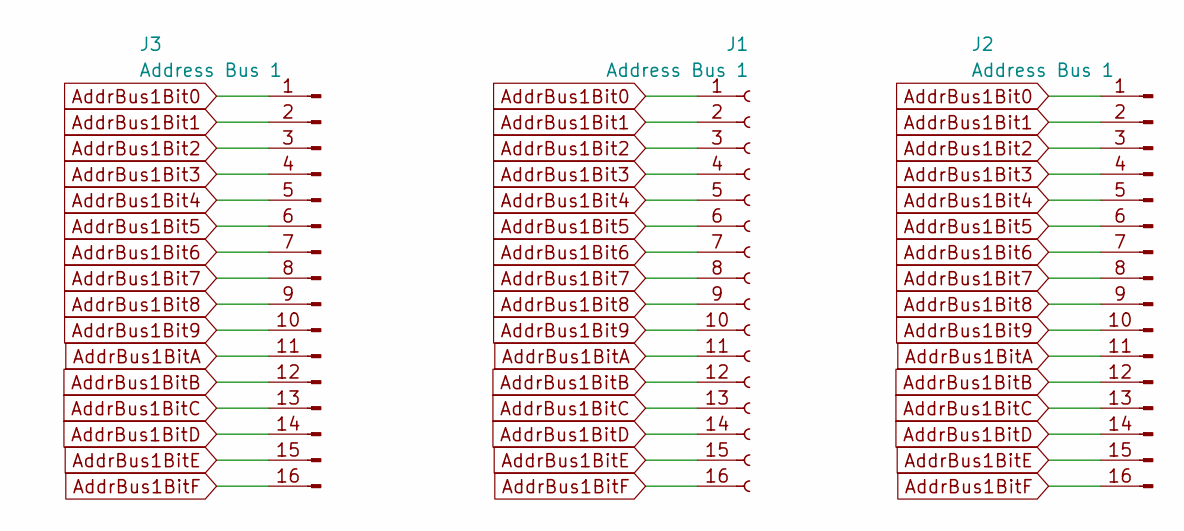
[picture p44: schematic bus-interconnect.kicad_sch, <pcb-module>]

Parts:
J1: Address Bus 1; PinSocket_1x16_P2.54mm_Vertical
J2, J3: Address Bus 1; PinHeader_1x16_P2.54mm_Vertical

Connections:
AddrBus1Bit0: J1.1, J2.1, J3.1
AddrBus1Bit1: J1.2, J2.2, J3.2
AddrBus1Bit2: J1.3, J2.3, J3.3
AddrBus1Bit3: J1.4, J2.4, J3.4
AddrBus1Bit4: J1.5, J2.5, J3.5
AddrBus1Bit5: J1.6, J2.6, J3.6
AddrBus1Bit6: J1.7, J2.7, J3.7
AddrBus1Bit7: J1.8, J2.8, J3.8
AddrBus1Bit8: J1.9, J2.9, J3.9
AddrBus1Bit9: J1.10, J2.10, J3.10
AddrBus1BitA: J1.11, J2.11, J3.11
AddrBus1BitB: J1.12, J2.12, J3.12
AddrBus1BitC: J1.13, J2.13, J3.13
AddrBus1BitD: J1.14, J2.14, J3.14
AddrBus1BitE: J1.15, J2.15, J3.15
AddrBus1BitF: J1.16, J2.16, J3.16

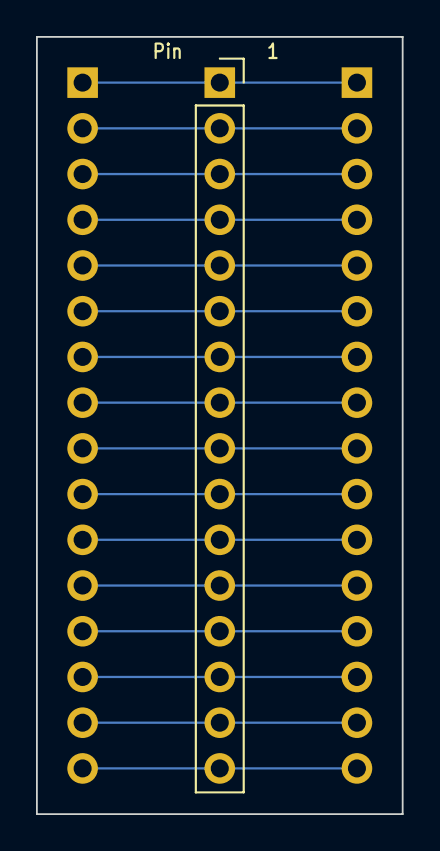
[picture p45: board bus-interconnect.kicad_pcb from above]

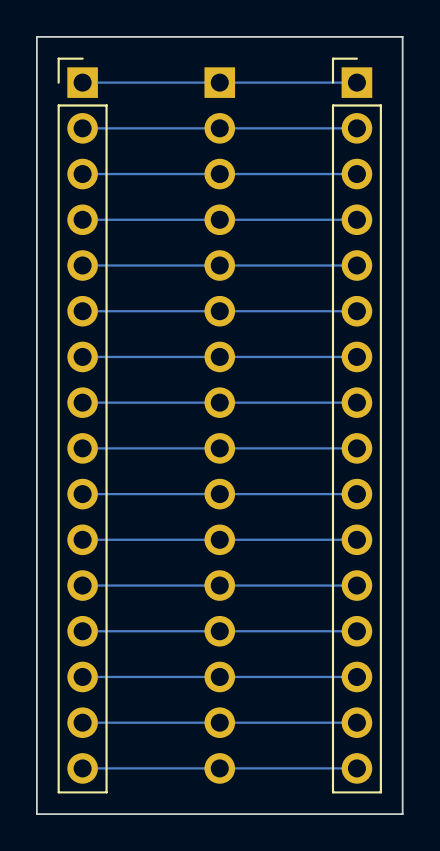
[picture p46: board bus-interconnect.kicad_pcb from below]

Board: 2 copper layers, 20.3 x 43.2 mm, 3 parts (2 on the bottom side), 16 nets.
