eryjus/16bcfs/kicad/projects/utility/spdt-switch/spdt-switch.kicad_pcb

## KiCad design kicad/projects/utility/spdt-switch/spdt-switch.kicad_pcb (2023-11-05)

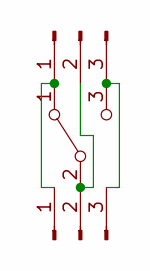
[picture p47: schematic spdt-switch.kicad_sch, <pcb-module>]

Parts:
J1, J2: Conn_01x03_Pin; PinHeader_1x03_P2.54mm_Vertical
SW1: SW_SPDT; Microswitch-LXW-5-1-2

Connections:
unnamed: J1.1, J2.1, SW1.1 (A)
unnamed: J1.2, J2.2, SW1.2 (B)
unnamed: J1.3, J2.3, SW1.3 (C)

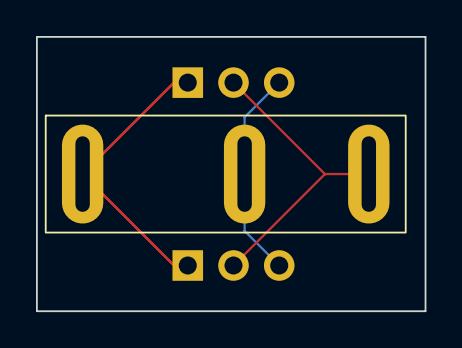
[picture p48: board spdt-switch.kicad_pcb from above]

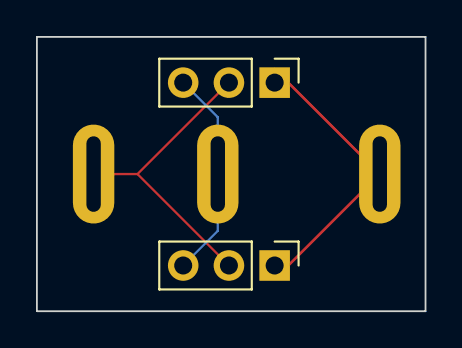
[picture p49: board spdt-switch.kicad_pcb from below]

Board: 2 copper layers, 21.6 x 15.2 mm, 3 parts (2 on the bottom side), 3 nets.
