eryjus/16bcfs/16bcfs-asm/src/table.cc

//===================================================================================================================
//  table.cc -- This is the assembly table for the parser object
//
//  This file contains the whole of the assembly table in constant form.  As this table grows, expect it to take
//  some time to compile.  With that knowledge, a desk-check with any changes is advised.
//
//      Copyright (c) 2024-2025  - Adam Clark
//      License: Beerware
//
//  For reference, the table structure is included here:
//
//      typedef struct {
//          std::string mnemonic;
//          int argCount;
//          int argMask;
//          std::string a1Name;
//          std::string a2Name;
//          std::string a3Name;
//          int binCount;
//          int binMask;        -- where the immed is stuffed
//          uint16_t b1Val;
//          uint16_t b2Val;
//          uint16_t b3Val;
//          uint16_t b4Val;
//          uint16_t b5Val;
//          uint16_t b6Val;
//          uint16_t b7Val;
//          uint16_t b8Val;
//      } AssemblyTable_t;
//
//      Date     Tracker  Version  Description
//  -----------  -------  -------  ---------------------------------------------------------------------------------
//  18-May-2024  Initial           Initial Version
//
//===================================================================================================================



#include "asm.hh"


//
// -- Some helper macros to build the table
//    -------------------------------------
#define OPCODE_1W_NO_ARG(s,v) {std::string(s),0,0x00,"","","",1,0x00,v,0x0000,0x0000,0x0000,0x0000,0x0000,0x0000,0x0000}
#define OPCODE_1W_JMP_IMMED(s,v)  {std::string(s),1,0x00,"","","",2,0x40,v,0x0000,0x0000,0x0000,0x0000,0x0000,0x0000,0x0000}

//
// -- This is the assembly table containing all the instructions
//    ----------------------------------------------------------
Parser_t::AssemblyTable_t Parser_t::table[] = {
// -- brk
    OPCODE_1W_NO_ARG("brk", 0x0001),

// -- nop
    OPCODE_1W_NO_ARG("nop", 0x0000),

// -- jmp
    OPCODE_1W_JMP_IMMED("jmp", 0x0002),
};



//
// -- Calculate the size of the table in element counts
//    -------------------------------------------------
size_t Parser_t::Count(void)
{
    return sizeof(table) / sizeof(AssemblyTable_t);
}




#if 0
// -- Save these entries for later
// -- adc r1,#
    {"adc",     2, 0x80, "r1",  "",     "",     2, 0x40, 0x01b1, 0x0000, 0x0000, 0x0000, 0x0000, 0x0000, 0x0000, 0x0000},
    {"adc-al",  2, 0x80, "r1",  "",     "",     2, 0x40, 0x01b1, 0x0000, 0x0000, 0x0000, 0x0000, 0x0000, 0x0000, 0x0000},
    {"adc-nv",  2, 0x80, "r1",  "",     "",     2, 0x40, 0x11b1, 0x0000, 0x0000, 0x0000, 0x0000, 0x0000, 0x0000, 0x0000},
    {"adc-eq",  2, 0x80, "r1",  "",     "",     2, 0x40, 0x21b1, 0x0000, 0x0000, 0x0000, 0x0000, 0x0000, 0x0000, 0x0000},
    {"adc-ne",  2, 0x80, "r1",  "",     "",     2, 0x40, 0x31b1, 0x0000, 0x0000, 0x0000, 0x0000, 0x0000, 0x0000, 0x0000},
    {"adc-cs",  2, 0x80, "r1",  "",     "",     2, 0x40, 0x41b1, 0x0000, 0x0000, 0x0000, 0x0000, 0x0000, 0x0000, 0x0000},
    {"adc-cc",  2, 0x80, "r1",  "",     "",     2, 0x40, 0x51b1, 0x0000, 0x0000, 0x0000, 0x0000, 0x0000, 0x0000, 0x0000},
    {"adc-mi",  2, 0x80, "r1",  "",     "",     2, 0x40, 0x61b1, 0x0000, 0x0000, 0x0000, 0x0000, 0x0000, 0x0000, 0x0000},
    {"adc-pl",  2, 0x80, "r1",  "",     "",     2, 0x40, 0x71b1, 0x0000, 0x0000, 0x0000, 0x0000, 0x0000, 0x0000, 0x0000},
    {"adc-vs",  2, 0x80, "r1",  "",     "",     2, 0x40, 0x81b1, 0x0000, 0x0000, 0x0000, 0x0000, 0x0000, 0x0000, 0x0000},
    {"adc-vc",  2, 0x80, "r1",  "",     "",     2, 0x40, 0x91b1, 0x0000, 0x0000, 0x0000, 0x0000, 0x0000, 0x0000, 0x0000},
    {"adc-hi",  2, 0x80, "r1",  "",     "",     2, 0x40, 0xa1b1, 0x0000, 0x0000, 0x0000, 0x0000, 0x0000, 0x0000, 0x0000},
    {"adc-ls",  2, 0x80, "r1",  "",     "",     2, 0x40, 0xb1b1, 0x0000, 0x0000, 0x0000, 0x0000, 0x0000, 0x0000, 0x0000},
    {"adc-ge",  2, 0x80, "r1",  "",     "",     2, 0x40, 0xc1b1, 0x0000, 0x0000, 0x0000, 0x0000, 0x0000, 0x0000, 0x0000},
    {"adc-lt",  2, 0x80, "r1",  "",     "",     2, 0x40, 0xd1b1, 0x0000, 0x0000, 0x0000, 0x0000, 0x0000, 0x0000, 0x0000},
    {"adc-gt",  2, 0x80, "r1",  "",     "",     2, 0x40, 0xe1b1, 0x0000, 0x0000, 0x0000, 0x0000, 0x0000, 0x0000, 0x0000},
    {"adc-le",  2, 0x80, "r1",  "",     "",     2, 0x40, 0xf1b1, 0x0000, 0x0000, 0x0000, 0x0000, 0x0000, 0x0000, 0x0000},


// -- adc r2,#
    {"adc",     2, 0x80, "r2",  "",     "",     2, 0x40, 0x01b2, 0x0000, 0x0000, 0x0000, 0x0000, 0x0000, 0x0000, 0x0000},
    {"adc-al",  2, 0x80, "r2",  "",     "",     2, 0x40, 0x01b2, 0x0000, 0x0000, 0x0000, 0x0000, 0x0000, 0x0000, 0x0000},
    {"adc-nv",  2, 0x80, "r2",  "",     "",     2, 0x40, 0x11b2, 0x0000, 0x0000, 0x0000, 0x0000, 0x0000, 0x0000, 0x0000},
    {"adc-eq",  2, 0x80, "r2",  "",     "",     2, 0x40, 0x21b2, 0x0000, 0x0000, 0x0000, 0x0000, 0x0000, 0x0000, 0x0000},
    {"adc-ne",  2, 0x80, "r2",  "",     "",     2, 0x40, 0x31b2, 0x0000, 0x0000, 0x0000, 0x0000, 0x0000, 0x0000, 0x0000},
    {"adc-cs",  2, 0x80, "r2",  "",     "",     2, 0x40, 0x41b2, 0x0000, 0x0000, 0x0000, 0x0000, 0x0000, 0x0000, 0x0000},
    {"adc-cc",  2, 0x80, "r2",  "",     "",     2, 0x40, 0x51b2, 0x0000, 0x0000, 0x0000, 0x0000, 0x0000, 0x0000, 0x0000},
    {"adc-mi",  2, 0x80, "r2",  "",     "",     2, 0x40, 0x61b2, 0x0000, 0x0000, 0x0000, 0x0000, 0x0000, 0x0000, 0x0000},
    {"adc-pl",  2, 0x80, "r2",  "",     "",     2, 0x40, 0x71b2, 0x0000, 0x0000, 0x0000, 0x0000, 0x0000, 0x0000, 0x0000},
    {"adc-vs",  2, 0x80, "r2",  "",     "",     2, 0x40, 0x81b2, 0x0000, 0x0000, 0x0000, 0x0000, 0x0000, 0x0000, 0x0000},
    {"adc-vc",  2, 0x80, "r2",  "",     "",     2, 0x40, 0x91b2, 0x0000, 0x0000, 0x0000, 0x0000, 0x0000, 0x0000, 0x0000},
    {"adc-hi",  2, 0x80, "r2",  "",     "",     2, 0x40, 0xa1b2, 0x0000, 0x0000, 0x0000, 0x0000, 0x0000, 0x0000, 0x0000},
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
    {"stc-le",  0, 0x00, "",    "",     "",     1, 0x00, 0xf00f, 0x0000, 0x0000, 0x0000, 0x0000, 0x0000, 0x0000, 0x0000},


// -- zzz -- last entry in the table
    {"zzz",     0, 0x00, "",    "",     "",     0, 0x00, 0x0000, 0x0000, 0x0000, 0x0000, 0x0000, 0x0000, 0x0000, 0x0000},


#endif
