eryjus/16bcfs/(commit log)

2023-11-05 Consolidate several repos into 1; initial commit on this repo
    [4-cycle-clock.kicad_pcb, 4-cycle-clock.kicad_sch, bus-interconnect.kicad_pcb, bus-interconnect.kicad_sch, eeprom.kicad_pcb, eeprom.kicad_sch, fetch-register.kicad_pcb, fetch-register.kicad_sch]
2023-11-19 Create ALU Adder; Replace 4-Cycle Clock with 2
    [4-cycle-clock.kicad_pcb, 4-cycle-clock.kicad_sch]
2023-11-25 Update the clock to emulate properly (#20)
    - Fixes #1
    - Completes #3
    - Completes #5
    - Completes #9
    - Completes #8
    - Completes #15
    [bus-interconnect.kicad_pcb, bus-interconnect.kicad_sch, clock-module.kicad_pcb, clock-module.kicad_sch, eeprom.kicad_pcb, eeprom.kicad_sch, fetch-register.kicad_pcb, fetch-register.kicad_sch]
2023-12-04 Add Register Module and update the Clock Module (#23)
    * Completes #13
    * Fixes #12
    * Completes #14
    * Completes #10
    * Completes #18
    * Fixes #22
    [clock-module.kicad_sch]
2023-12-20 Create the Register Module Schematic (#37)
    [16bcfs.ods, clock-module.kicad_sch, gp-register-module.kicad_pcb, gp-register-module.kicad_sch, gp-register.kicad_pcb, gp-register.kicad_sch]
2023-12-27 Create tools for SPI EEPROM programming (#38)
    * Create tools for SPI EEPROM programming
    * Closes #27
2023-12-31 Add the ALU Flags to the Emulator (#48)
    * Closes #39
    * Closes #33
    * Closes #40
    * Closes #42
    [16bcfs.ods]
2024-01-14 Asm update 001 (#66)
    * Convert all sources to c++
    This change is a brute-force move to c++ sources and some basic
    singleton classes with no change in functionality. Care was taken so
    that no new bugs were introduced. However, it might have happened.
    Note that several pre-existing bugs will be identified and added to the
    GutHub issues list.
    Closes #60
    * `.organization` architecture directive comes first
    This directive must come before any other architecture directive.
    Closes #62
    ---------
    [binary.cc, labels.cc, parser.cc]
2024-01-30 Create a Control ROM Control Circuit (#83)
    * Closes #72
    * Closes #77
    * Closes #79
    * Closes #80
    * Closes #82
2024-02-05 Add a Control ROM Control Circuit and Schematic (#92)
    * Closes #91
    * Closes #84
    * Closes #85
    * Closes #86
    * Closes #68
    * Closes #88
    [ctrl-rom-ctrl.kicad_pcb, ctrl-rom-ctrl.kicad_sch]
2024-02-17 Complete the EEPROM to SRAM copy for the Emulator
    * Closes #78
    * Closes #32
    * Closes #93
    * Starts #97
    * Closes #81
    * Closes #100
    * Closes #96
    * Update ERC to ignore spice model issues
    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
    [gui-bus-leds.cc]
2024-02-27 Video 0093 (#112)
    * Fix 74xx03 to NAND; Some additional minor corrections
    * Fixes #104
    * Closes #105
    * Closes #99
    * Closes #87
    * Defers #94
    * Defers #95
    * Add additional changes
    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
    [ctrl-rom-ctrl.kicad_sch]
2024-03-12 Create and Integrate a Control ROM Module (#116)
    * Fixes #108
    * Closes #109
    * Closes #110
    * Closes #111
    * Closes #114
    * Closes #115
    * Closes #107
    [ctrl-rom-ctrl.kicad_sch, ctrl-rom-module.kicad_pcb, ctrl-rom-module.kicad_sch]
2024-03-31 Control ROM PCB Layout (#131)
    * Closes #118
    * Fixes #126
    * Fixes #127
    * Closes #128
    * Closes #129
    * Starts #119
    * Closes #125
    [ctrl-rom-module.kicad_pcb, ctrl-rom-module.kicad_sch]
2024-04-27 Control ROM Control Cleanup (#133)
    * Closes #123
    * Closes #132
    * Completes #119
    * Defers #89
    * Defers #122
    * Defers #121
    * Defers #120
    [16bcfs.ods, ctrl-rom-ctrl.kicad_sch, ctrl-rom-module.kicad_pcb]
2024-04-30 Reorganize the Control Word
    * Closes #136
    [16bcfs.ods]
2024-05-03 Create 3-, 4-, and 7-bit demultiplexer sub-modules
    * Closes #139
    [3-bit-demux.kicad_pcb, 3-bit-demux.kicad_sch, 4-bit-demux.kicad_pcb, 4-bit-demux.kicad_sch, 7-bit-demux.kicad_pcb, 7-bit-demux.kicad_sch]
2024-05-05 Update the directive prefixes to be '.', ':', or '%' as appropriate.
    [ctrl-rom-module.kicad_pcb, ctrl-rom-module.kicad_sch]
2024-05-05 Fix an issue with KiCad
    [binary.cc, parser.cc]
2024-05-05 Change the Assembler comments to start with '//'
    * Closes #142
    * Closes #63
    * Closes #65
2024-05-08 Clean up some bugs with the Assembler
    * Fixes #65
    * Fixes #144
    * Closes #143
    * Closes #61
    * Closes #59
    * Closes #56
    * Closes #36
    * Fixes #34
    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
    [binary.cc, control.cc, labels.cc, parser.cc]
2024-05-09 Correct an issue with the assembler error formatting
2024-05-09 Video 0098 (#146)
    Add Signal De-Multiplexing:
    * Create 3-, 4-, and 7-bit demultiplexer sub-modules
    * Add IC documentation
    * Create the new 74xx238 IC for the emulator
    * Reorganize the Control Word
    * Make the EEPROM copy to SRAM optionally pedantic or quick
    * Add all 16 EEPROM to the emulator
    * Perform some basic cleanup
    * Update the directive prefixes to be '.', ':', or '%' as appropriate.
    * Fix an issue with KiCad
    * Change the Assembler comments to start with '//'
    * Clean up some bugs with the Assembler
    * Correct an issue with the assembler error formatting
    * Clean up some more issues with automated tests
    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
    [16bcfs.ods, 3-bit-demux.kicad_pcb, 3-bit-demux.kicad_sch, 4-bit-demux.kicad_pcb, 4-bit-demux.kicad_sch, 7-bit-demux.kicad_pcb, 7-bit-demux.kicad_sch, ctrl-rom-module.kicad_pcb]
2024-05-17 Video 0099 (#147)
    Control ROM Control Module PCB Design & Free-Running the Emulator
    * Closes #140
    * Closes #89
    * Closes #141
    [ctrl-rom-ctrl.kicad_pcb, ctrl-rom-ctrl.kicad_sch, ctrl-rom-module.kicad_pcb]
2024-06-07 Complete the Control Logic Mid-Plane PCB Design (#149)
    * Completes #148
    * Completes #120
    * Completes #121
    * Closes #145
    * Closes #41
    * Closes #35
    [control-logic-midplane.kicad_sch]
2024-06-07 Correct Silkscreen on the Control ROM Module
    The Control ROM Module did not have a correct silkscreen and that needed
    to be corrected prior to ordering the PCBs. This commit handles this
    fix.
    [ctrl-rom-module.kicad_pcb]
2024-06-09 Change the Fetch Register input to be Addr1
    This change is done for testing. Data should be input from Address Bus
    1 for the short term. This then allow the the LEDs to be tested on the
    Fetch Register. The LEDs do not work. I belive it is the clock.
2024-06-09 Add some temp debug controls for testing
    This commit adds some temporary debug control for testing. It also
    uncovers several issues with the emulator at this point.
    These include but are not limited to:
    * Multiple asserts on the Main Bus
    * Instruction Bus is being directly asserted to by the Fetch Reg
    * ALU B and Addr 2 asserts may or may not be working properly
    * First updates may or may not be working properly (dip switch updates
    missing?)
2024-06-09 Commit a change the the KiCad proejct files
    THis change was a tickle from opening and reviewing the Fetch Register.
    It is simple a maintenance commit, which will be reviewed and updated
    with a subsequent commit.
2024-06-09 Correct an issue with the Control ROM Control Mod
    The Control ROM Control Module MUXes in the emulator were all tied to
    the least significant nibble on the instruction coming from the
    instruction register.
    This is obviously not correct.
    This commit updates the Control ROM Control Module to properly
    distribute those signals so that each MUX input pin has its own unique
    and correct signal.
    I reviewed the schematic and there are no issues there, so I did that
    translation for the schematic without validating against the emulator
    code.
2024-06-09 Ensure dip switch initial state is published
    The dip switches of the test setup for the Fetch Register were not
    properly publishing their initial state. To make that happen, the state
    of the dip switch needed to be toggled in software.
    This commit addresses this. Expect the code to be removed in a future
    commit.
2024-06-10 Move Ctrl ROM LEDs after the Latch
    This change moves the LED to be driven after the Latch whereas it was
    before the latch prior. Somewhere along the line, the pedantic copy
    broke. I was not testing that with each commit.
2024-06-10 Remove test code and start to hook up Ctrl Logic
    This completes the changes for the Fetch Register Module integration for
    the emulator. In this commit the test code is removed and the Control
    Logic is wired up to the PC and Fetch registers.
2024-06-11 Draft a first update to the Fetch Reg Schematic
    Here I take a first cut at updating the the Fetch Register Schematic.
    No checks have been completed, just component renames and reductions.
    A complete audit against the code is still required.
    [fetch-register.kicad_sch]
2024-06-12 Update the Fetch Register Schematics
    This commit updates the Fetch Register Schematics to reflect the new
    design. As far as I can tell at the time of this commit, all changes
    are properly reflected and no other changes are expected, except maybe
    adding a test point or 2 as the situation on the PCB dictates.
    [fetch-register.kicad_sch]
2024-06-12 Update the big-picture component placement
    For the Fetch Register, all components needed to be removed and
    re-placed into the PCB. This commit is a first cut at that placement to
    try to arrange the PCB. The PCB can be shrunk quite a bit (maybe by
    25%?) and this commit preceeds those changes.
    Some changes were made to the schematic in order to drive more
    efficient trace routing.
    [fetch-register.kicad_pcb, fetch-register.kicad_sch]
2024-06-13 Collapse and Organize the left of the PCB
    The left side of the PCB was organized with this commit. It is reduced
    in height by about 1/4 to 1/3. This than sets the desired height for
    the entire PCB.
    [fetch-register.kicad_pcb]
2024-06-13 Complete Component Placement on the Fetch Reg PCB
    This commit handles all the component placement on the PCB for the Fetch
    Register ahead of routing traces. The expectation is that there is
    plenty of room for traces.
    Nothing has been done for 0R Resistors or test points yet. Those will
    be added ahead of routing.
    [fetch-register.kicad_pcb, fetch-register.kicad_sch]
2024-06-13 Add 0R Resistors and Test Points to the PCB
    Get this done before routing the PCB
    [fetch-register.kicad_pcb, fetch-register.kicad_sch]
2024-06-13 Complete the routing for the Fetch Register PCB
    This commit completes the routing for the PCB, unless something needs to
    move to make room for silkscreen.
    [fetch-register.kicad_pcb, fetch-register.kicad_sch]
2024-06-14 Complete the silkscreen on the Fetch Register
    This commit completed the silkscreen for the fetch register.
    Overall, this is the completion of the Fetch Register design and PCB
    layout.
    [fetch-register.kicad_pcb]
2024-06-14 Add Teardrops to the traces on the PCB
    Now it is complete. I think.
    [fetch-register.kicad_pcb]
2024-06-18 Create an Instruction Register
    The insturction register is created as a simple bus observer with LEDs
    to display the contents. The contents are latched at the proper time
    and therefore displayed for an entire clock cycle, locking the value at
    the rising edge.
2024-06-20 Complete the Schematic and PCB designs
    This commit:
    * Closes #160
    * Closes #161
    The Schematic and PCB design are both complete.
    [instr-register-module.kicad_pcb, instr-register-module.kicad_sch]
2024-08-20 Create a Program ROM Module
    This commit creates a Program ROM Module and loads the contents from
    disk. With this commit, there are concerns with the Control ROM Control
    Module LEDs, which still need to be addressed. Overall the Program ROM
    Module appears to work properly.
2024-08-24 Remove LEDs from the Control ROM Control Module
    This change is to eliminate the confusion related to the LEDs on the
    Control ROM Control Module. At the same time a new purpose-built test
    was added to assess the validity of the Control Signals coming from the
    Control ROMs themselves. There are Control Signal issues.
2024-08-24 Split the rising edge of the clock into 2 phases
    This change make sure that the D-Type latches have a latch phase and an
    output phase, to make sure that the synchronization is correct. This
    change helps to overcome the linear nature of the emulator.
    It is not 100% complete and additional cleanup will be necessary.
    [control.cc]
2024-11-03 Create the Reset Module and (mostly) debug it
    [closk-selection.kicad_sch, ctrl-rom-ctrl.kicad_sch, manual.kicad_sch, post-reset.kicad_sch, power-on-reset.kicad_sch, reset.kicad_pcb, reset.kicad_sch, state.kicad_sch]
2024-11-05 Added some debugging code
    This is still not working. I will need to revamp the reset routines for
    the emulator to get this to work properly. Everything will need an
    initial state on construction and a `reset()` routine to place
    everything into a proper state. This in itself will be a major change.
    [closk-selection.kicad_sch, manual.kicad_sch, post-reset.kicad_sch, power-on-reset.kicad_sch, reset.kicad_sch, state.kicad_sch]
2024-11-09 Make a number of changes to the schematic and emulator
    These changes are incremental to getting the emulator to work, they are
    needed for making sure that the RESETTING, CLOCKING, and RUNNING signals
    are processed properly.
    There is also quite a bit of debugging code which gets added/removed
    ahead of this commit.
    [closk-selection.kicad_sch, post-reset.kicad_sch, reset.kicad_sch, state.kicad_sch]
2024-11-10 Make the final changes needed to get the Reset Circuit working
    [state.kicad_sch]
2024-11-15 Reset Circuit Schematic PDF Update
2024-11-16 Organize the 74HC00 gates better
    Make better use of the NAND gates in the layout to make it easier for
    wiring on breadboard and PCB.
    * Closes #194
2024-11-16 Correct a save issue with KiCad
    [post-reset.kicad_sch, state.kicad_sch]
2024-11-17 Relocate the unused gates for efficiency
    [closk-selection.kicad_sch, reset.kicad_sch, state.kicad_sch]
2024-11-28 Address some issues with the Reset Logic
    There were a couple of fixes. One in relation to how the 74xx123 IC was
    emulated and others to the schematic to address issues in real life in
    the breadboard prototype.
    [closk-selection.kicad_sch, power-on-reset.kicad_sch, reset.kicad_sch, state.kicad_sch]
2024-12-03 Clean up the silkscreen on the Control ROM Module
    This includes a footprint update, moving some labels around, and adding
    a desription for the PCB.
    [ctrl-rom-module.kicad_pcb]
2024-12-04 Complete the existing bodge on the PCB
    An existing bodge was updated in the schematic and this was extended to
    the PCB design of the Control ROM Control Module.
    Additionally, the footprints were updated.
    I also took the opportunity to update a trace which bounced around a
    bit.
    [ctrl-rom-ctrl.kicad_pcb]
2024-12-04 Remove the LEDs from the Control ROM Control Module
    The LEDs are not populated on the first iteration PCB. Remove them from
    the schematic and from the PCB design.
    [ctrl-rom-ctrl.kicad_pcb, ctrl-rom-ctrl.kicad_sch]
2024-12-05 Resolve the Control ROM Control pin alignment
    This resulted in a major change to the PCB layout.
    [ctrl-rom-ctrl.kicad_pcb, ctrl-rom-ctrl.kicad_sch]
2024-12-06 Rename #RHLD to #CPYHLD on the Ctrl Rom Ctrl & Midplane
    The logic for the signal does not change, but the purpose does. The
    Reset Circuit will handle the #RHLD now, but it needs to know when the
    copy is complete.
    [control-logic-midplane.kicad_sch, ctrl-rom-ctrl.kicad_pcb, ctrl-rom-ctrl.kicad_sch]
2024-12-06 Rename RESET_CLK
    This also forces a rename of the SYSCLK on the Reset Schematic to be
    HS_CLK. The new name of the RESET_CLK is SYS_CLK.
    [closk-selection.kicad_sch, reset.kicad_sch]
2024-12-06 Clean up some issues with the Control Logic Mid-Plane
    This includes a silkscreen error and relocating some capacitors.
2024-12-25 Look at the MAX704 uProcessor Supervisor
    This commit adds the documentation for the MAX704 supervisor. Some
    minor update in teh Control Rom Control circuit are added as well.
    Closes #198
    [ctrl-rom-ctrl.kicad_pcb, ctrl-rom-ctrl.kicad_sch]
2024-12-29 Update the Reset Module
    This commit updates the reset module to reflect the changes made on the
    breadboard which stabilized the build.
    [state.kicad_sch]
2024-12-31 Update the Clock Module schematics
    This is what I hope will be the final incarnation of the clock module,
    making it all the way to the final build.
    [adjustable.kicad_sch, clock-module.kicad_sch, oscillator.kicad_sch, state.kicad_sch, step.kicad_sch, transition.kicad_sch]
2025-01-13 Clean up the Reset and Clock Modules
    [adjustable.kicad_sch, clock-module.kicad_sch, reset.kicad_sch, state.kicad_sch, step.kicad_sch, transition.kicad_sch]
2025-01-23 Schematic changes for clock and control ROM
    [16bcfs.ods, control-logic-midplane.kicad_sch, ctrl-rom-ctrl.kicad_pcb, ctrl-rom-ctrl.kicad_sch, transition.kicad_sch]
2025-02-02 Some KiCad Cleanup
    [closk-selection.kicad_sch, oscillator.kicad_sch, reset.kicad_sch]
2025-02-15 Fix the Fetch Register LEDs signal direction
    Also changes the Emulator from the pedantic copy mode.
    [fetch-register.kicad_sch]
2025-02-15 Updte LED polarity on the fetch register
    [fetch-register.kicad_sch]
2025-04-20 Add code and controls for BRK and JMP
    We are executing real code again.
    [16bcfs.ods]
